RonnyA/nd-120/Logisim/readme.md

# Logisim files #

There are 4 sets of Logisim schematic files

* [DELILAH CPU](DELILAH-CPU/readme.md)
* [Decoder Gate Array](DECODE-GateArray/readme.md)
* [3202D CPU Board](CPU-BOARD-3202/readme.md)
* [SMD controller card 3044 - memory address and word count](ND-BUS-DEVICES/SMD-3044/readme.md)

## Screenshot of Logisim schematich - part of DELILAH

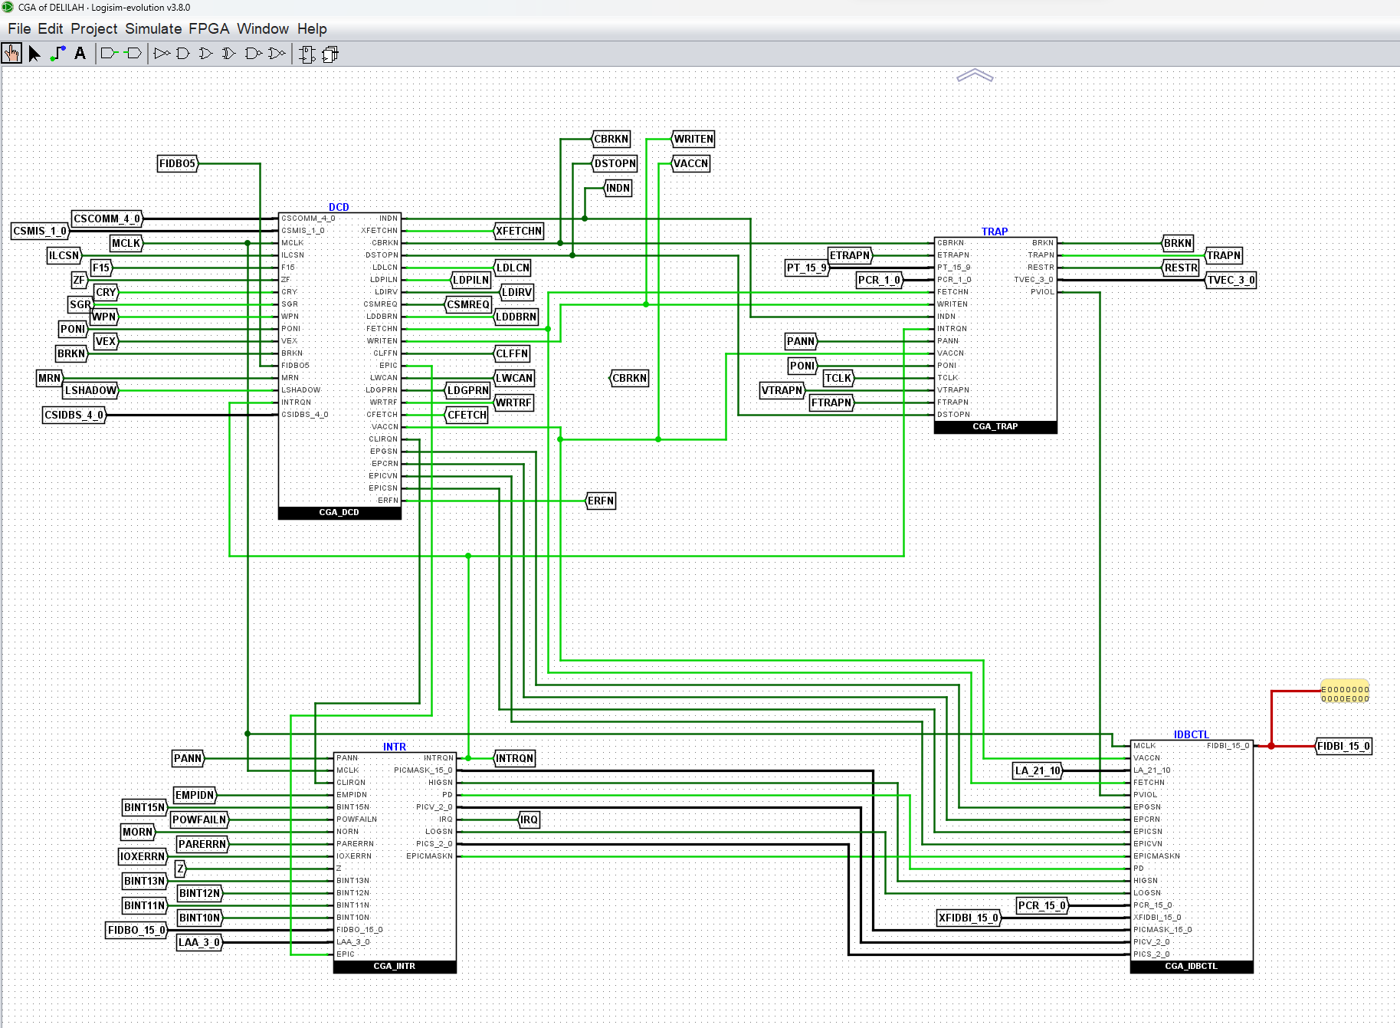
[picture p1: Logisim/Logisim-DELILAH.png]
Logsim schematic - part of DELILAH
