RonnyA/nd-120/DesignDocuments/DELILAH-CPU/readme.md

# DELILAH CPU

 This folder contains the 106 page design document for the CPU.
* [DELILAH Schematic Design ](DELILAH.pdf)
