RonnyA/nd-120/DesignDocuments/Other/Readme.md

# Other design documents

This folder contains low DPI (200 DPI) scan of two complete binders with design documents for the ND-120.
They contain multiple versions of the 3202 CPU board, and if you want the high-res scan (600 DPI) its in another folder.

* [Binder 1](Binder-1.pdf)
* [Binder 2](Binder-2.pdf)
