RonnyA/nd-120/Code/68705/readme.md

# PROM Dumps

* ND-120 PANEL - ONBOARD PANEL CONTROLLER - MC68705U3
* ND-5000C Panel

## ND-120 CPU BOARD - ONBOARD PANEL CONTROLLER - MC68705-U3

The panel controller controls the LCD display in the panel, and handles button presses and sends that to the CPU board.

### Schematic

Sheet 40 of the CPU Board has the MC68705 connectins

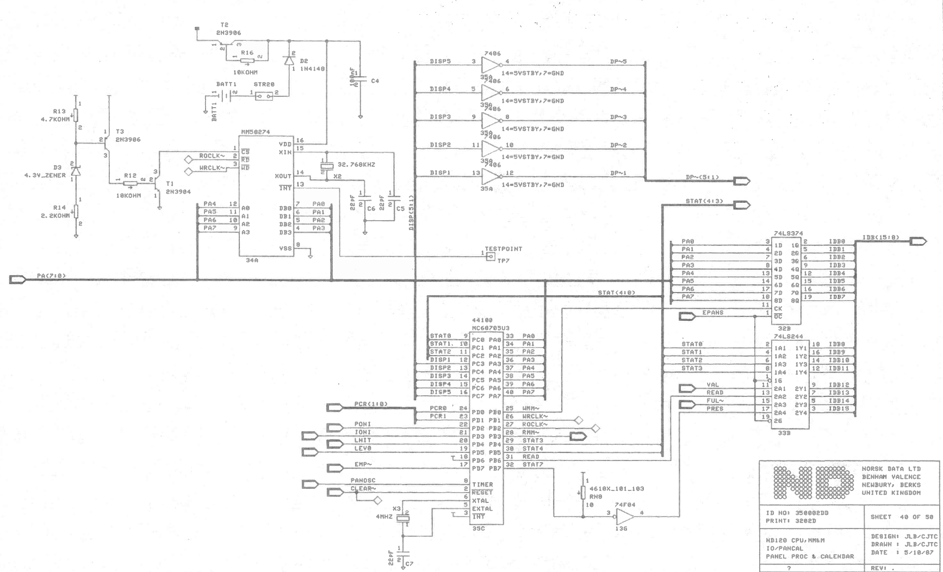
[picture p3: Code/68705/3202D_PANCAL_SHEET40.png]
Schematich for 68705


### U3 Block Diaggram

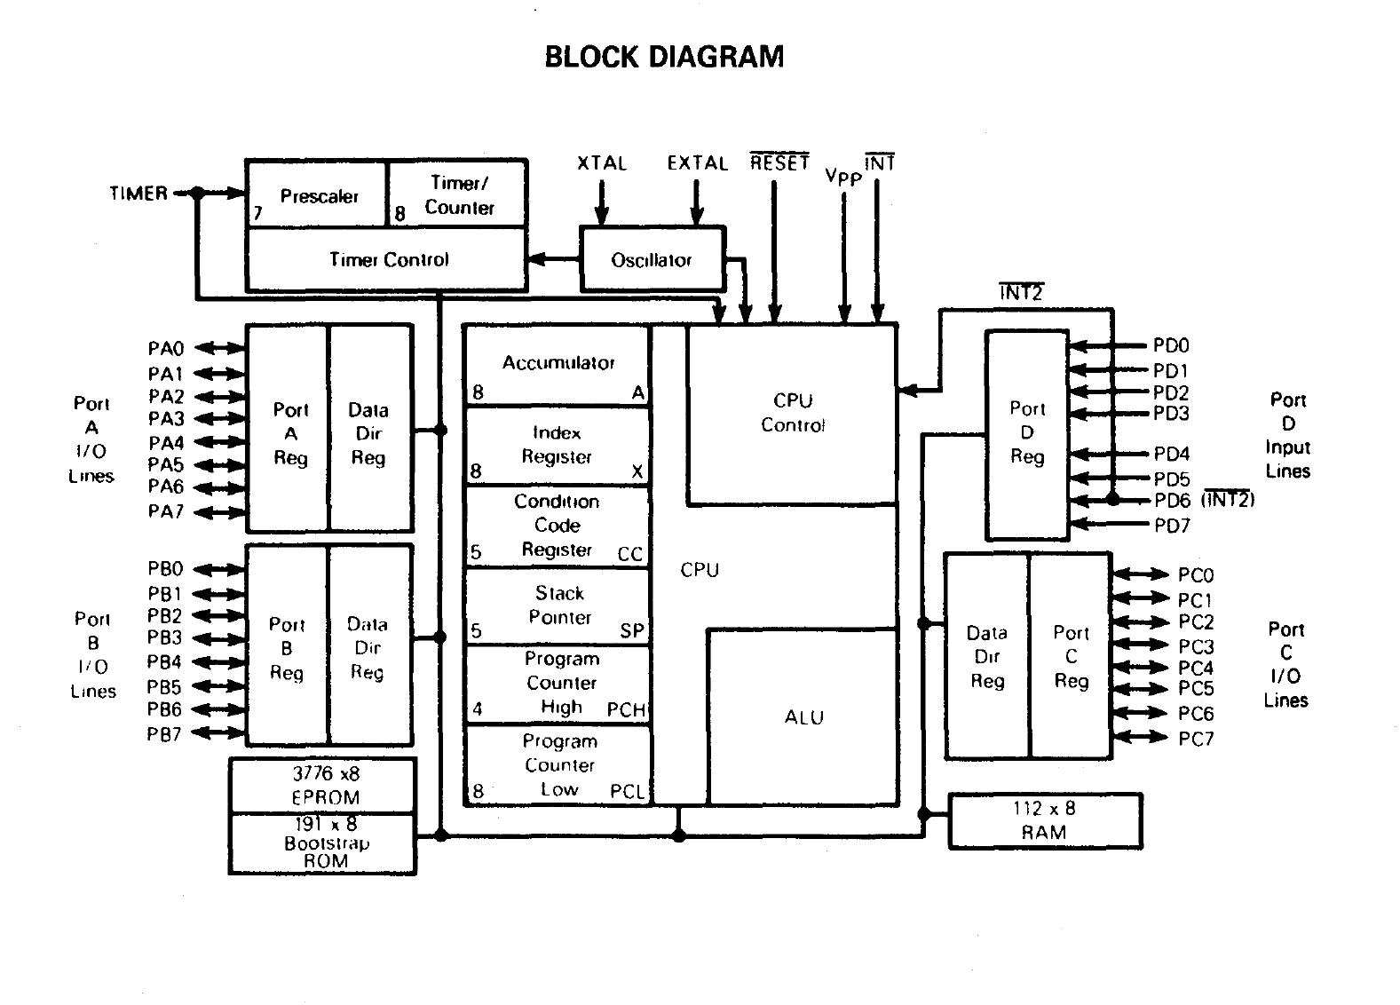
[picture p4: Code/68705/68705U3_Block_Diagram.png]
68705 U3 Block Diaggram


### U3 PROM

[Binary PROM dump from MC68705-U3 on ND-120 CPU Board](MC68705U3_35C.BIN)

### U3 Analysis of functionality

[Analysis of the code in the PROM](U3/Analysis-U3.md)

### U3 Analysis of commands

[Analysis of commands and responses](U3/Commands-U3.md)

### U3 Dissasembly

PROM dump reverse engineered with Ghidra

[68705-U3 Dissassembly PDF](U3/U3-Dissassembly.pdf)

### U3 C code

Reverse engineered C code (draft)
[68705-U3 as C code](U3/C-code-u3.md)

-----

## The ND-5000C PANEL - MC68705-P3

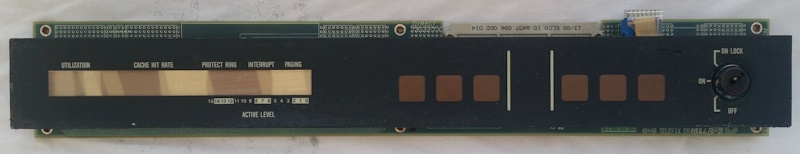
[picture p5: Code/68705/ND-5000C-PANEL.png]
Panel Operator including display


### Panel Controller

The panel uses an MC68705P3 (Which is not the same as the U3 used on the ND-120 CPU board.)
The 68705P3 is 28 pins with 3 ports (PORT A,B and C)

Reference NORSK-DATA.COM:

* [323165 - PCB 1844 - Panel Operator including display, ND-5000C](http://www.norsk-data.com/hardware/nd-other/nd-323165.html)
* [324494 - PCB 1834 - Panel Control](http://www.norsk-data.com/hardware/nd-other/nd-324494.html)
* [xxxxxx - PCB xxxx - LCDs](http://www.norsk-data.com/hardware/nd-other/nd-LCD.html)
* [324147 - PCB 1844 - Telefix/Driver Comson](http://www.norsk-data.com/hardware/nd-other/nd-324147.html)
* [CY7C401 - FIFO](http://www.norsk-data.com/library/libother/extern/CY7C401.pdf)

### P3 PROM

[Binary PROM dump from MC68705-R3](P3/ND-5000C-MC68705P3.BIN)

### P3 Analysis

[Analysis of the code in the R3 PROM](P3/P3-COMPLETE.MD)

### R3 Dissasembly

PROM dump reverse engineered with Ghidra

[68705-P3 Dissassembly PDF](P3/P3-Dissassembly.pdf)

### R3 C code

Reverse engineered C code (draft)
[68705-P3 as C code](P3/C-code-p3.md)

-----

# 6805 CPU doc

* MC68705P3, 18 page PDF - [MC68705PR 8-BIT EPROM Microcomputer Unit](6805/MC68705P3.PDF)
* 6805P_Oct84, 15 page PDF - [MC68(7)05P SERIES 8-BIT MICROCOMPUTERS](6805/6805P_Oct84.pdf)
* 6805_Users_Manual_2ed_1983, 263 page PDF - [M6805 HMOS/M146805 CMOS FAMILY USERS MANUAL](6805/6805_Users_Manual_2ed_1983.pdf)
* Motorola DL139, 995 page PDF (U3 from Page 3-684) -  [Microprocessor, Microcontroller and Peripheral - Volume I](6805/1988MicroprocessorMicrocontrollerandPeripheralDataVolume1.410212374.pdf)
