RonnyA/nd-120/Verilog/CPU-BOARD-3202/circuit/BIF_DPATH_PPNLBD_14/readme.md

# BIF / DPATH / PPNLBD

BIF PPN TO LBD

## CPU Board 3202D - Sheet 14

### Test program verification

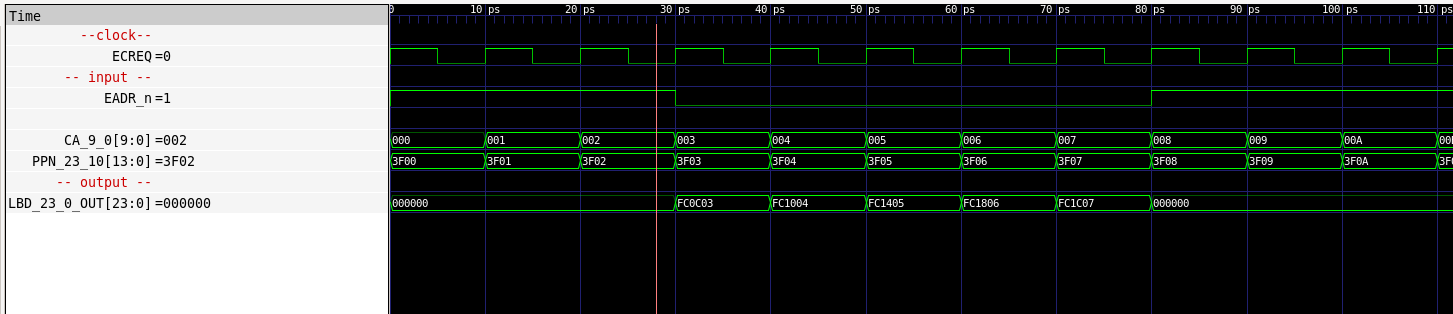
[picture p9: Verilog/CPU-BOARD-3202/circuit/BIF_DPATH_PPNLBD_14/gtkwave.png]
Screenshot from GTKWave
