RonnyA/nd-120/Verilog/Shared/support/SC2661_UART/readme.md

# SC2661 UART

The SC2661 is a UART (Universal Asynchronous Receiver/Transmitter) chip

### Test program verification

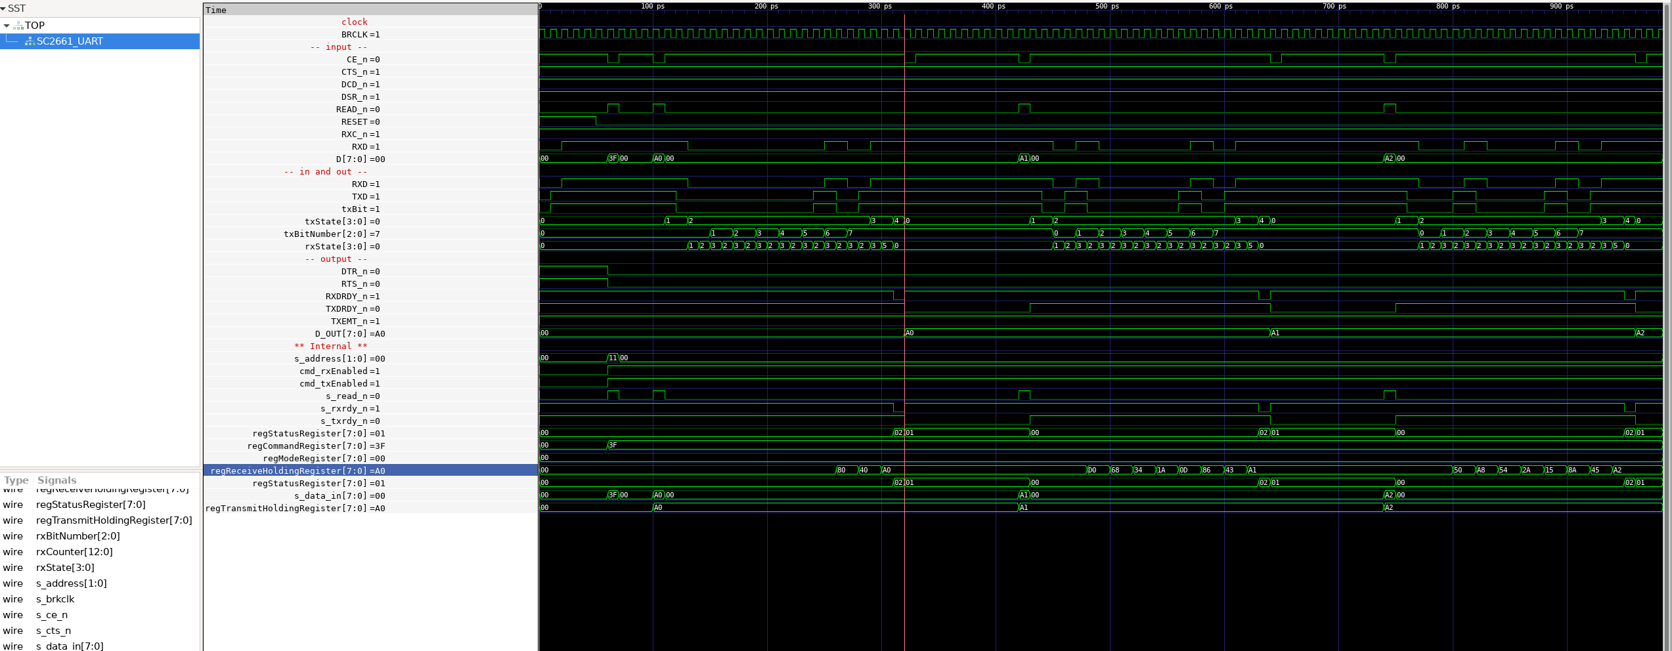
[picture p12: Verilog/Shared/support/SC2661_UART/gtkwave.png]
Screenshot from GTKWave
