RonnyA/nd-120/Verilog/CPU-BOARD-3202/circuit/CPU_MMU_24/readme.md

# CPU/MMU      

MMU TOP LEVEL  

## CPU Board 3202D - Sheet 24

### Test program verification

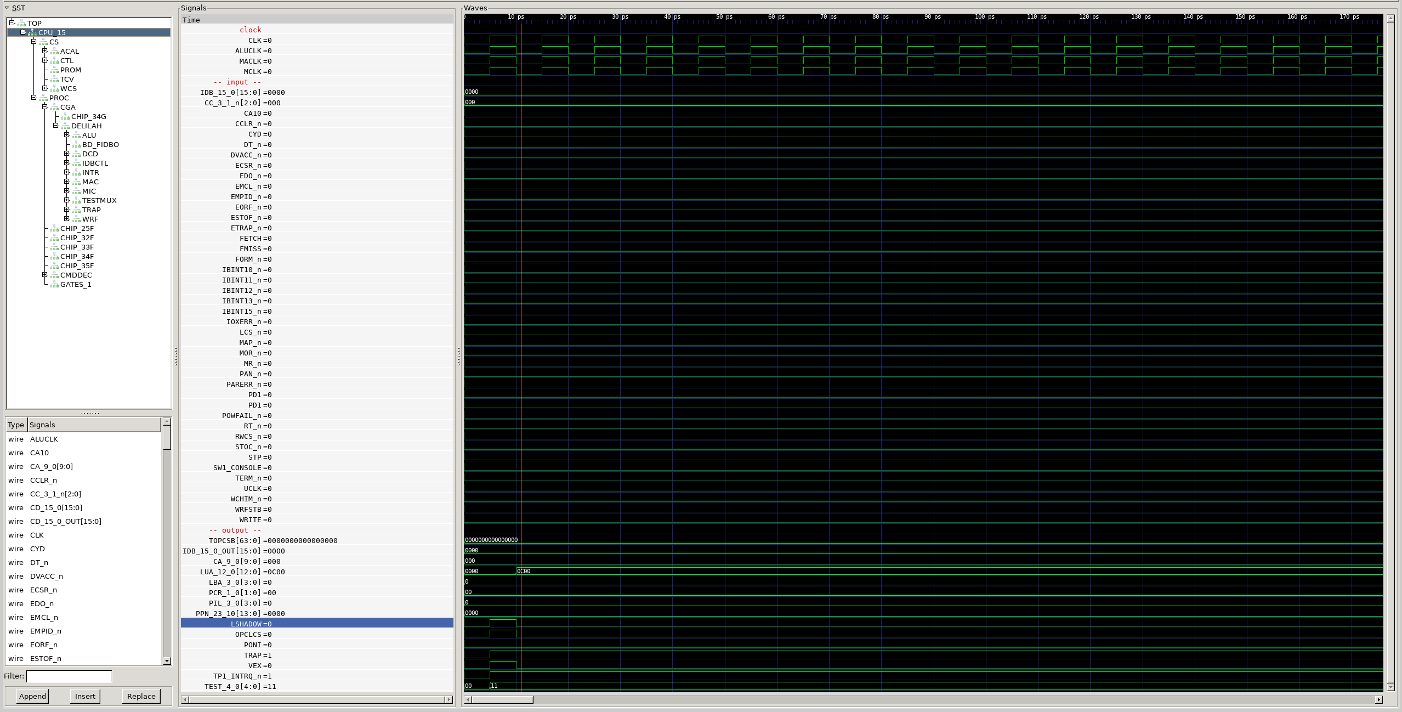
[picture p13: Verilog/CPU-BOARD-3202/circuit/CPU_MMU_24/gtkwave.png]
Screenshot from GTKWave
