RonnyA/nd-120/Verilog/CPU-BOARD-3202/circuit/BIF_BCTL_SYNC_8/readme.md

# BIF/BCTL/SYNC   

IF SYNC     

## CPU Board 3202D - Sheet 6

### Test program verification

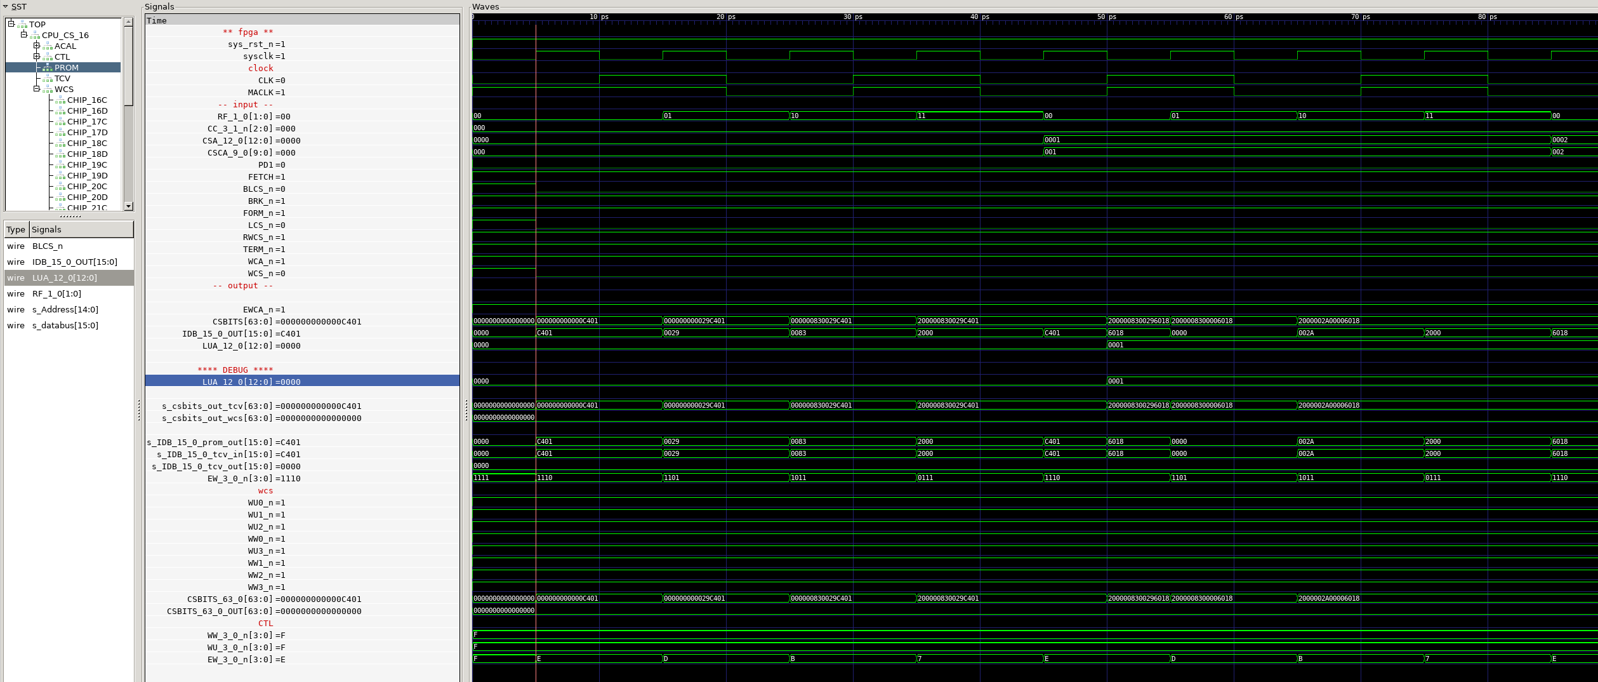
[picture p14: Verilog/CPU-BOARD-3202/circuit/BIF_BCTL_SYNC_8/gtkwave.png]
Screenshot from GTKWave
