RonnyA/nd-120/Verilog/CPU-BOARD-3202/circuit/CYC_36/readme.md

# CYCLE CONTROL (CYC)

## CPU Board 3202D - Sheet 36

# Test program verification

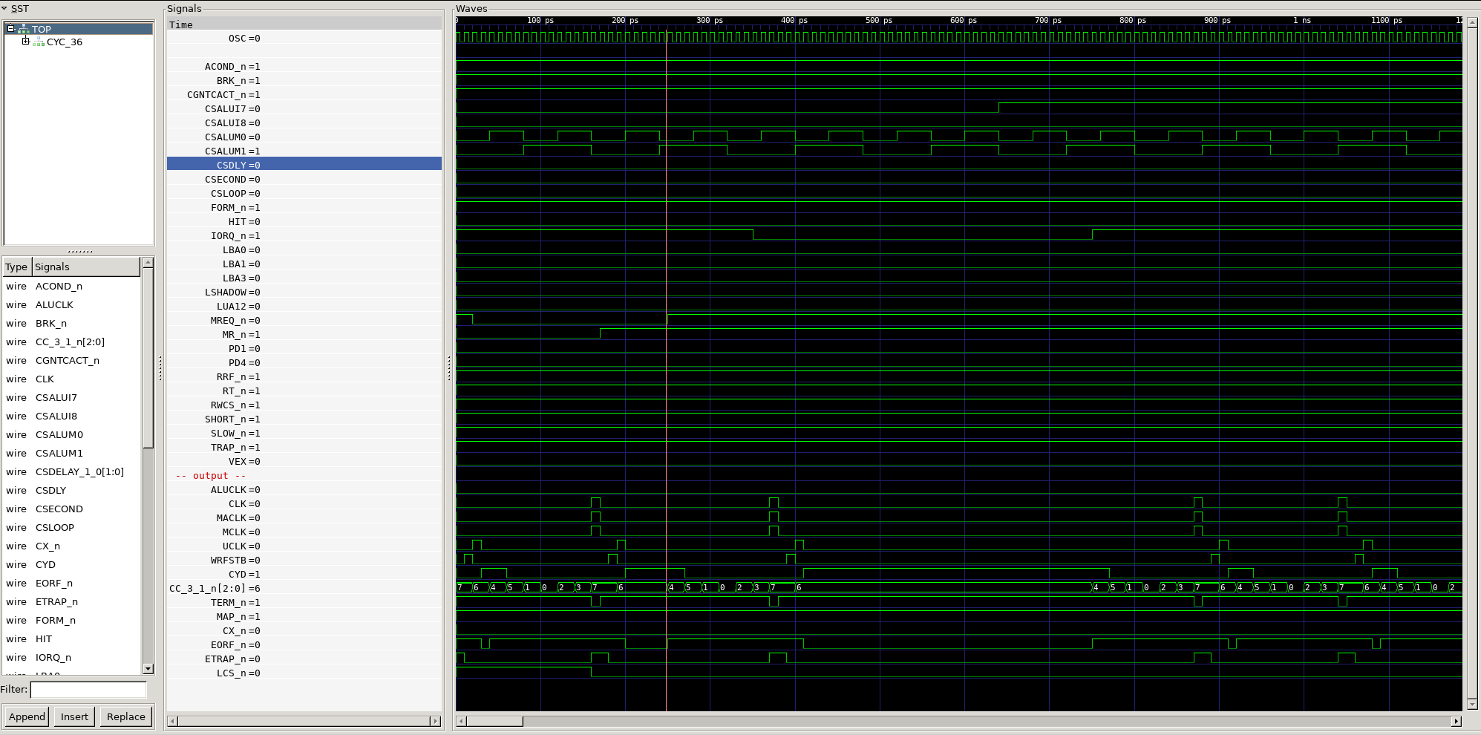
[picture p15: Verilog/CPU-BOARD-3202/circuit/CYC_36/gtkwave.png]
Screenshot from GTKWave
