RonnyA/nd-120/Verilog/CPU-BOARD-3202/circuit/CPU_15/readme.md

# CPU

CPU TOP LEVEL

## CPU Board 3202D - Sheet 15

### Test program verification

Screenshot from GTKWave
