RonnyA/nd-120/Verilog/CPU-BOARD-3202/circuit/ND3202D/readme.md

# CPU

DELILAH TOP LEVEL, CPU BOARD

## CPU Board 3202D - Sheet 1

### Test program verification

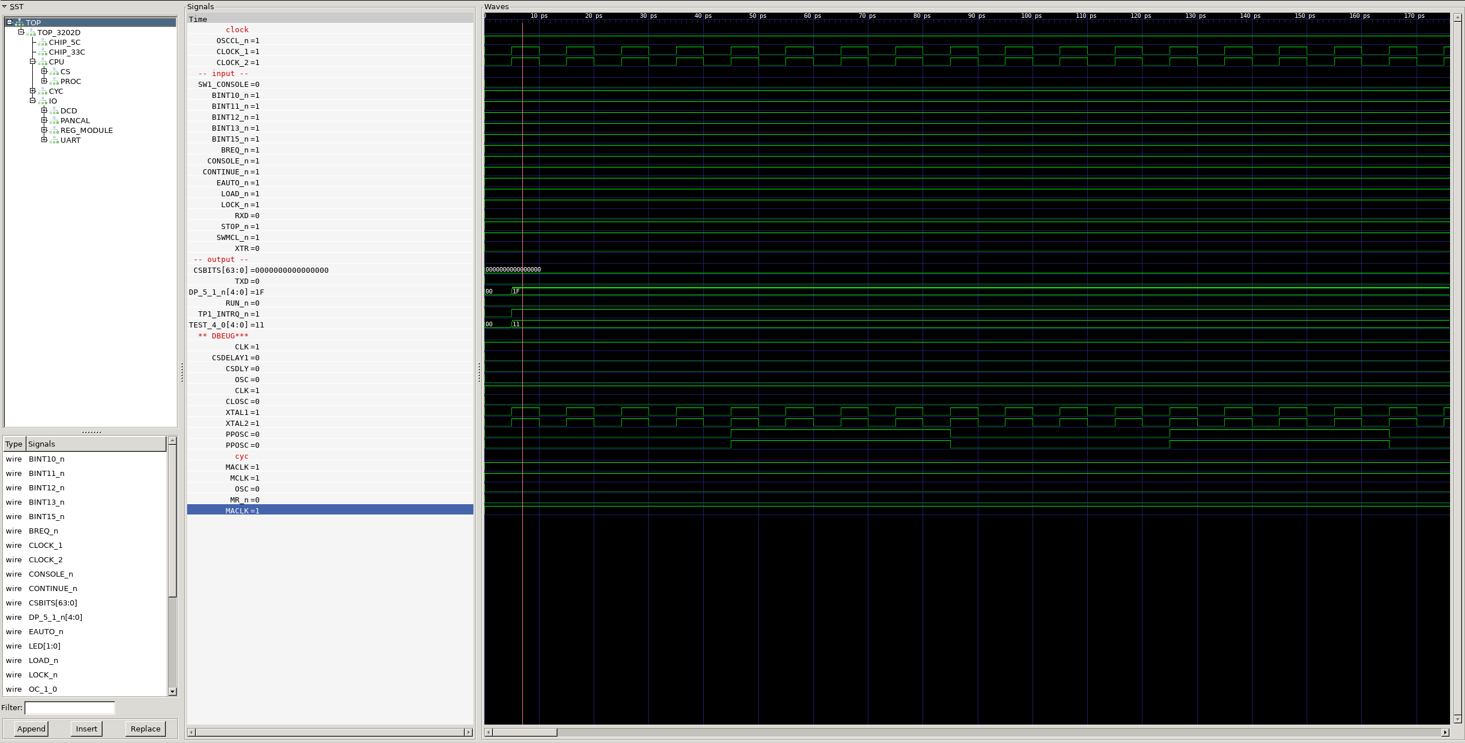
[picture p16: Verilog/CPU-BOARD-3202/circuit/ND3202D/gtkwave.png]
Screenshot from GTKWave
