RonnyA/nd-120/Verilog/CPU-BOARD-3202/circuit/CPU_CS_16/readme.md

# CPU/CS

CONTROL STORE

## CPU Board 3202D - Sheet 16

### Test program verification

Screenshot from GTKWave
