RonnyA/nd-120/Verilog/CPU-BOARD-3202/circuit/CPU_CS_TCV_20/readme.md

# CPU_CS_TCV_20

CONTROL STORE TRANSCEIVERS

## CPU Board 3202D - Sheet 20

### Test program verification

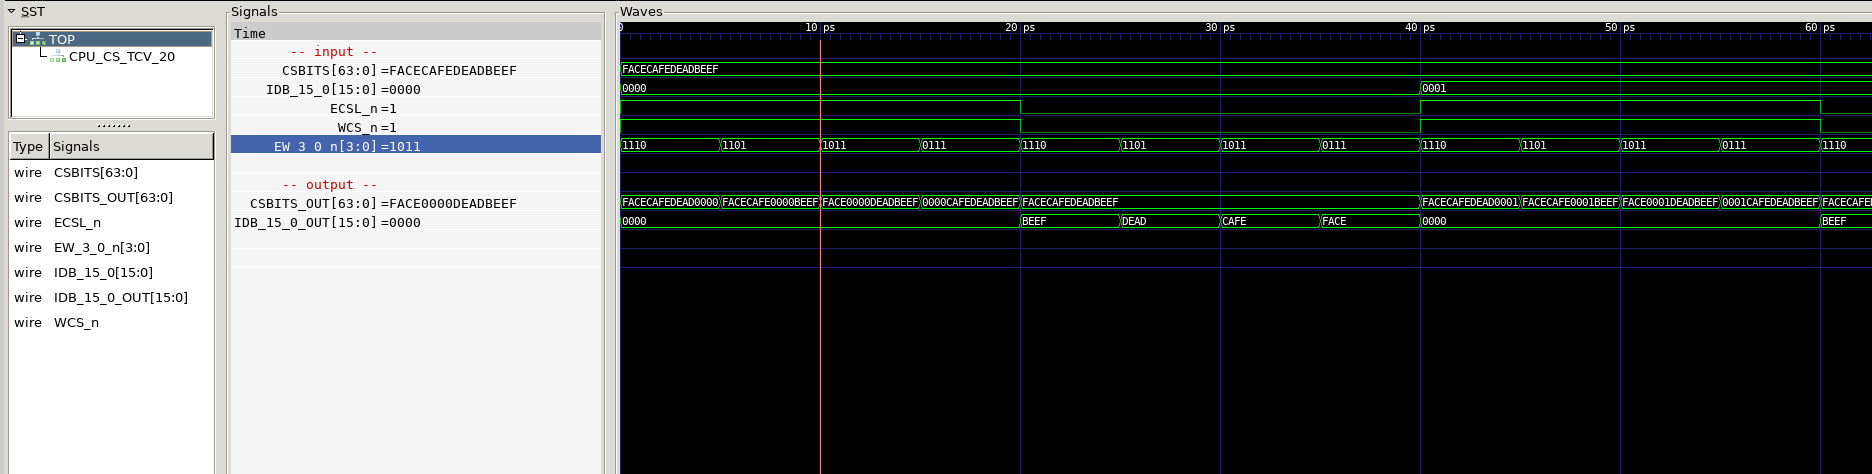
[picture p17: Verilog/CPU-BOARD-3202/circuit/CPU_CS_TCV_20/gtkwave.png]
Screenshot from GTKWave
