RonnyA/nd-120/Verilog/CPU-BOARD-3202/circuit/CPU_CS_WCS_21_22/readme.md

# CPU/CS/WCS

WRITABLE CONTROL STORE

## CPU Board 3202D - Sheet 19

### Test program verification

Test code writes 32 addressed to LUA and UUA. Output values while both are selected will be from LUA

Then reads the contents of UUA, same 32 addresses.

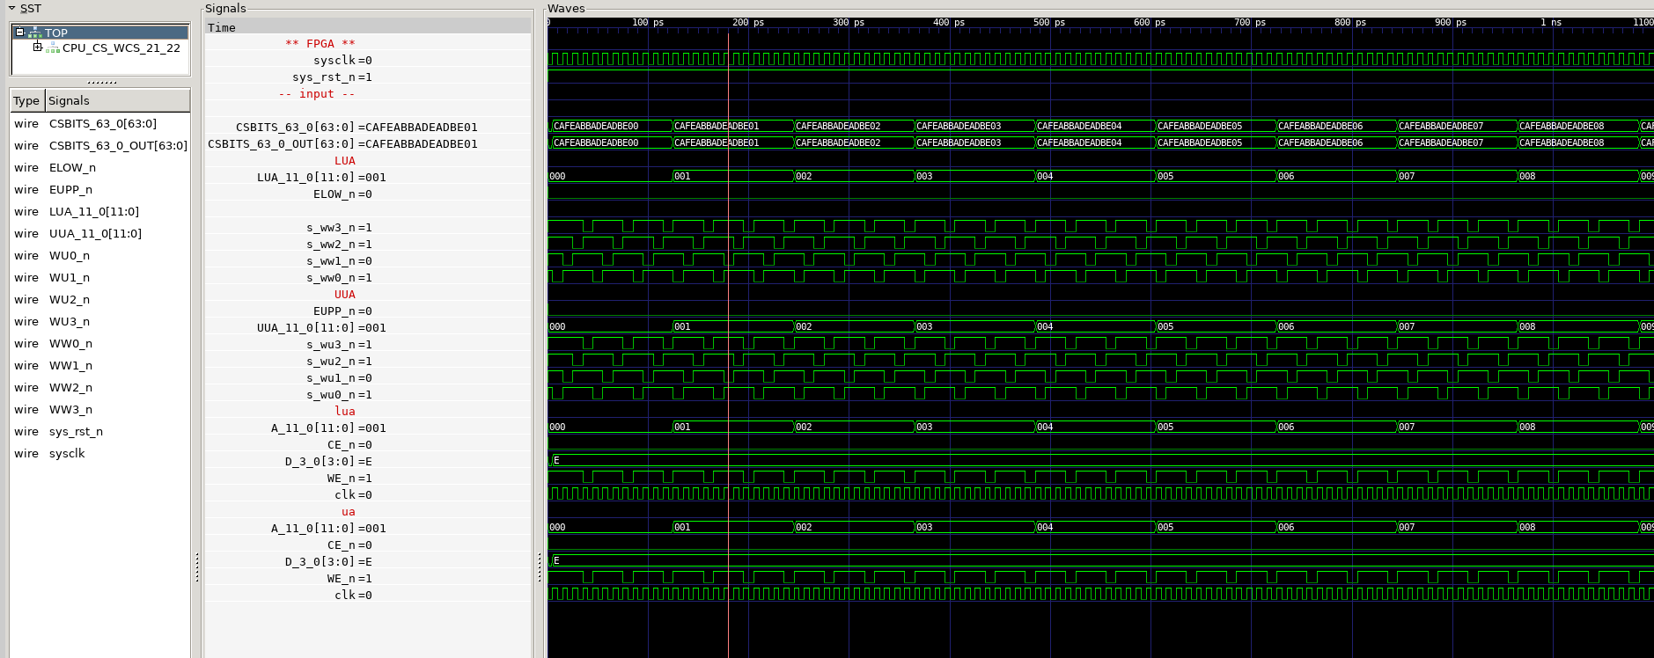
[picture p18: Verilog/CPU-BOARD-3202/circuit/CPU_CS_WCS_21_22/gtkwave.png]
Screenshot from GTKWave
