RonnyA/nd-120/Verilog/CPU-BOARD-3202/circuit/CPU_CS_PROM_19/readme.md

# CPU/CS/PROM

MICROCODE PROM

## CPU Board 3202D - Sheet 19

### Test program verification

The IDB values show the microcode. 16 bits.

RF selects which part of the 64 bit microcode, and LUA is the microcode address.

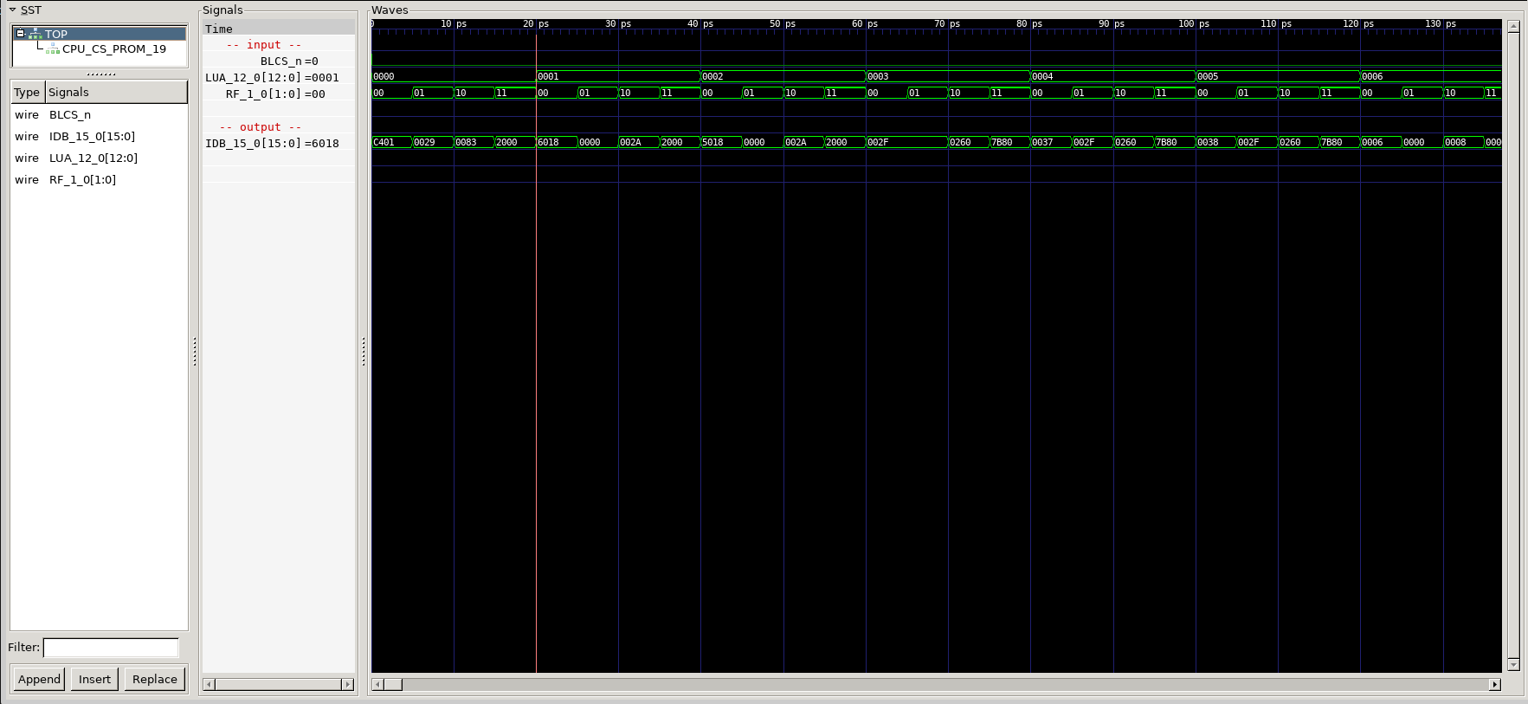
[picture p19: Verilog/CPU-BOARD-3202/circuit/CPU_CS_PROM_19/gtkwave.png]
Screenshot from GTKWave


We can see the microcode at address 0 is

<h1>0x200000830029C401</h1>

MICRO-DELI-INSTR Address 0
