RonnyA/nd-120/Verilog/CPU-BOARD-3202/circuit/CPU_CS_CTL_18/readme.md

# CPU/CS/CTL

CS CONTROL

## CPU Board 3202D - Sheet 18

### Test program verification

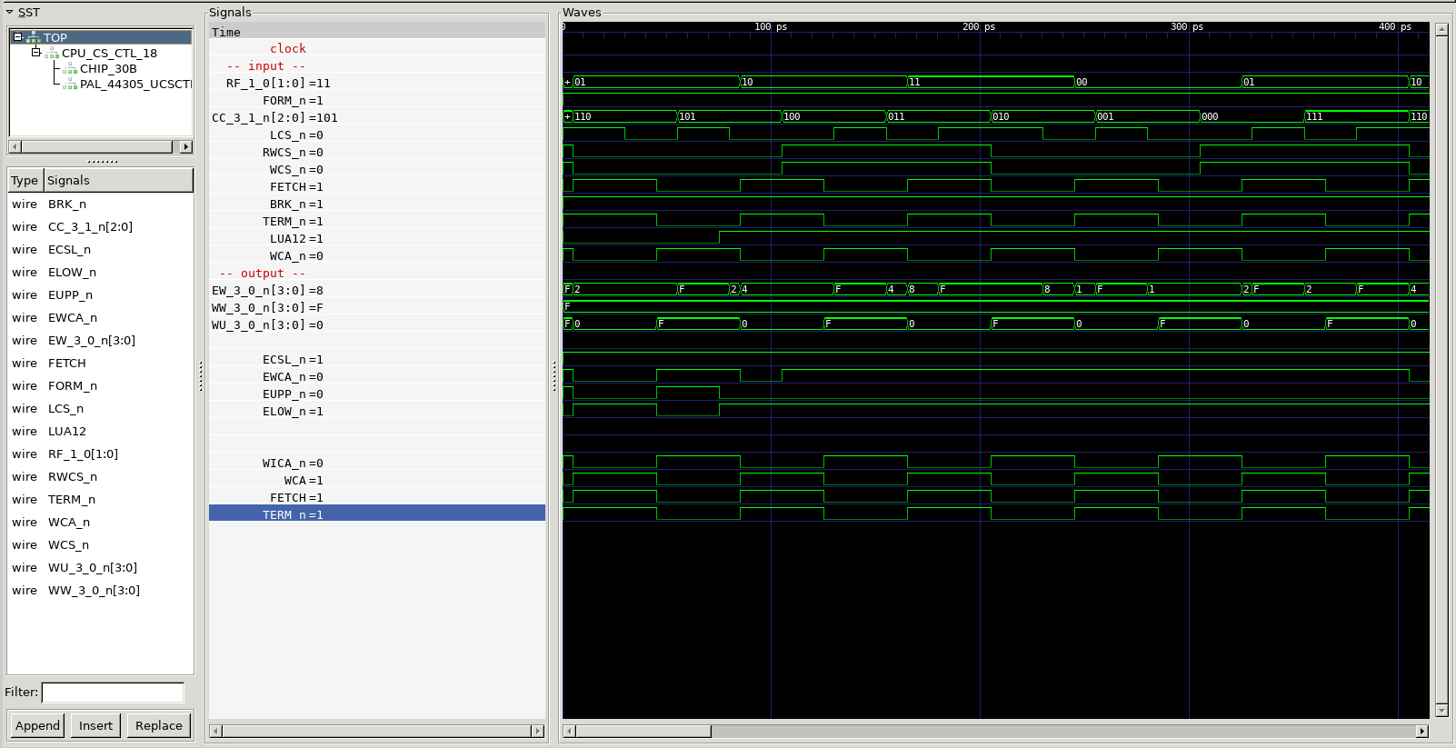
[picture p20: Verilog/CPU-BOARD-3202/circuit/CPU_CS_CTL_18/gtkwave.png]
Screenshot from GTKWave
