RonnyA/nd-120/Verilog/CPU-BOARD-3202/circuit/CPU_CS_ACAL_17/readme.md

# CPU/CS/ACAL

MICRO ADDR CALC

## CPU Board 3202D - Sheet 17

### Test program verification

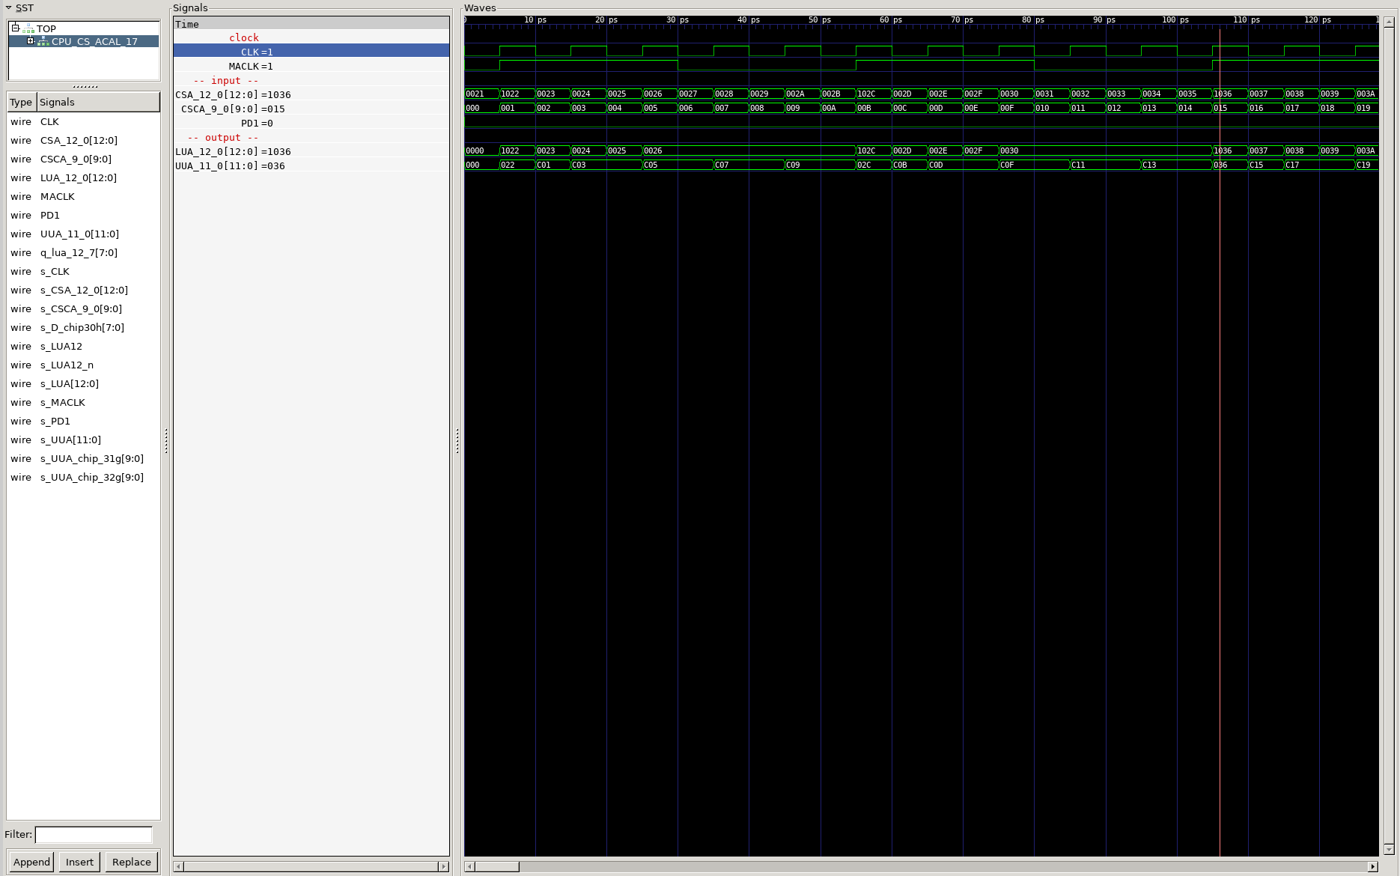
[picture p21: Verilog/CPU-BOARD-3202/circuit/CPU_CS_ACAL_17/gtkwave.png]
Screenshot from GTKWave
