RonnyA/nd-120/Verilog/CPU-BOARD-3202/circuit/CPU_PROC_32/readme.md

# CPU GATE ARRAY (CPU/PROC)
Processor Top Level

## CPU Board 3202D - Sheet 32

# (empty) Test program verification

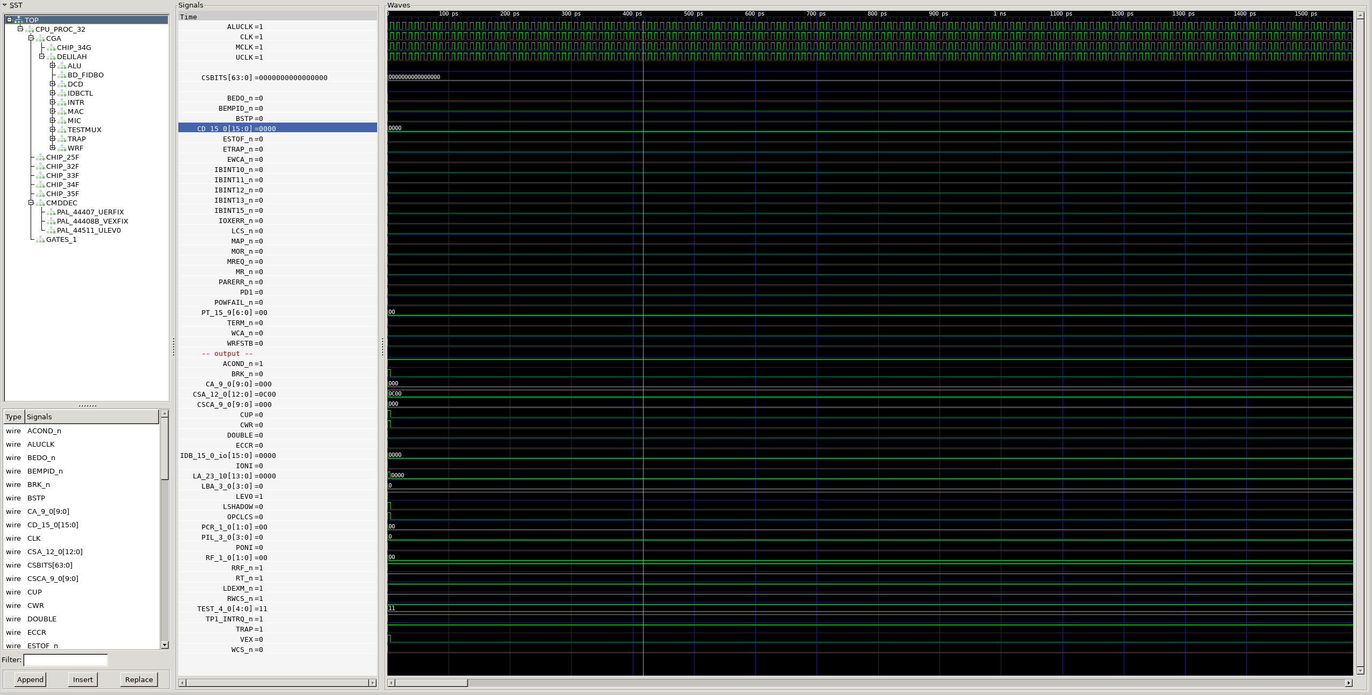
[picture p22: Verilog/CPU-BOARD-3202/circuit/CPU_PROC_32/gtkwave.png]
Screenshot from GTKWave


# Microcode CPU boot
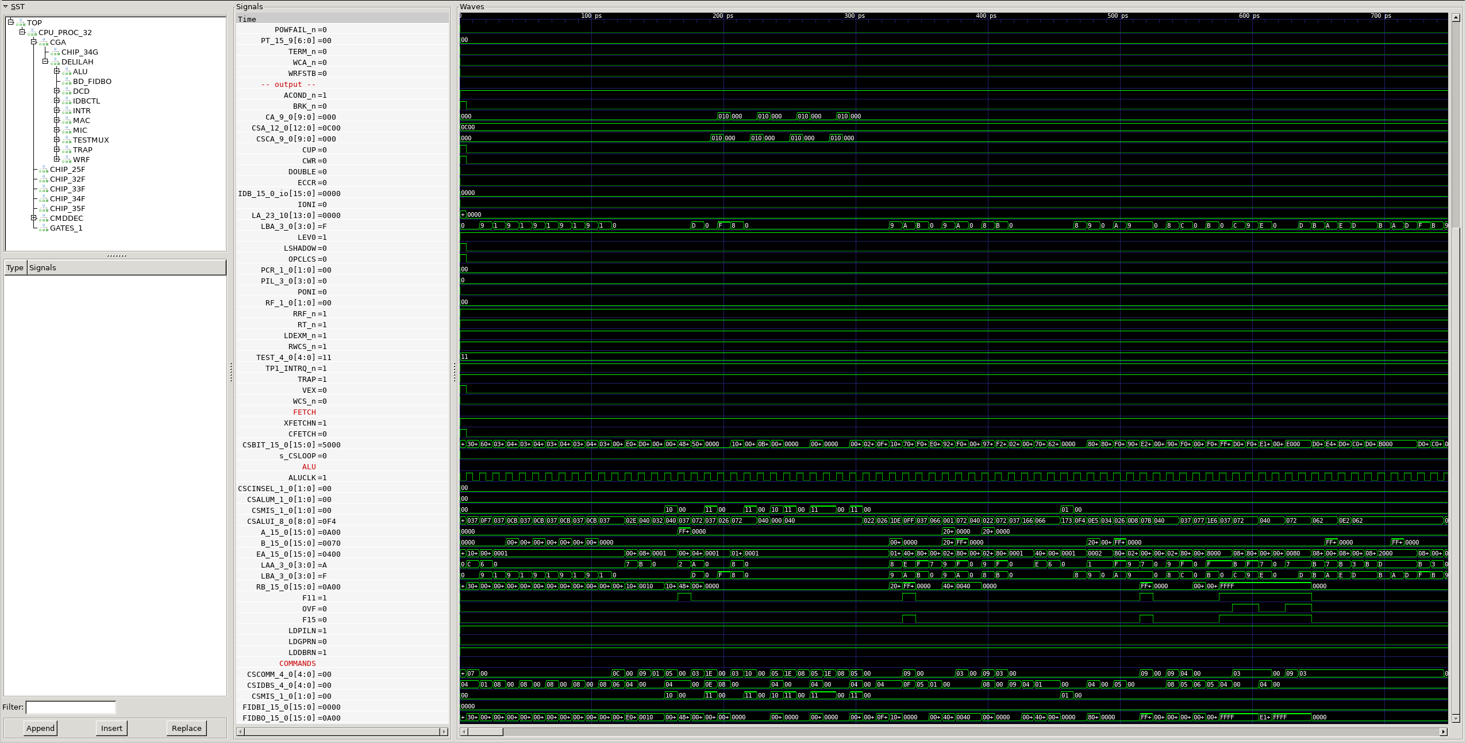
[picture p23: Verilog/CPU-BOARD-3202/circuit/CPU_PROC_32/gtkwave-microcode.png]
Screenshot from GTKWave


# CPU starting program (opcodes)
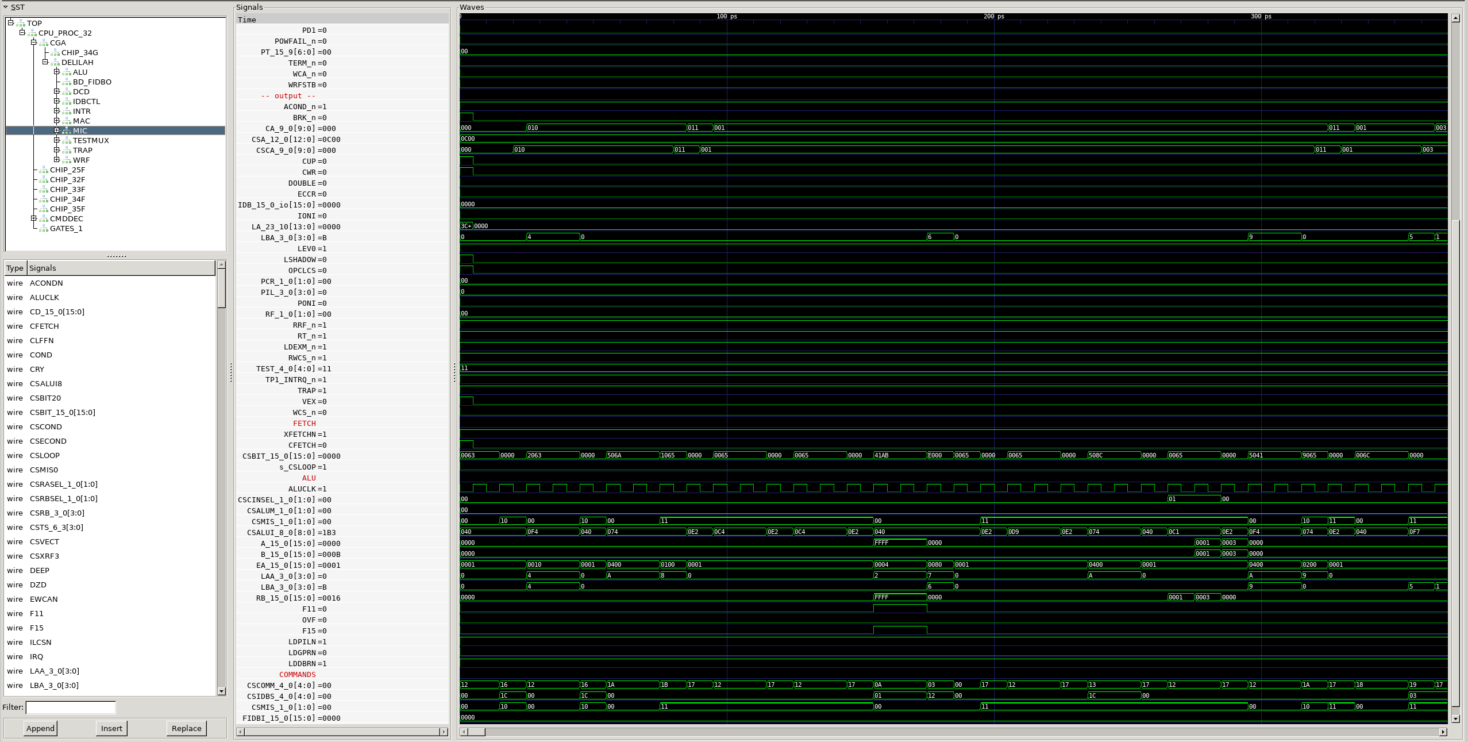
[picture p24: Verilog/CPU-BOARD-3202/circuit/CPU_PROC_32/gtkwave-opcodes.png]
Screenshot from GTKWave
