RonnyA/nd-120/Verilog/CPU-BOARD-3202/circuit/CPU_MMU_CSR_26/readme.md

# CPU/MMU/CSR

CACHE STATUS REG

## CPU Board 3202D - Sheet 26

### Test program verification

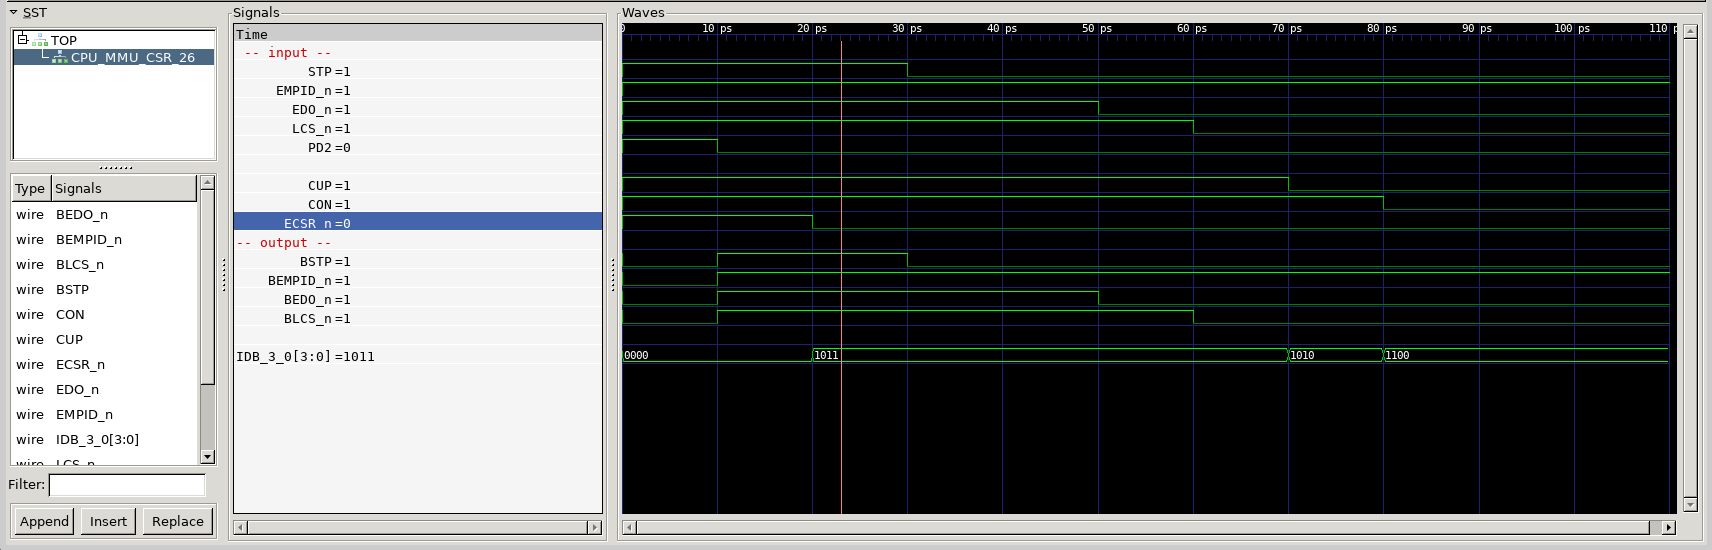
[picture p25: Verilog/CPU-BOARD-3202/circuit/CPU_MMU_CSR_26/gtkwave.png]
Screenshot from GTKWave
