RonnyA/nd-120/Verilog/CPU-BOARD-3202/circuit/CPU_MMU_PPNX_28/readme.md

# CPU/MMU/CSR

PPN to IDB

## CPU Board 3202D - Sheet 28

### Test program verification

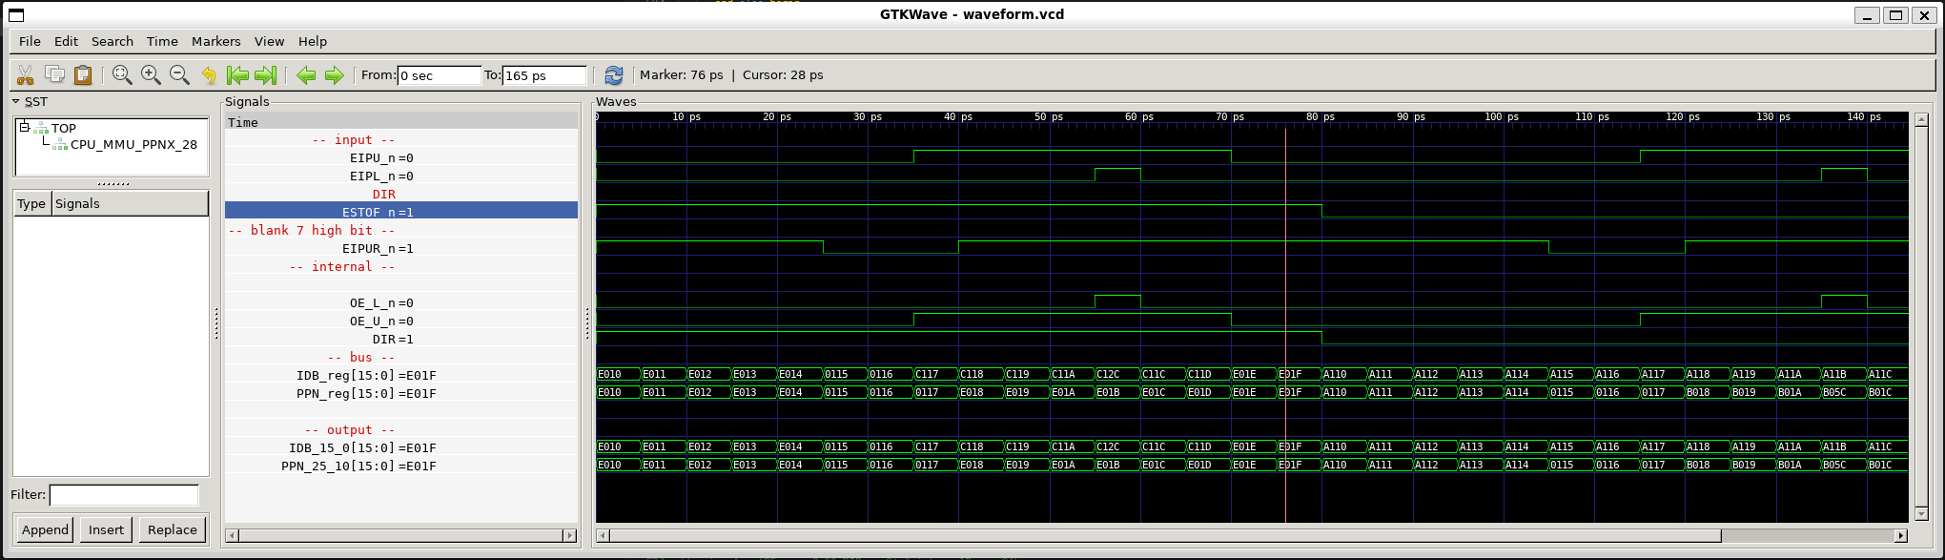
[picture p26: Verilog/CPU-BOARD-3202/circuit/CPU_MMU_PPNX_28/gtkwave.png]
Screenshot from GTKWave
