RonnyA/nd-120/Verilog/CPU-BOARD-3202/circuit/CPU_MMU_PT_29/readme.md

# CPU/MMU/PT

CACHE

## CPU Board 3202D - Sheet 29

### Test program verification

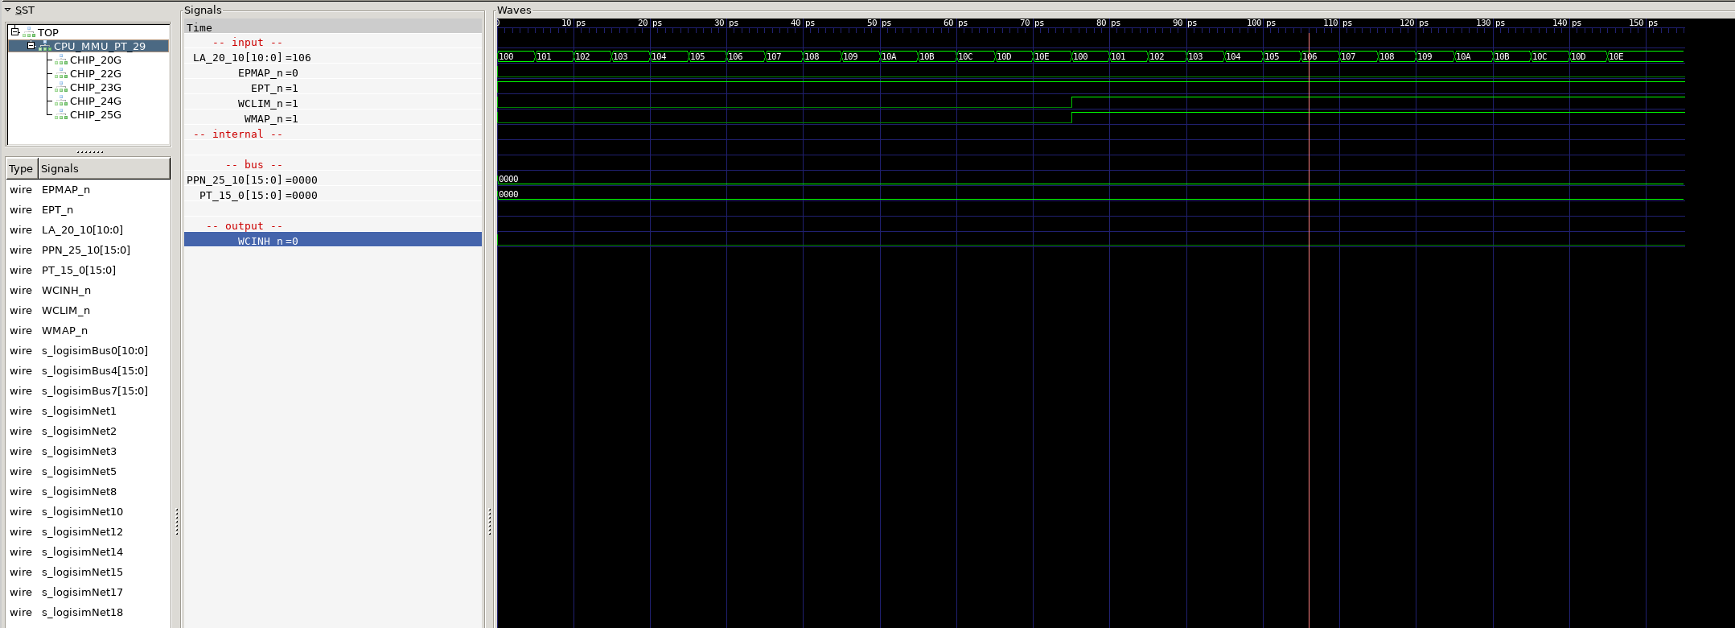
[picture p27: Verilog/CPU-BOARD-3202/circuit/CPU_MMU_PT_29/gtkwave.png]
Screenshot from GTKWave
