RonnyA/nd-120/Verilog/CPU-BOARD-3202/circuit/CPU_MMU_WCA_31/readme.md

# CPU/MMU/WCA

PPN TO CPN

## CPU Board 3202D - Sheet 38

### Test program verification

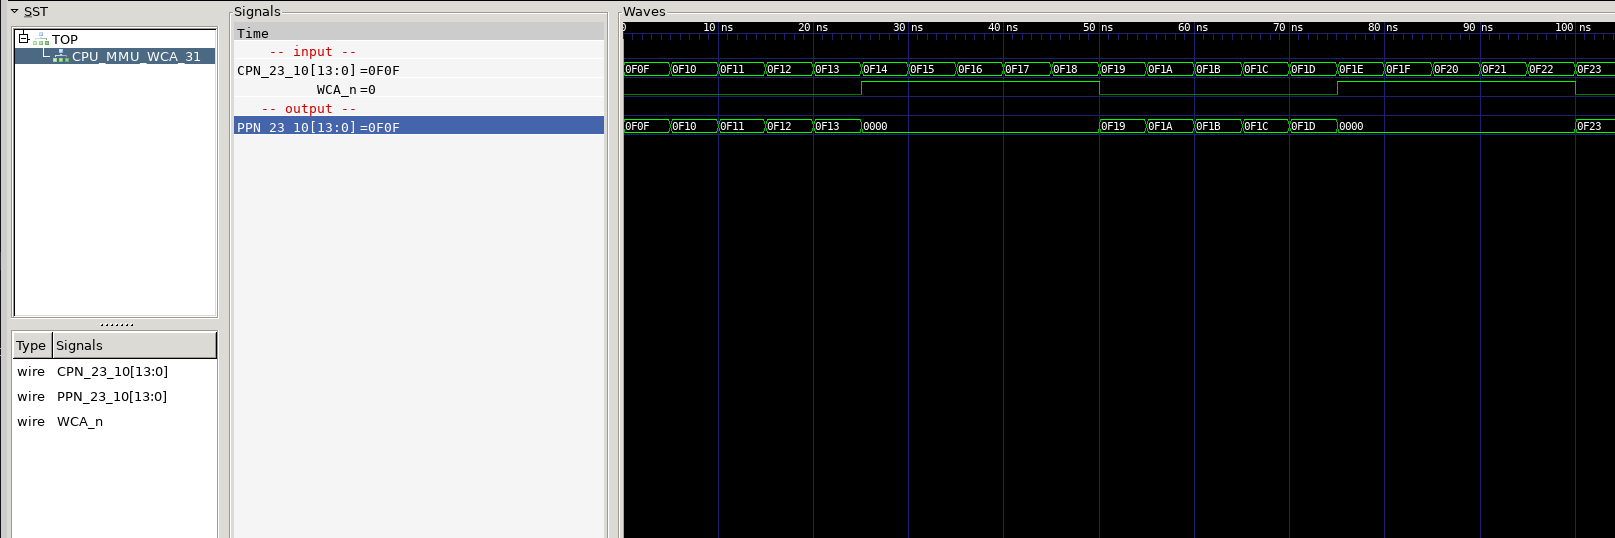
[picture p28: Verilog/CPU-BOARD-3202/circuit/CPU_MMU_WCA_31/gtkwave.png]
Screenshot from GTKWave
