RonnyA/nd-120/Verilog/CPU-BOARD-3202/circuit/CPU_MMU_HIT_27/readme.md

# CPU/MMU/HIT

HIT DETECT

## CPU Board 3202D - Sheet 27

### Test program verification

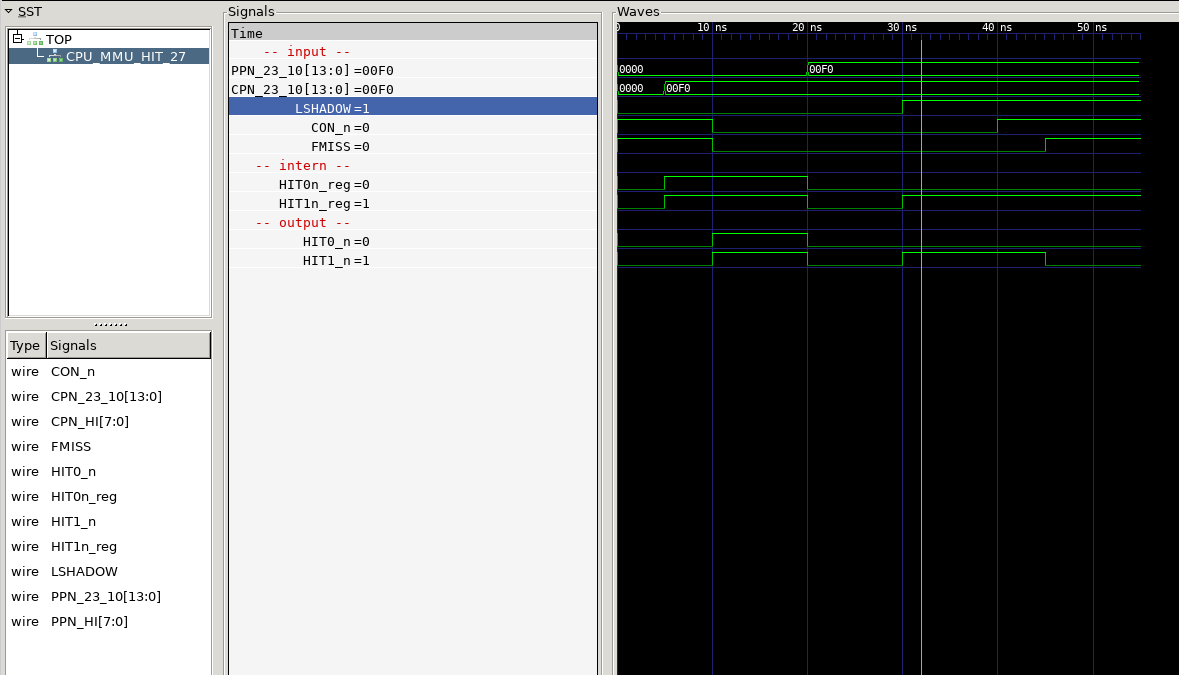
[picture p29: Verilog/CPU-BOARD-3202/circuit/CPU_MMU_HIT_27/gtkwave.png]
Screenshot from GTKWave
