RonnyA/nd-120/Verilog/CPU-BOARD-3202/circuit/IO_37/readme.md

# IO

## CPU Board 3202D - Sheet 37

### Test program verification

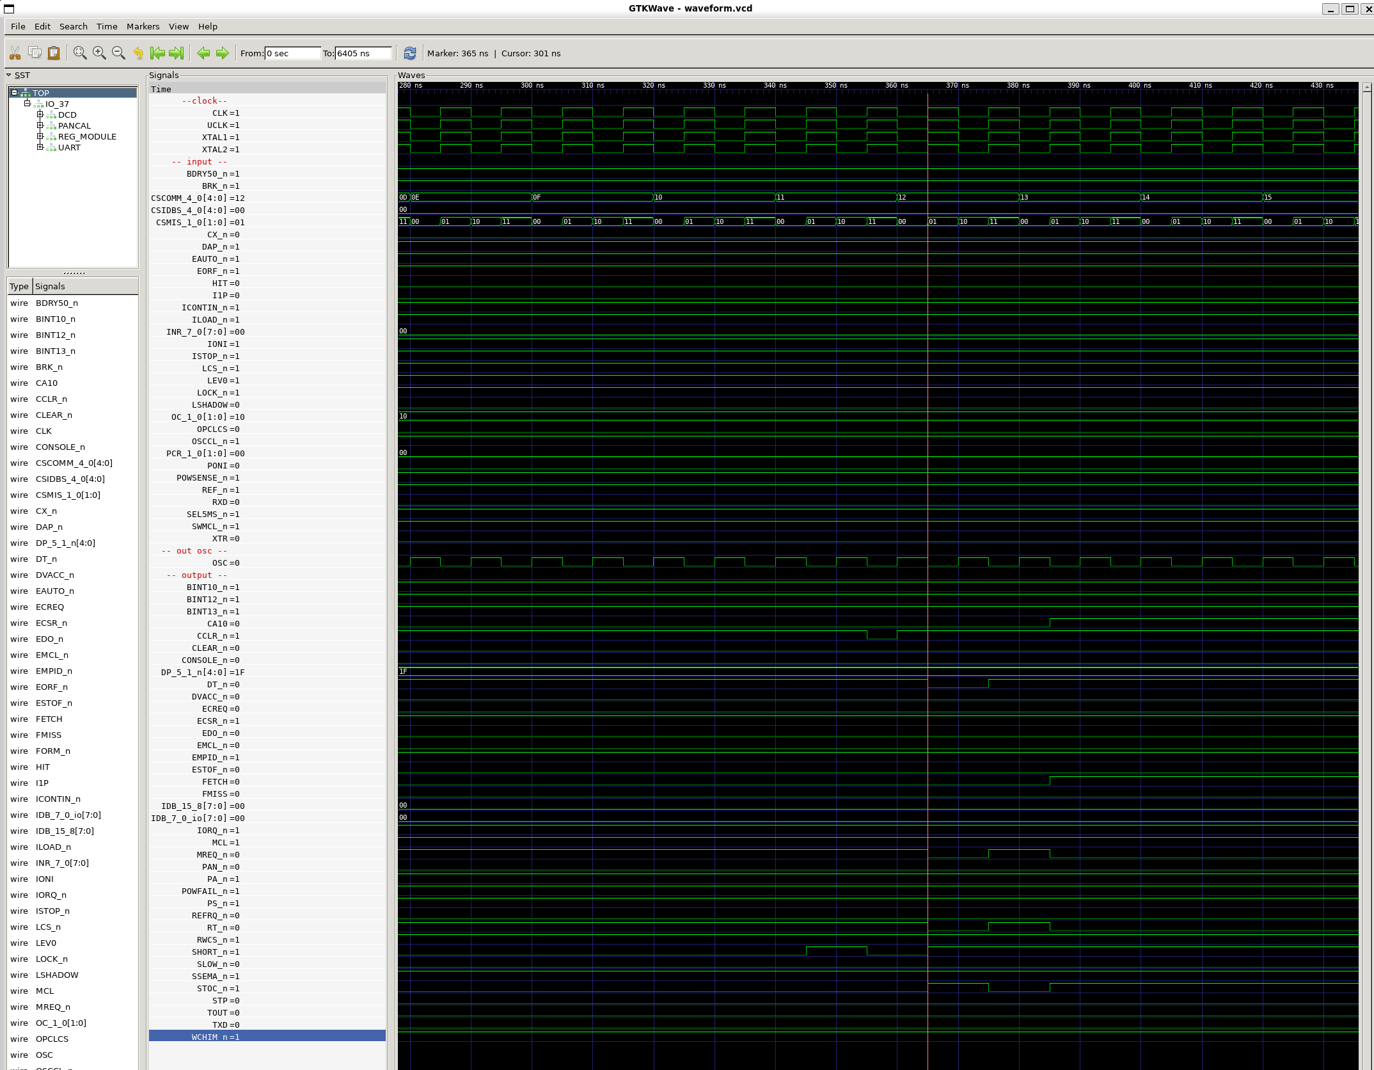
[picture p30: Verilog/CPU-BOARD-3202/circuit/IO_37/gtkwave.png]
Screenshot from GTKWave
