RonnyA/nd-120/Verilog/CPU-BOARD-3202/circuit/IO_DCD_38/readme.md

# IO DECODING  (IO/DCD)

Connecting to DGA (DECODE GATE ARRAY)

## CPU Board 3202D - Sheet 38

### Test program verification

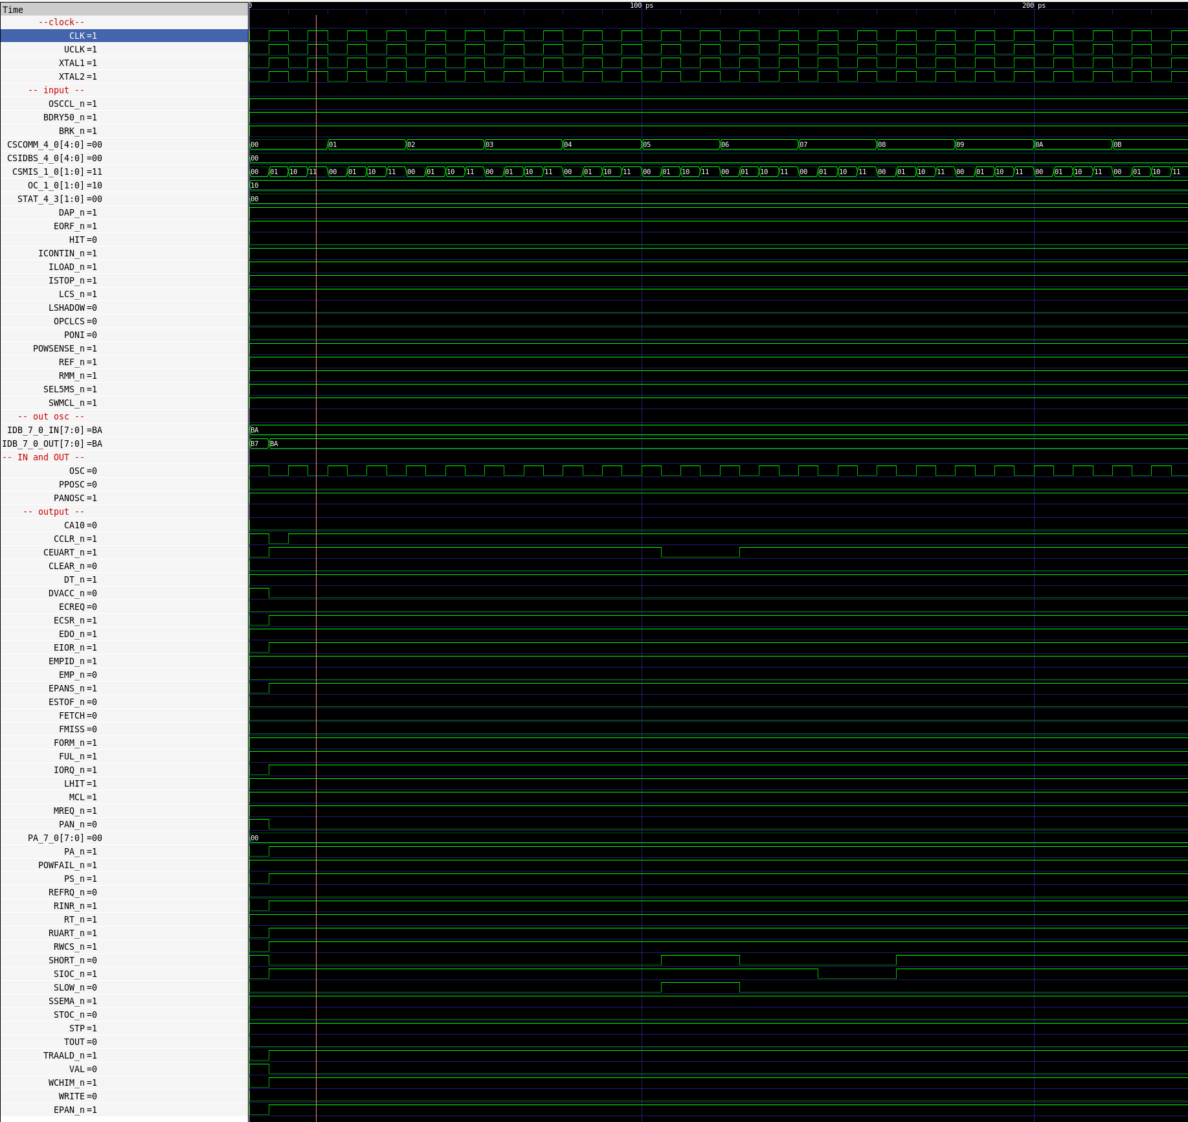
[picture p31: Verilog/CPU-BOARD-3202/circuit/IO_DCD_38/gtkwave.png]
Screenshot from GTKWave
