RonnyA/nd-120/Verilog/CPU-BOARD-3202/circuit/CPU_PROC_CGA_33/readme.md

# CPU GATE ARRAY (CPU/PROC/CGA)

## CPU Board 3202D - Sheet 33

# Test program verification

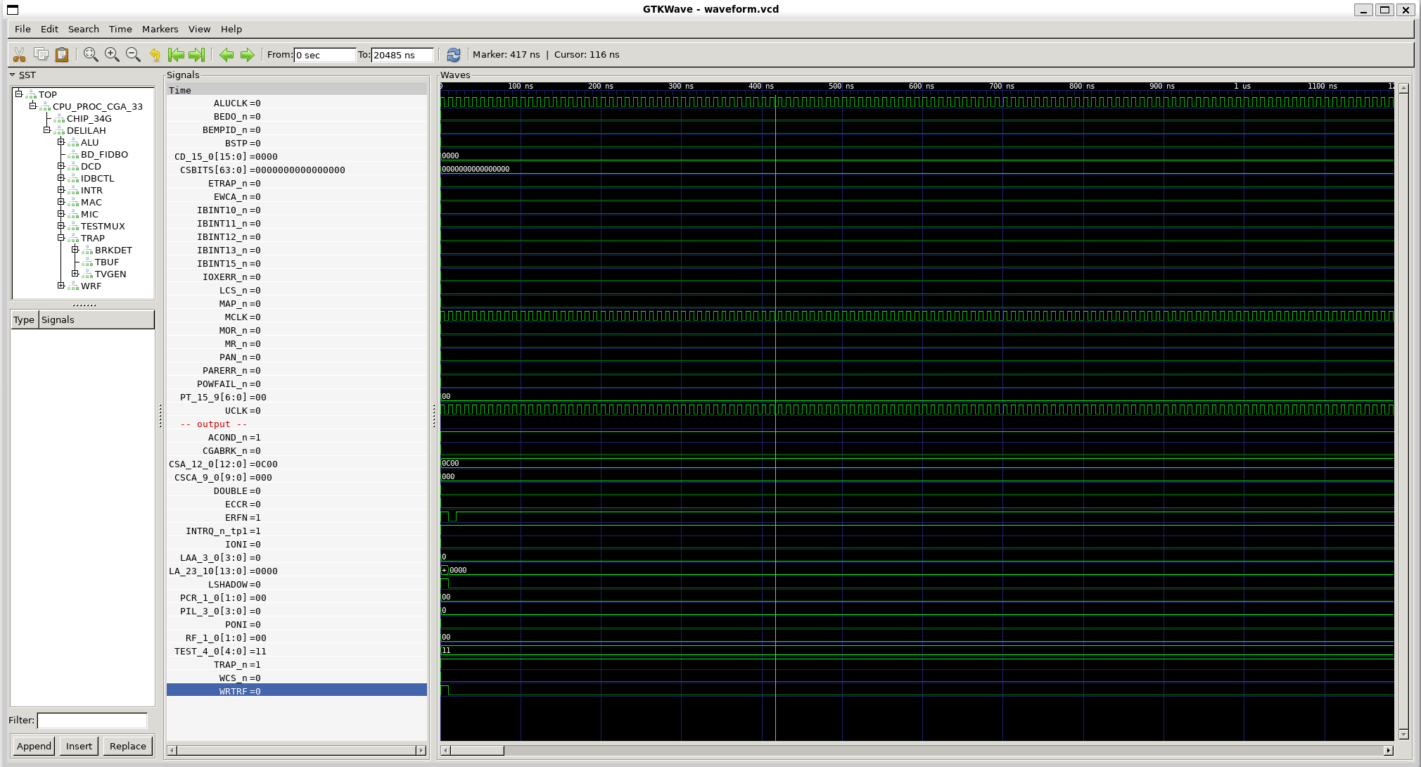
[picture p32: Verilog/CPU-BOARD-3202/circuit/CPU_PROC_CGA_33/gtkwave.png]
Screenshot from GTKWave
