RonnyA/nd-120/Verilog/CPU-BOARD-3202/circuit/CPU_PROC_CMDDEC_34/readme.md

# COMMAND & IDB DECODE (CMDDEC)

## CPU Board 3202D - Sheet 34

# Test program verification

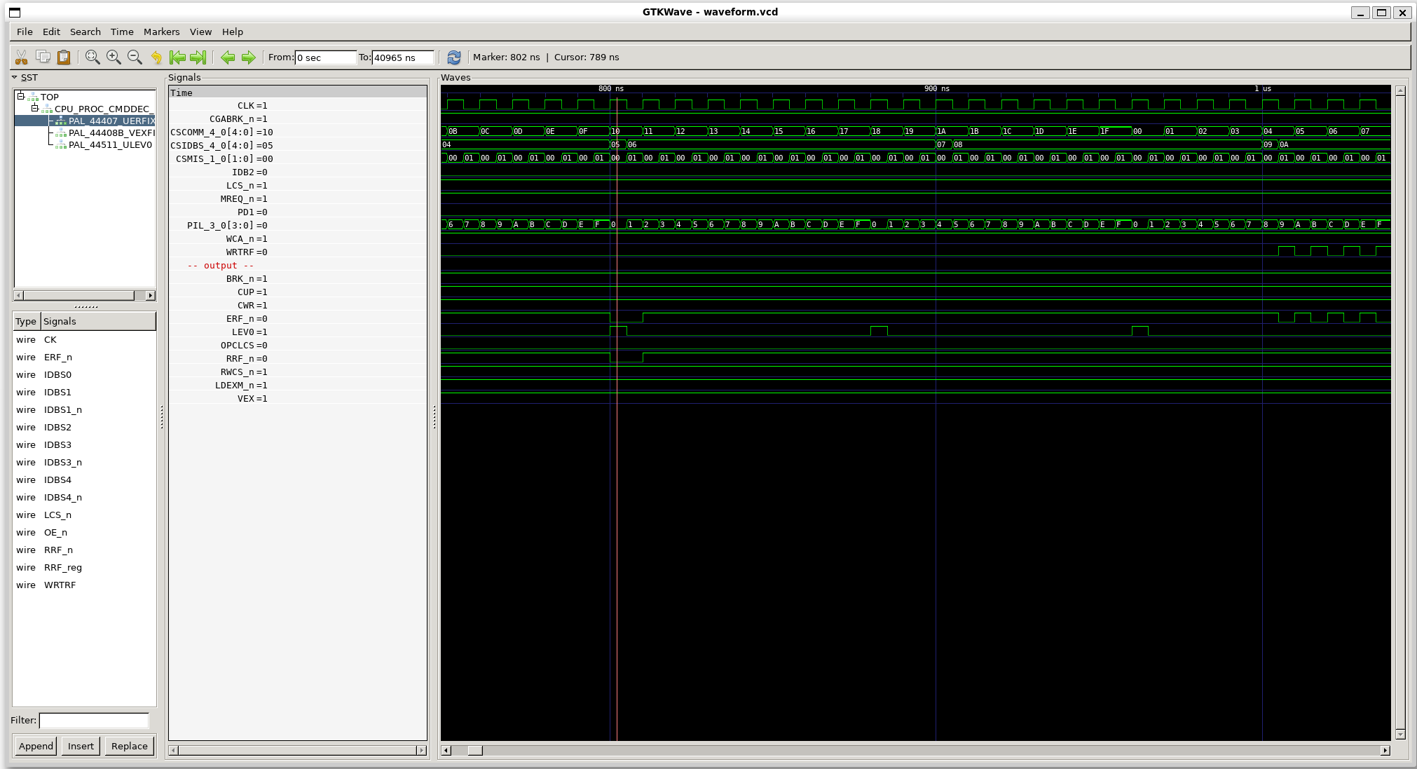
[picture p33: Verilog/CPU-BOARD-3202/circuit/CPU_PROC_CMDDEC_34/gtkwave.png]
Screenshot from GTKWave
