RonnyA/nd-120/Code/Microcode/images/3202_microcode_EPROMS.png

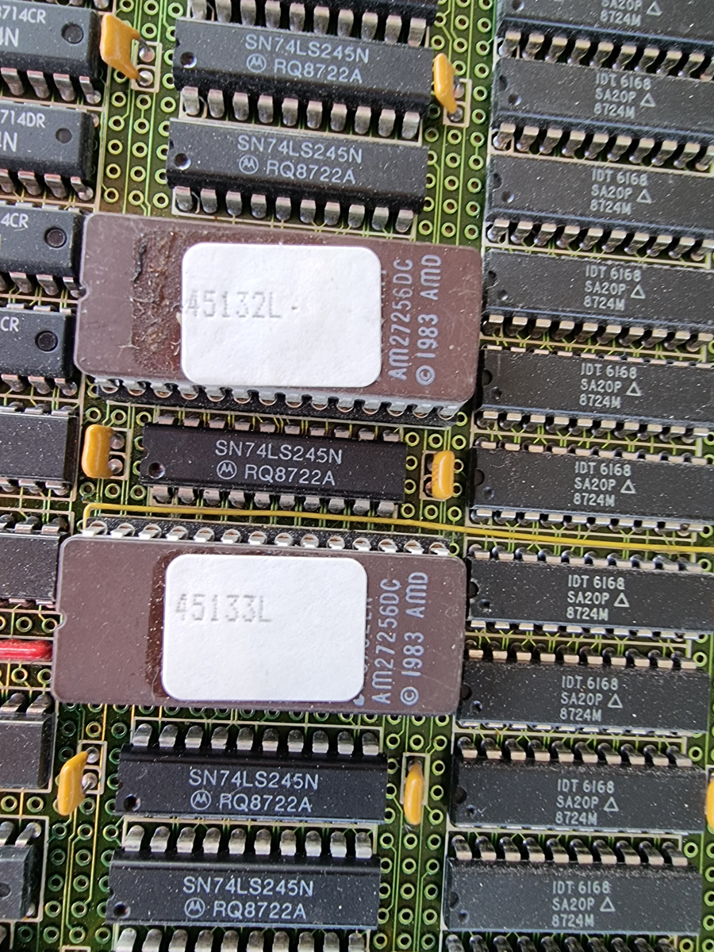
Code/Microcode/images/3202_microcode_EPROMS.png
