RonnyA/nd-120/DesignDocuments/DECODE-GateArray/F091.png

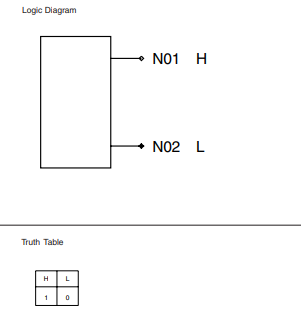
DesignDocuments/DECODE-GateArray/F091.png
