RonnyA/nd-120/DesignDocuments/DECODE-GateArray/F571.png

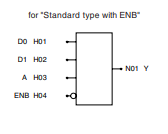
DesignDocuments/DECODE-GateArray/F571.png
