RonnyA/nd-120/DesignDocuments/DECODE-GateArray/F595.png

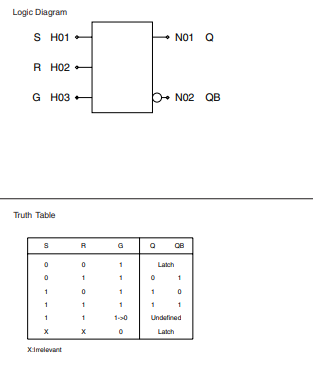
DesignDocuments/DECODE-GateArray/F595.png
