RonnyA/nd-120/DesignDocuments/Other/Timing.png

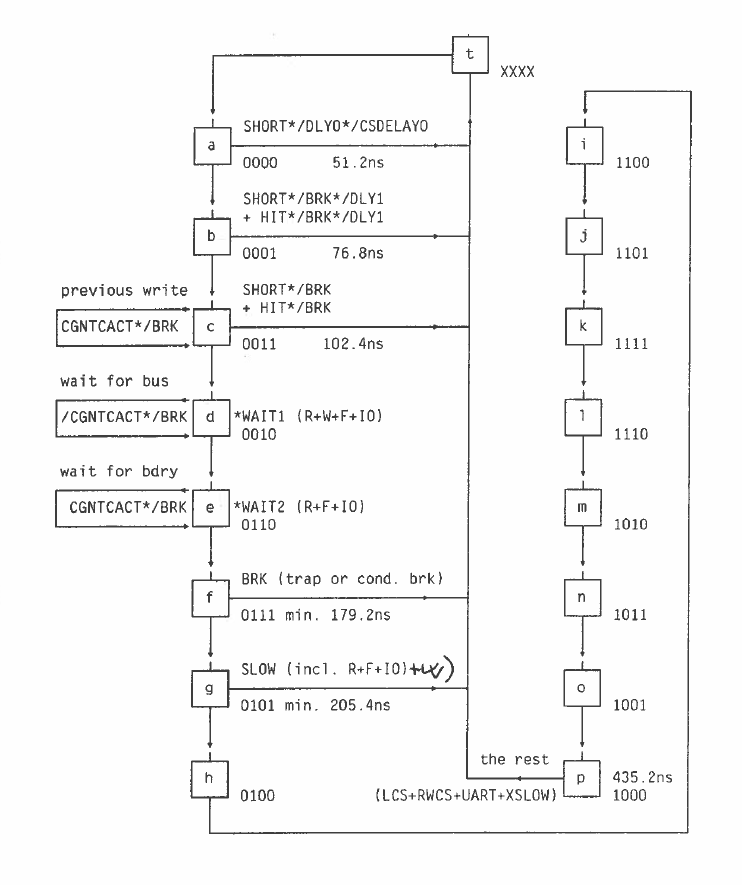
DesignDocuments/Other/Timing.png
