RonnyA/nd-120/DesignDocuments/PAL-Code/IMG/44302B.png

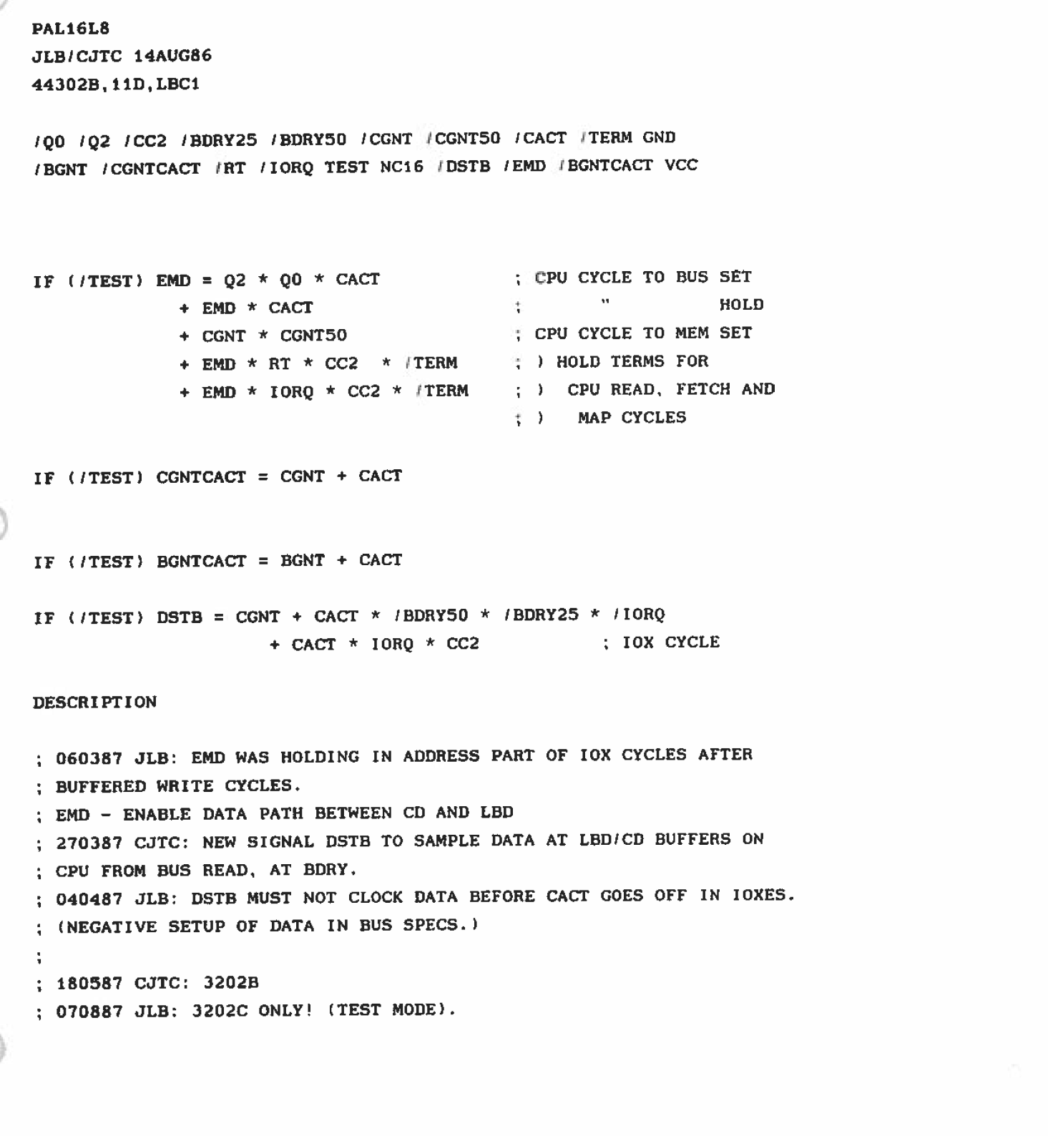
DesignDocuments/PAL-Code/IMG/44302B.png
