RonnyA/nd-120/DesignDocuments/PAL-Code/IMG/44303B.png

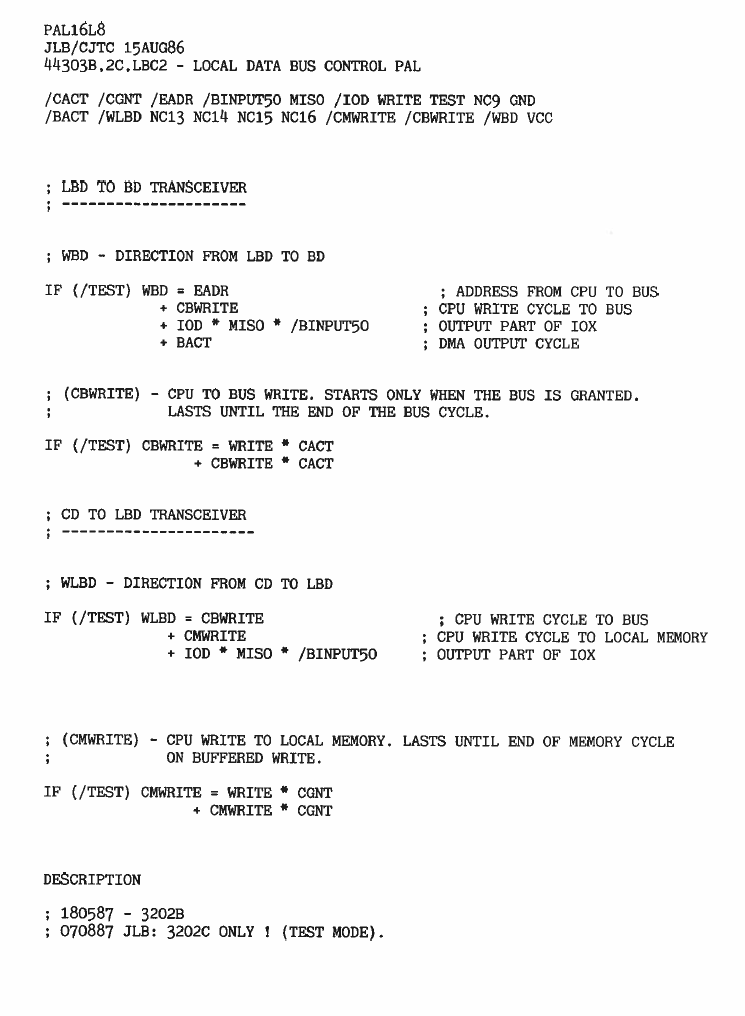
DesignDocuments/PAL-Code/IMG/44303B.png
