RonnyA/nd-120/DesignDocuments/PAL-Code/IMG/44304E.png

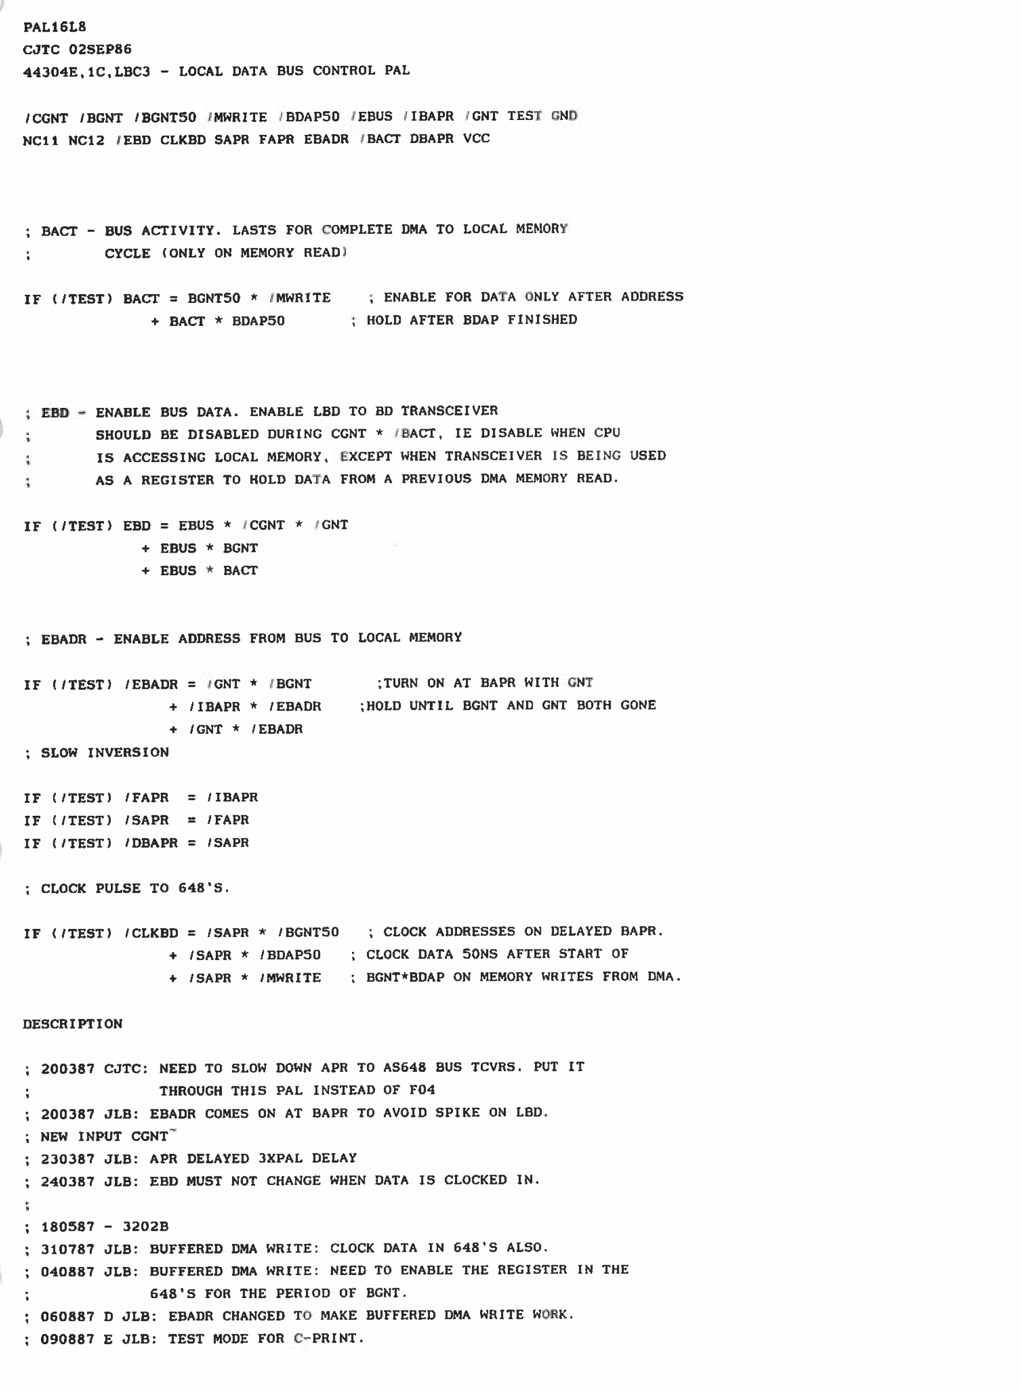
DesignDocuments/PAL-Code/IMG/44304E.png
