RonnyA/nd-120/DesignDocuments/PAL-Code/IMG/44305D.png

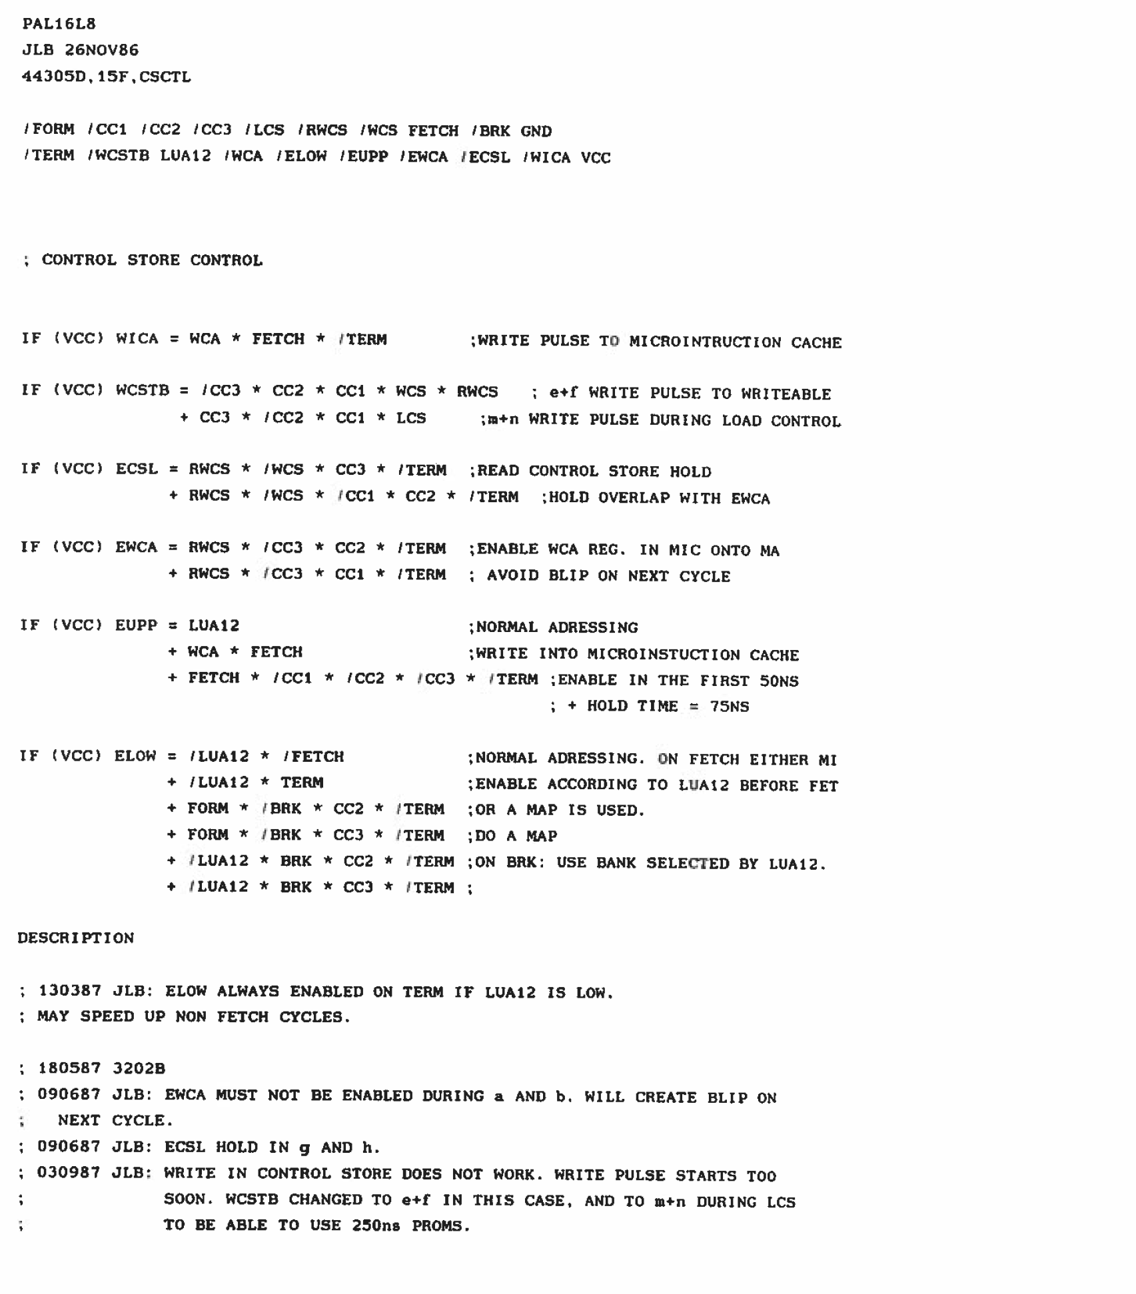
DesignDocuments/PAL-Code/IMG/44305D.png
