RonnyA/nd-120/DesignDocuments/PAL-Code/IMG/44306A.png

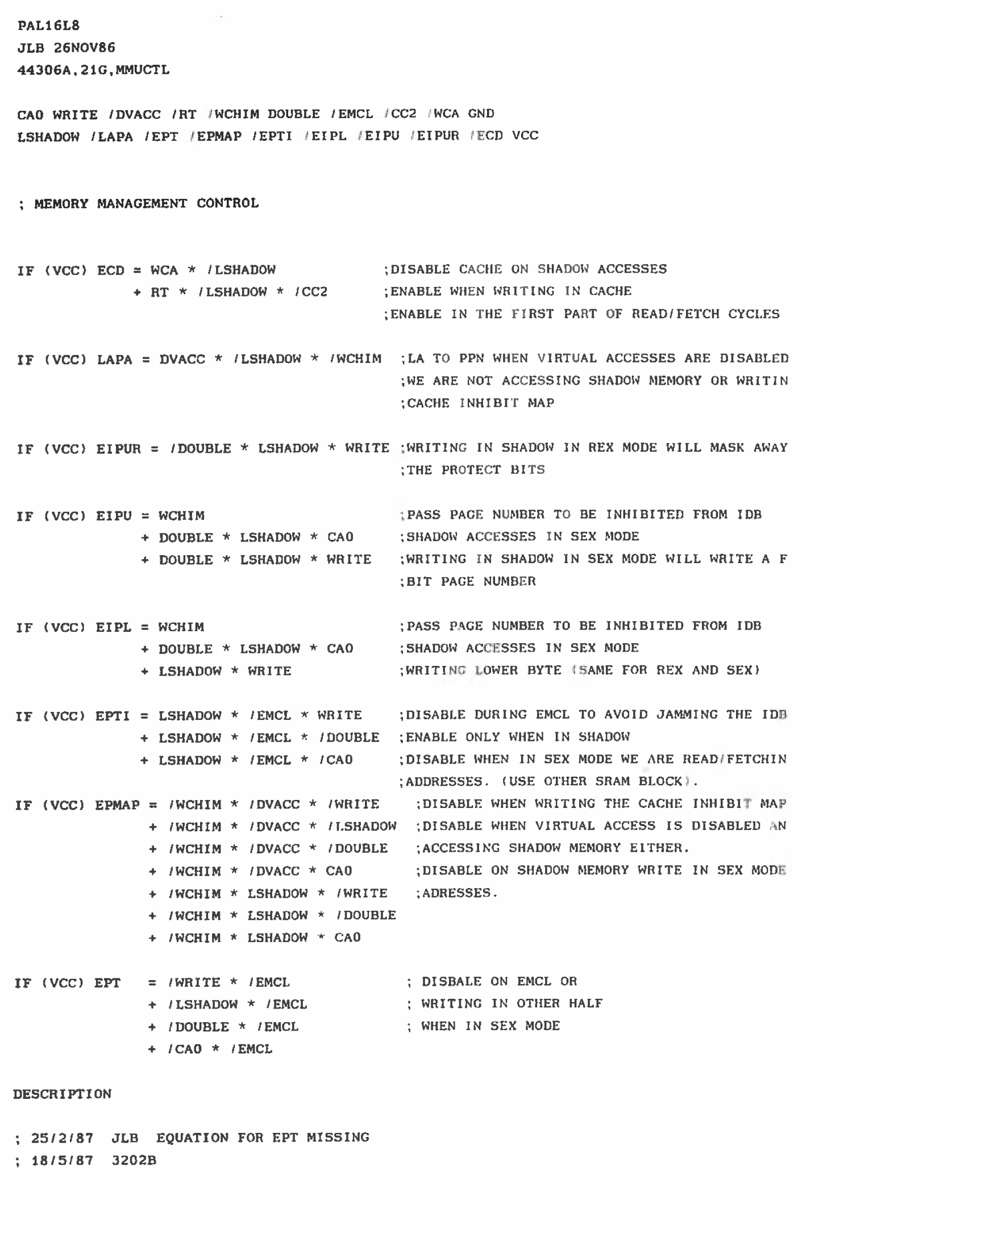
DesignDocuments/PAL-Code/IMG/44306A.png
