RonnyA/nd-120/DesignDocuments/PAL-Code/IMG/44307C.png

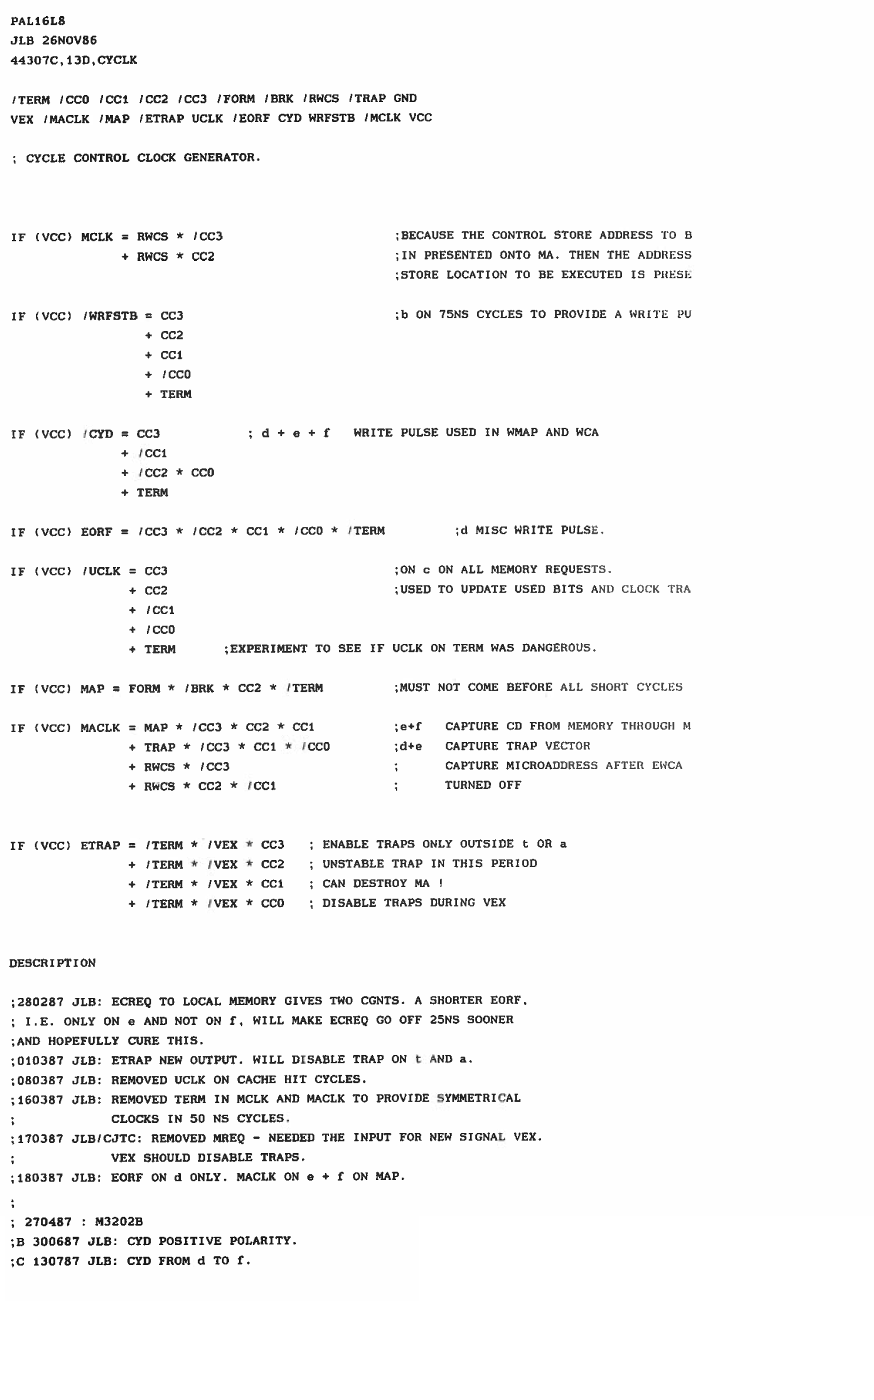
DesignDocuments/PAL-Code/IMG/44307C.png
