RonnyA/nd-120/DesignDocuments/PAL-Code/IMG/44310D.png

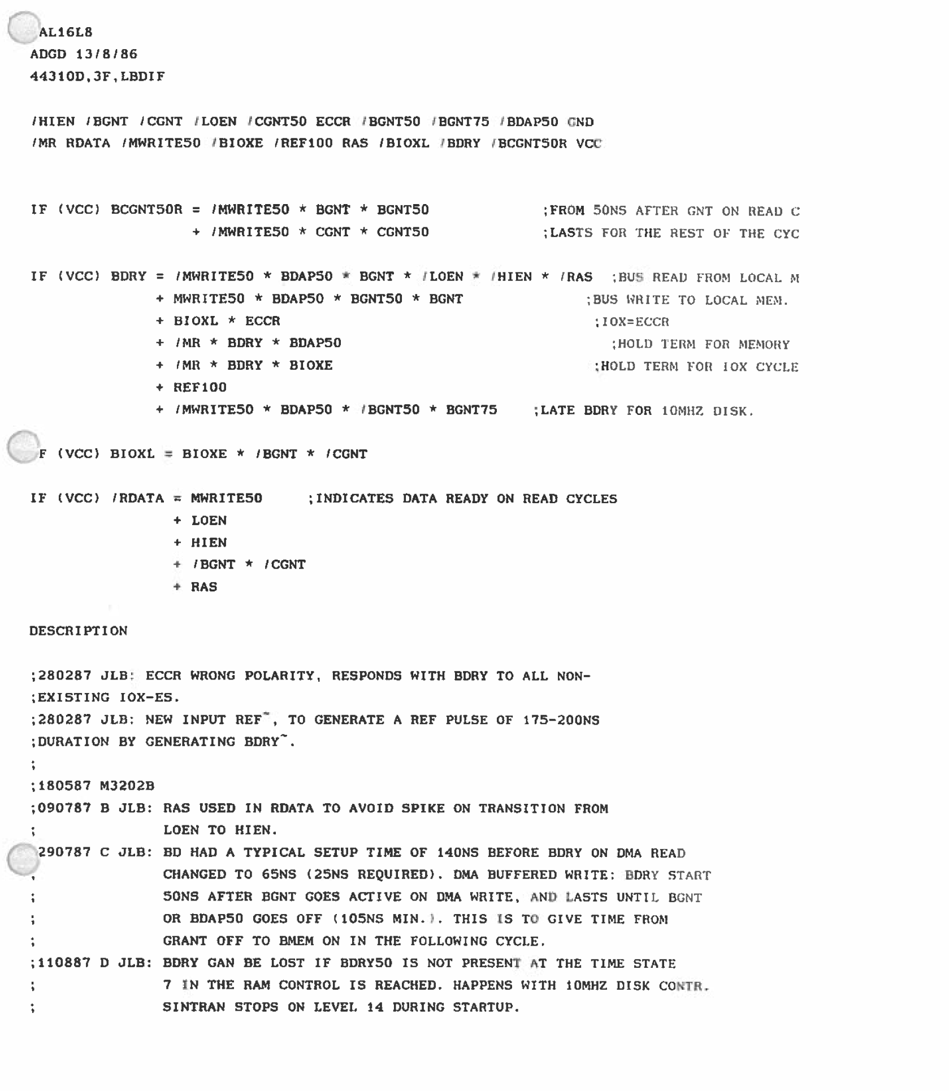
DesignDocuments/PAL-Code/IMG/44310D.png
