RonnyA/nd-120/DesignDocuments/PAL-Code/IMG/44401B.png

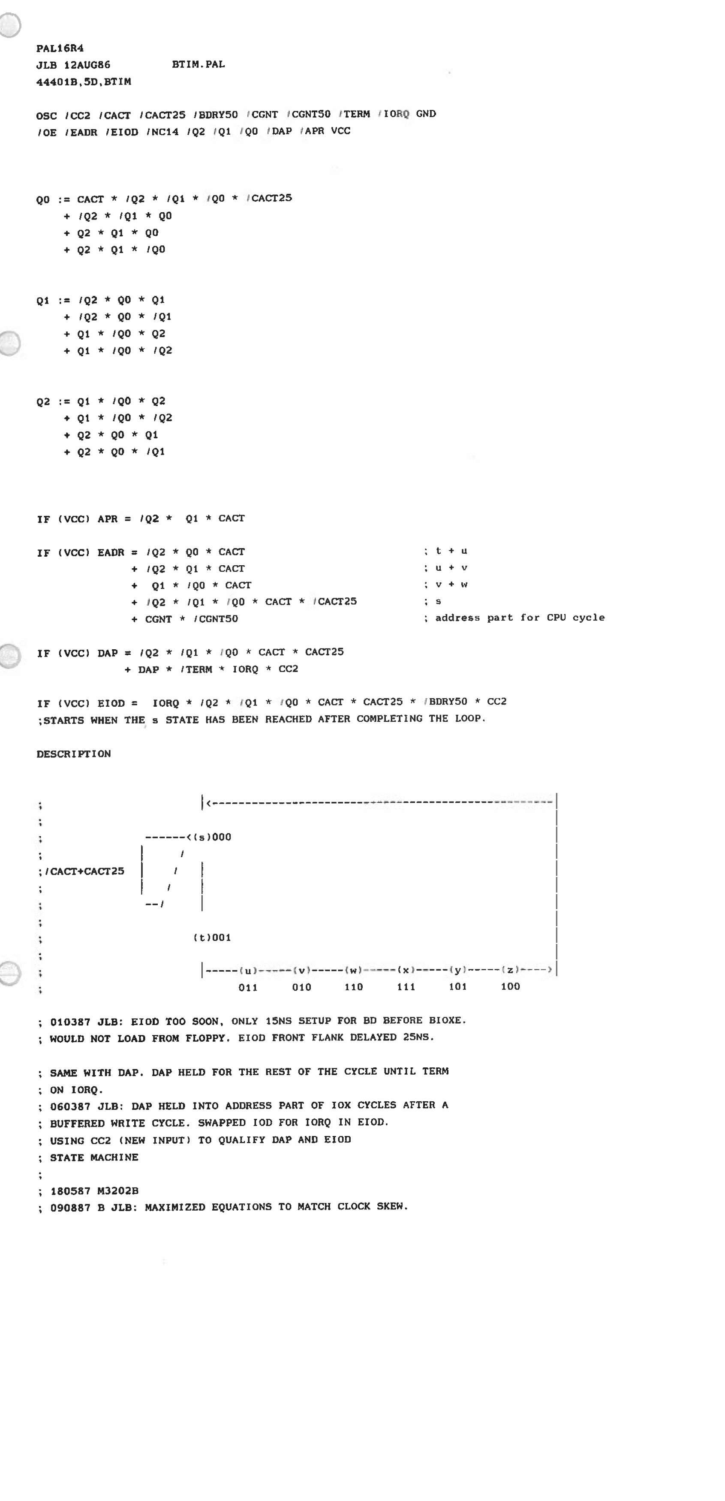
DesignDocuments/PAL-Code/IMG/44401B.png
