RonnyA/nd-120/DesignDocuments/PAL-Code/IMG/44402D.png

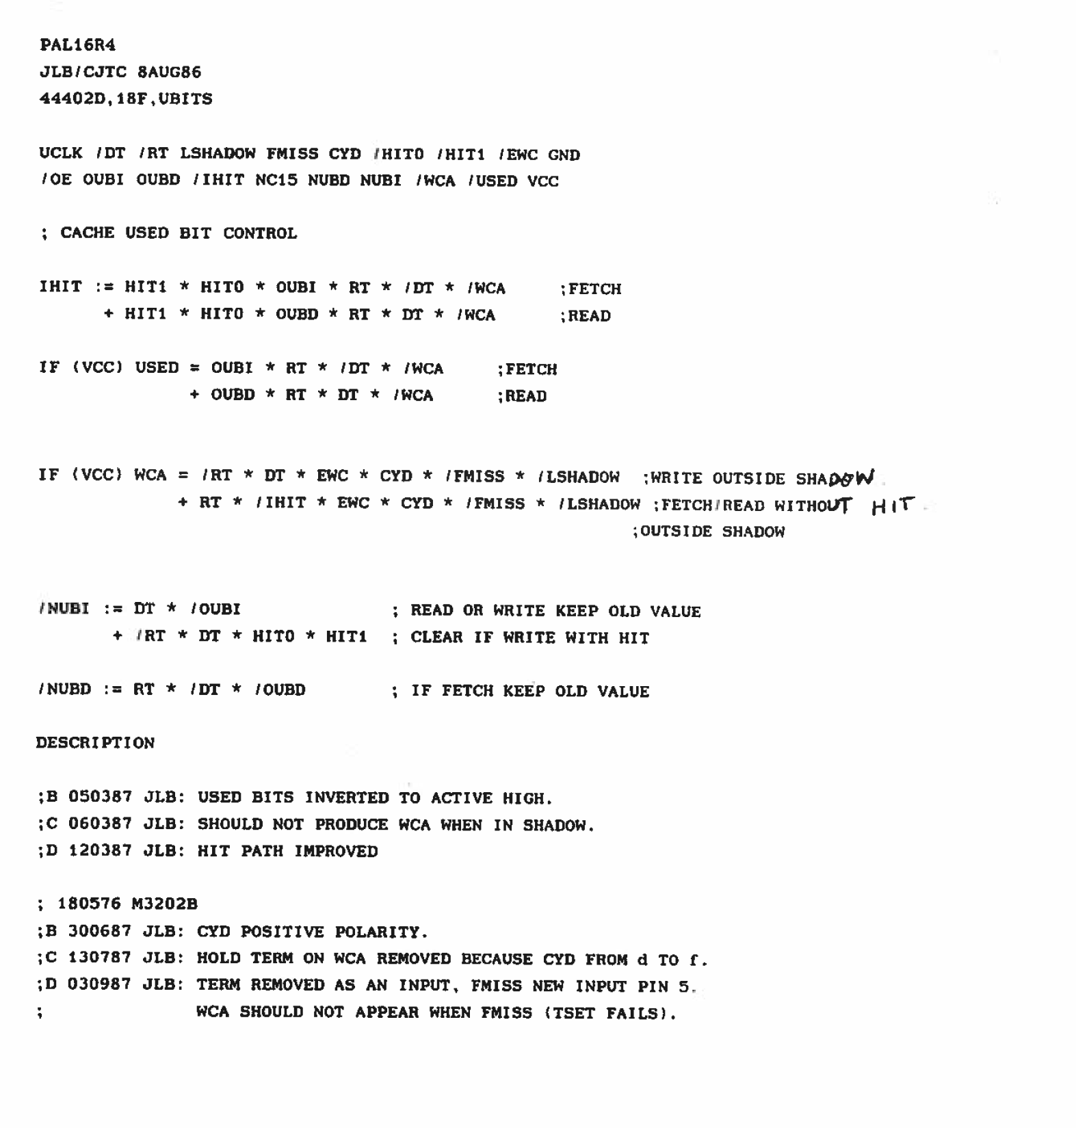
DesignDocuments/PAL-Code/IMG/44402D.png
