RonnyA/nd-120/DesignDocuments/PAL-Code/IMG/44403C.png

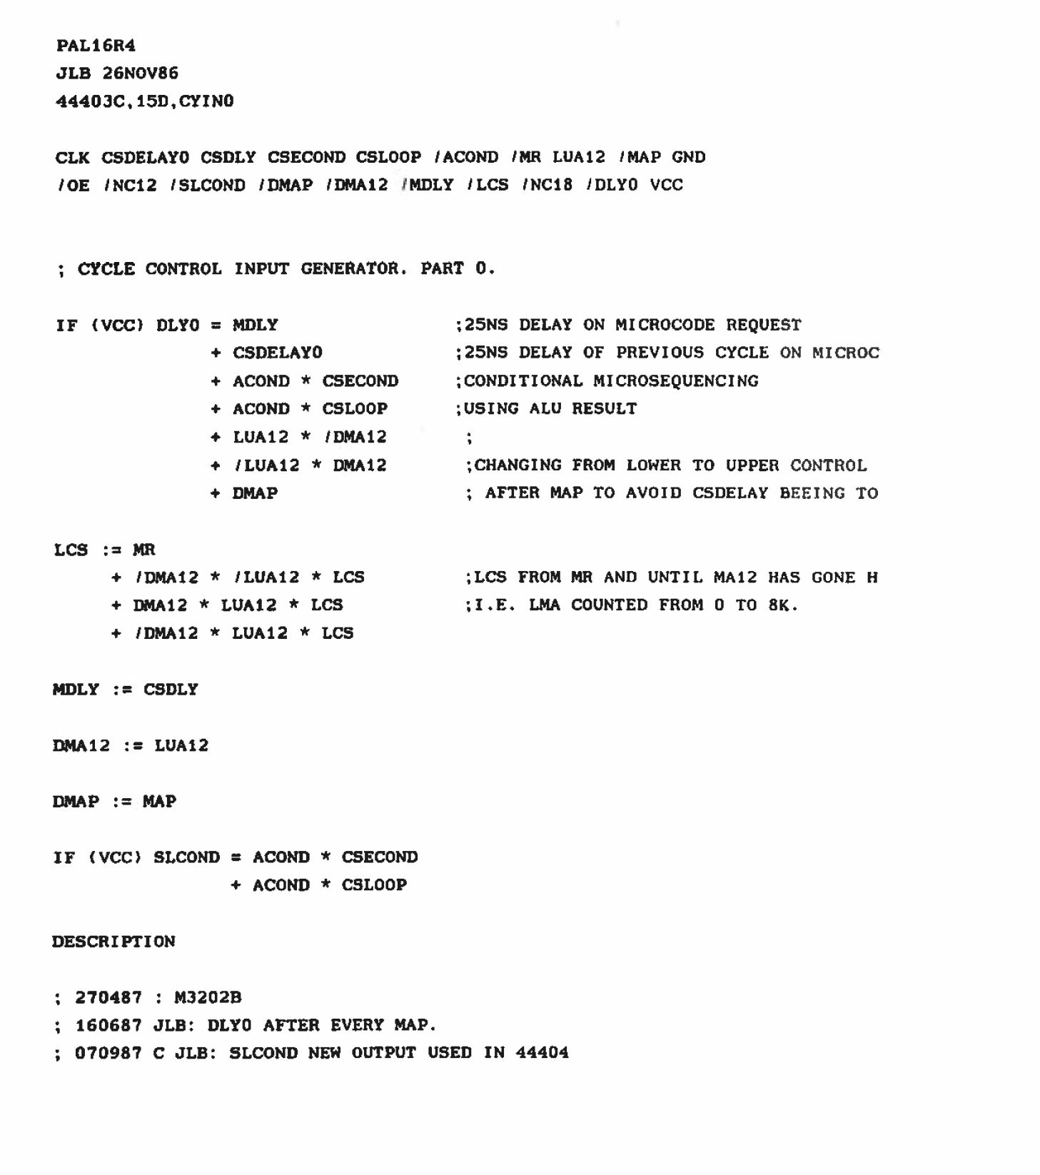
DesignDocuments/PAL-Code/IMG/44403C.png
