RonnyA/nd-120/DesignDocuments/PAL-Code/IMG/44403D.png

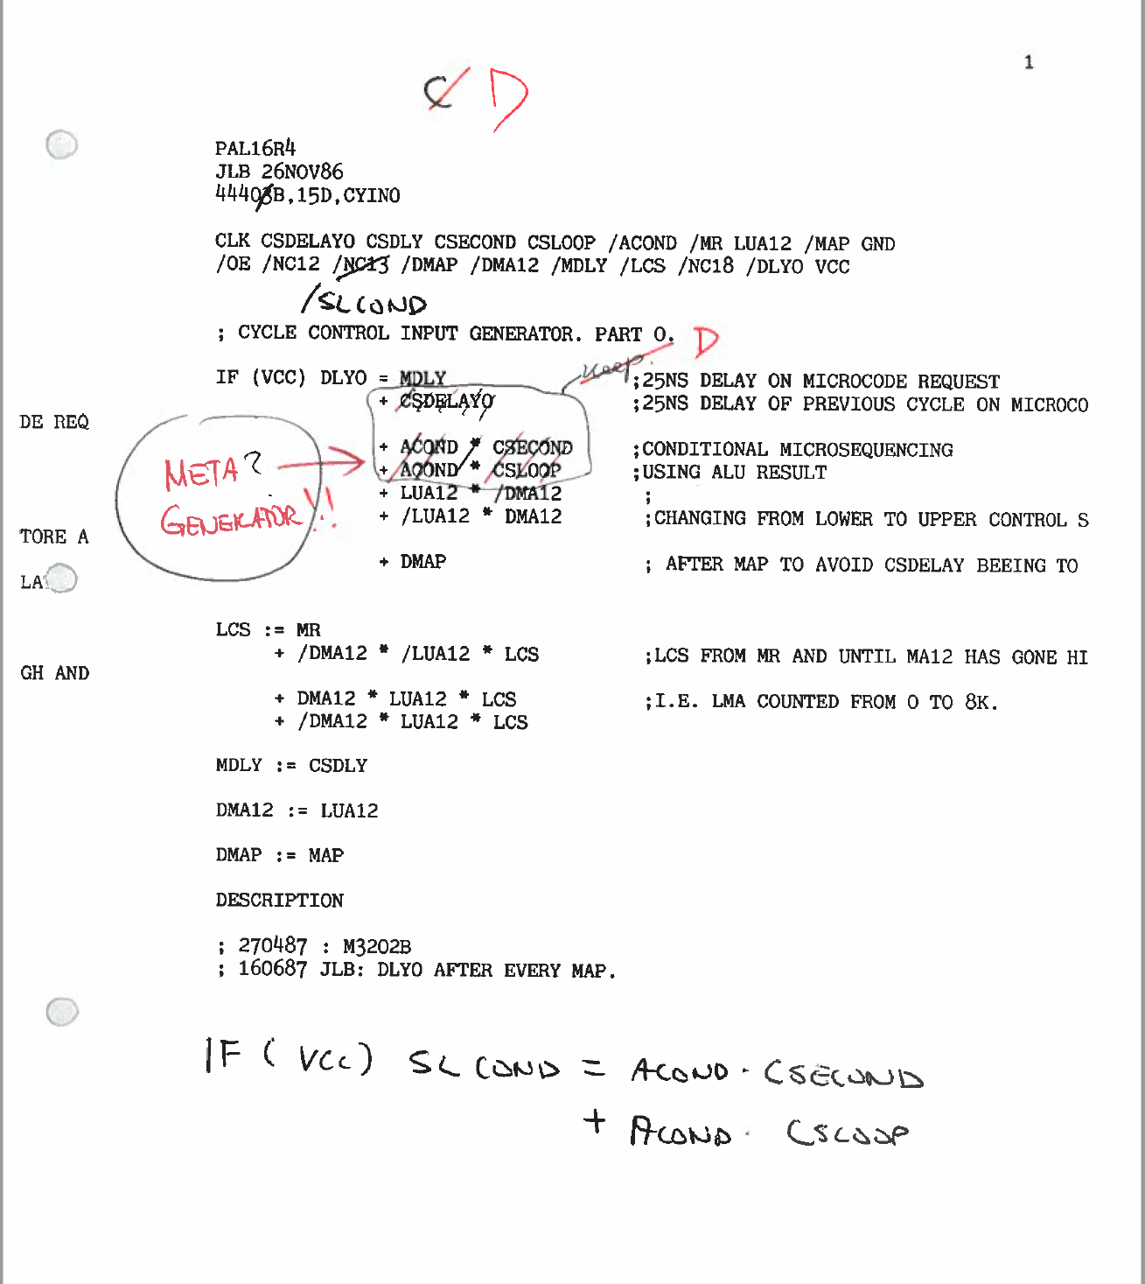
DesignDocuments/PAL-Code/IMG/44403D.png
