RonnyA/nd-120/DesignDocuments/PAL-Code/IMG/44404C.png

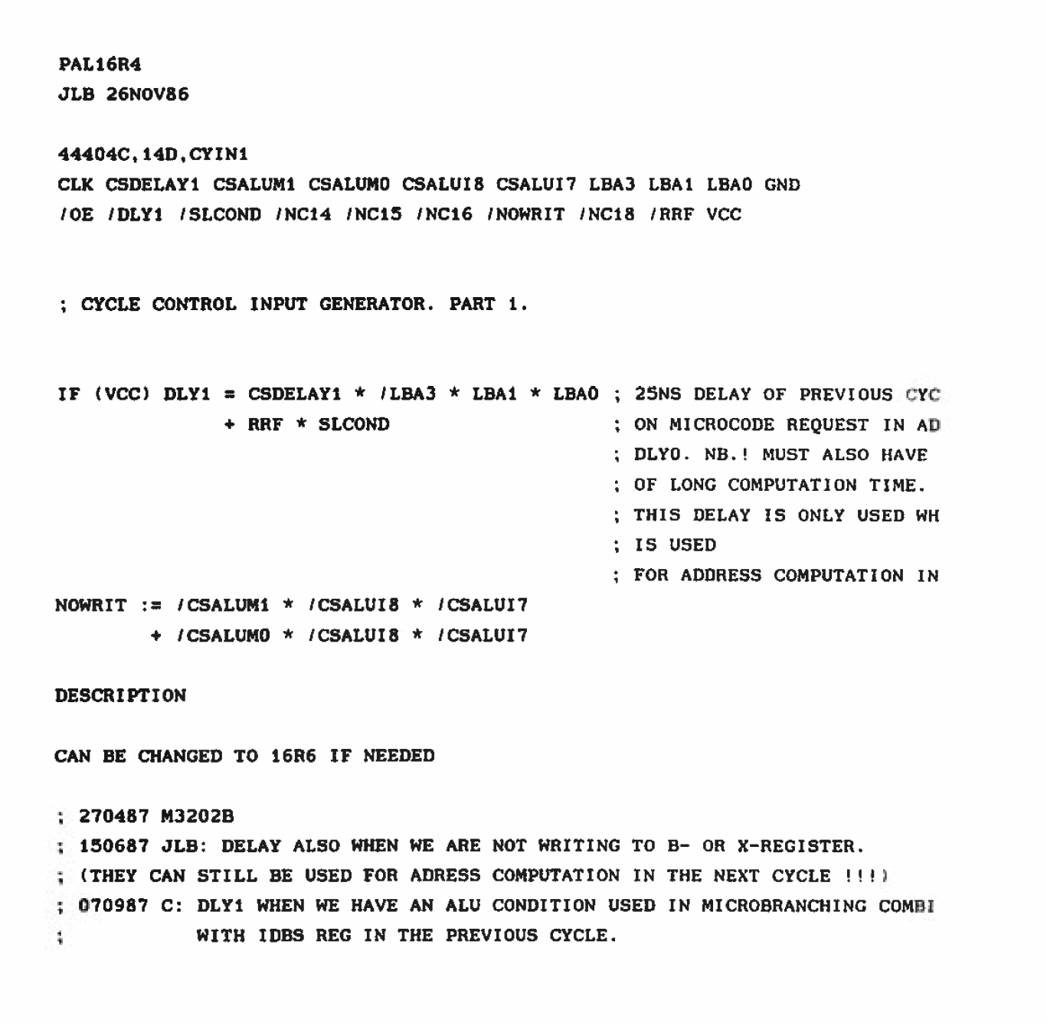
DesignDocuments/PAL-Code/IMG/44404C.png
