RonnyA/nd-120/DesignDocuments/PAL-Code/IMG/44407A.png

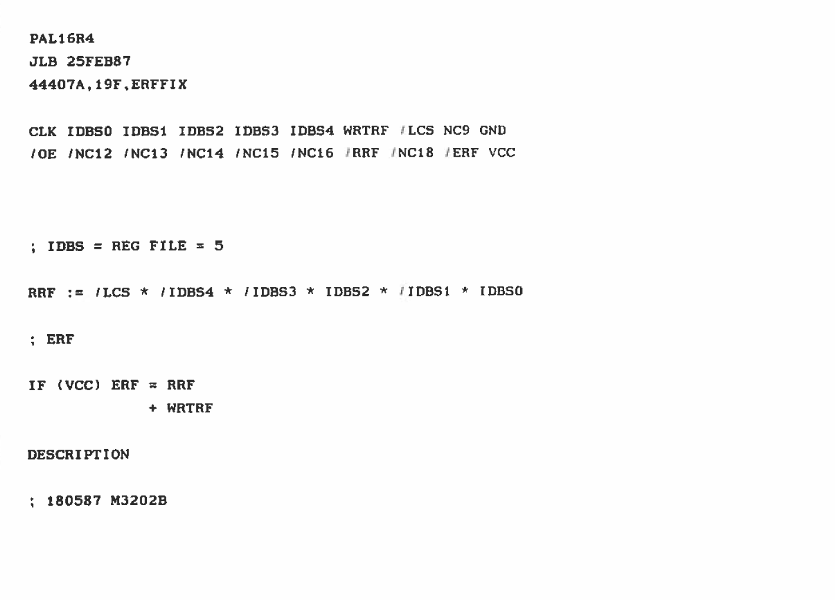
DesignDocuments/PAL-Code/IMG/44407A.png
