RonnyA/nd-120/DesignDocuments/PAL-Code/IMG/44408B.png

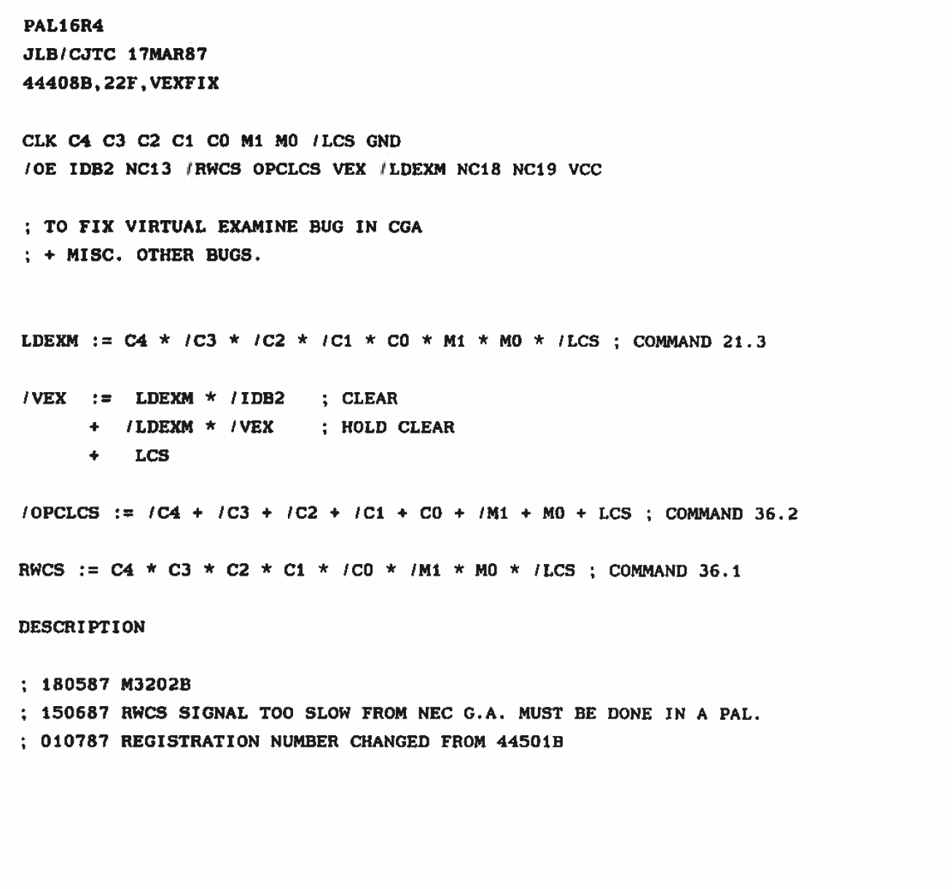
DesignDocuments/PAL-Code/IMG/44408B.png
