RonnyA/nd-120/DesignDocuments/PAL-Code/IMG/44445B.png

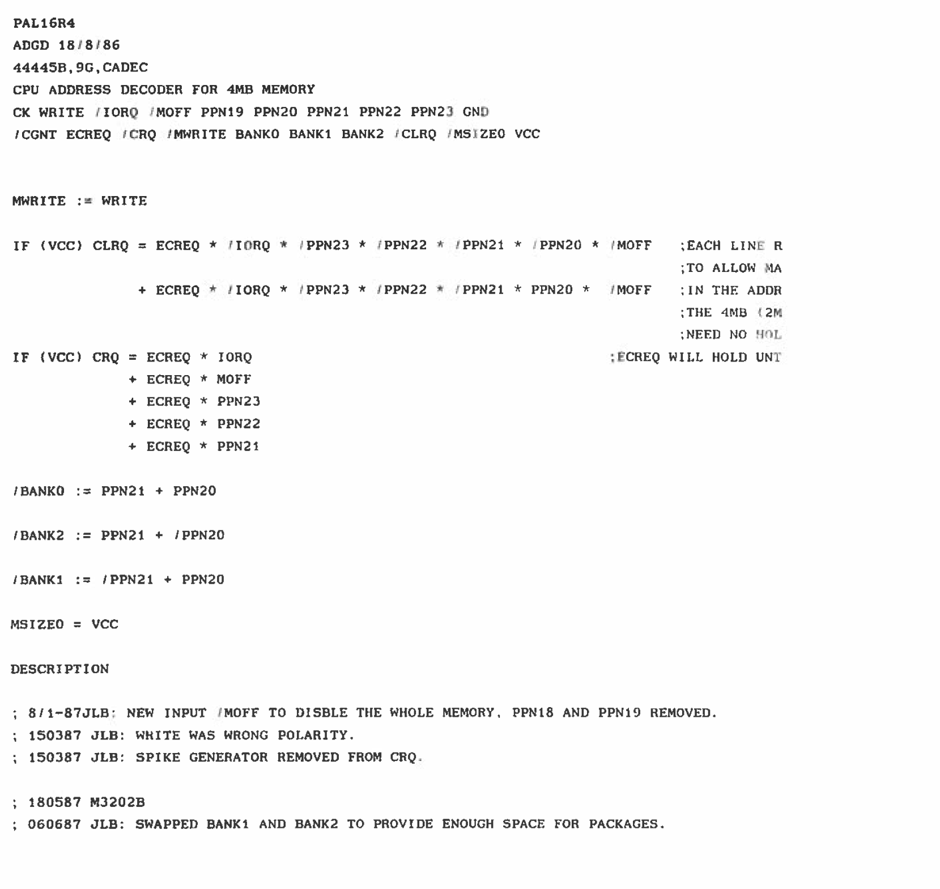
DesignDocuments/PAL-Code/IMG/44445B.png
