RonnyA/nd-120/DesignDocuments/PAL-Code/IMG/44446B.png

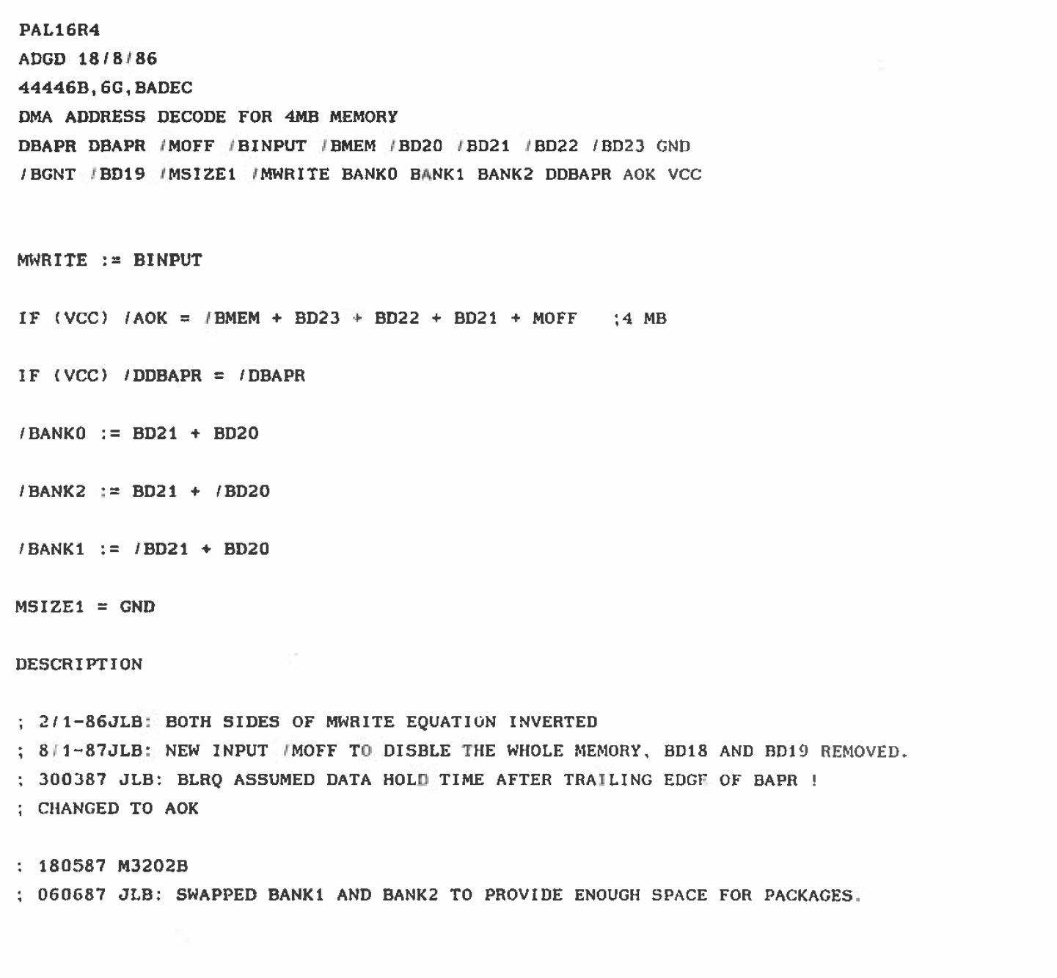
DesignDocuments/PAL-Code/IMG/44446B.png
