RonnyA/nd-120/DesignDocuments/PAL-Code/IMG/44465B.png

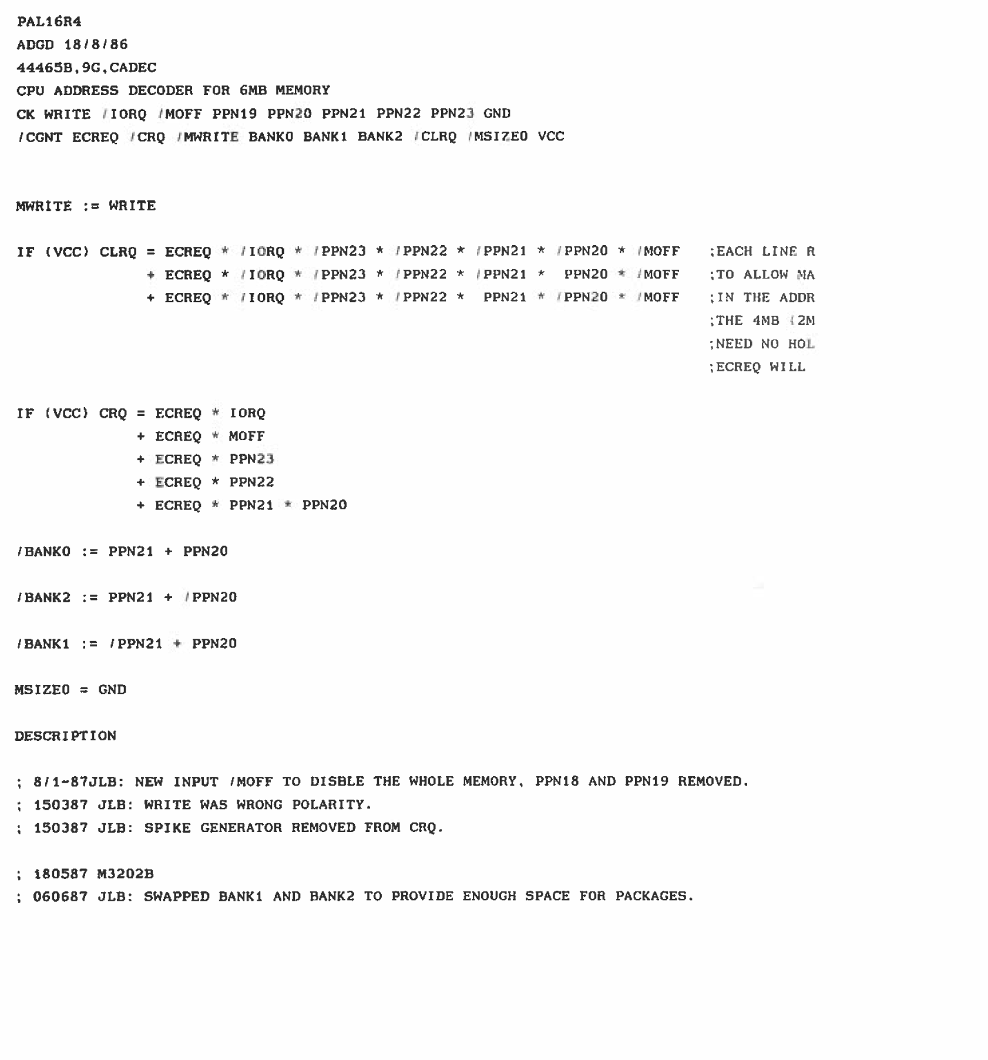
DesignDocuments/PAL-Code/IMG/44465B.png
