RonnyA/nd-120/DesignDocuments/PAL-Code/IMG/44466B.png

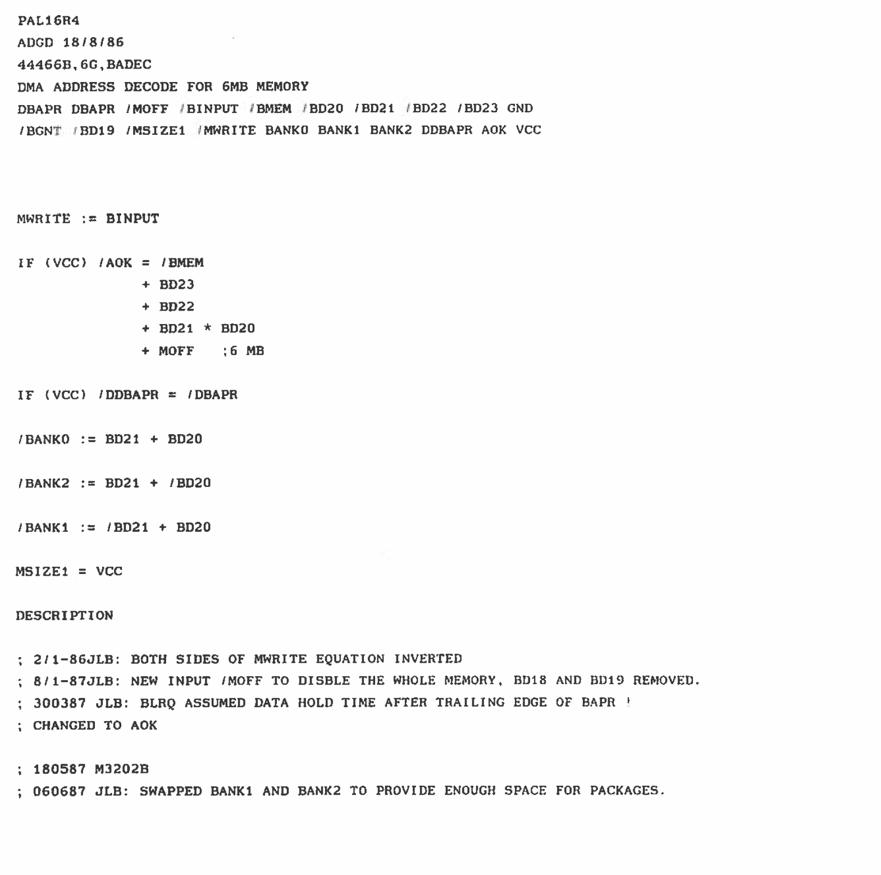
DesignDocuments/PAL-Code/IMG/44466B.png
