RonnyA/nd-120/DesignDocuments/PAL-Code/IMG/44511A.png

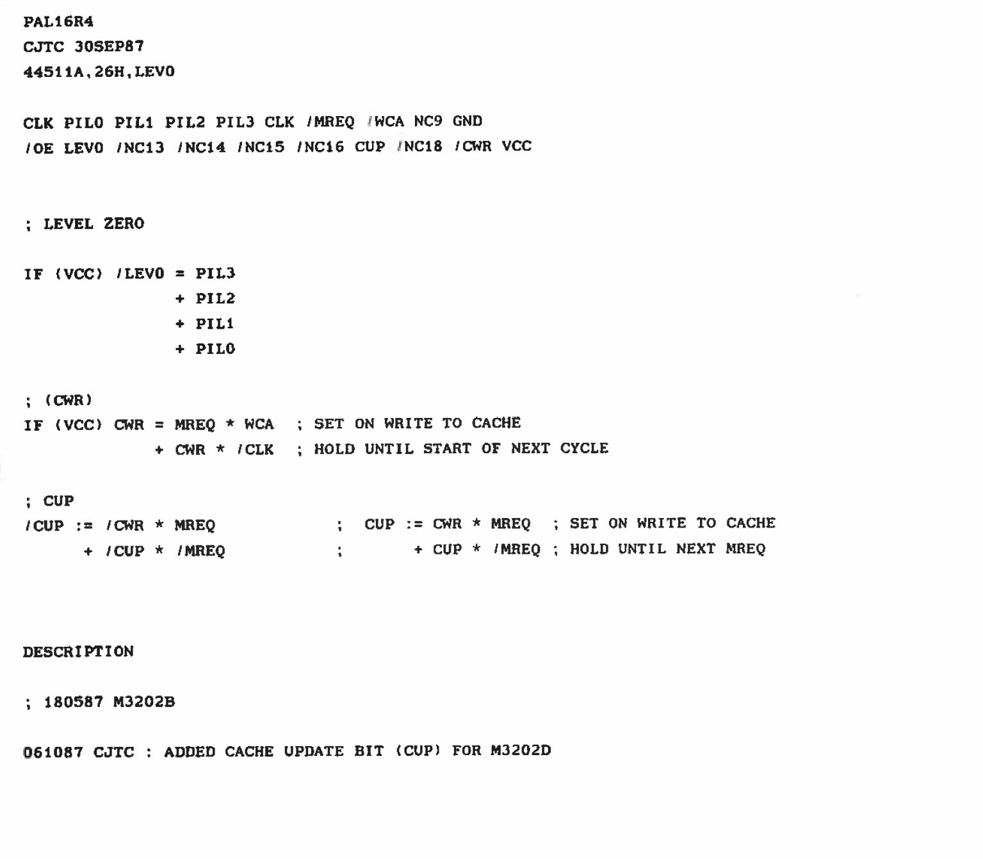
DesignDocuments/PAL-Code/IMG/44511A.png
