RonnyA/nd-120/DesignDocuments/PAL-Code/IMG/44601B.png

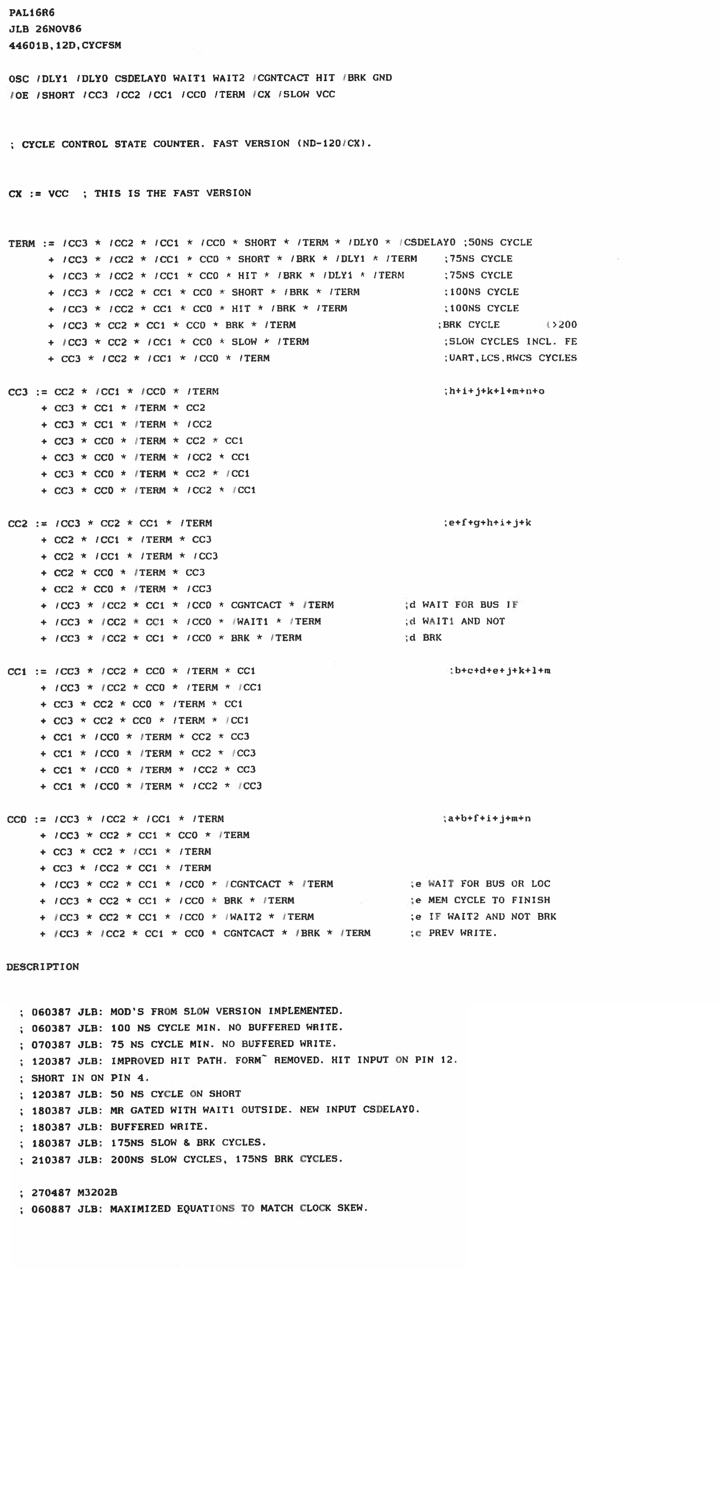
DesignDocuments/PAL-Code/IMG/44601B.png
