RonnyA/nd-120/DesignDocuments/PAL-Code/IMG/44801A.png

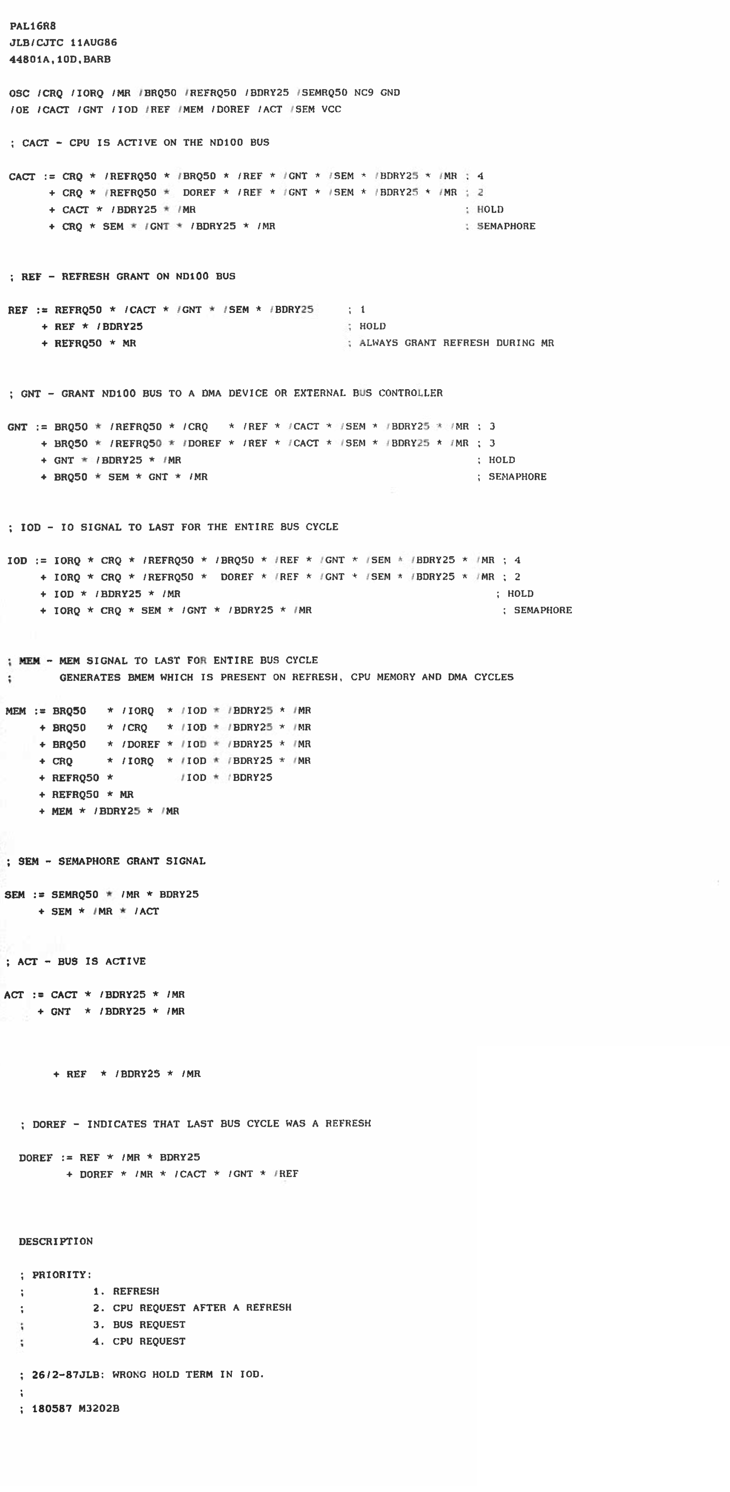
DesignDocuments/PAL-Code/IMG/44801A.png
