RonnyA/nd-120/DesignDocuments/PAL-Code/IMG/44803A.png

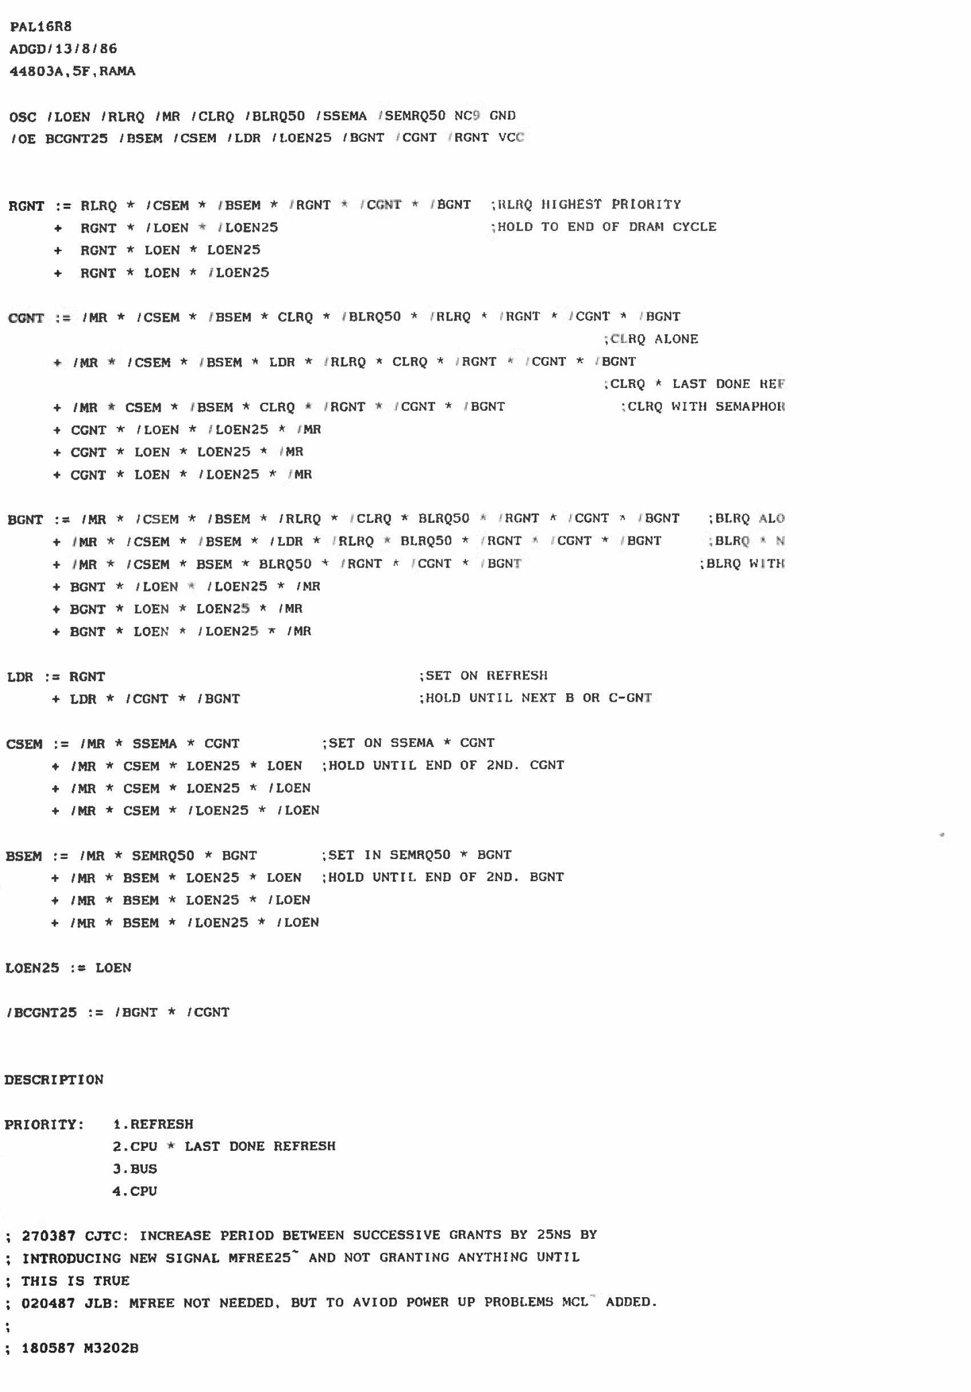
DesignDocuments/PAL-Code/IMG/44803A.png
