RonnyA/nd-120/DesignDocuments/PAL-Code/IMG/44902A.png

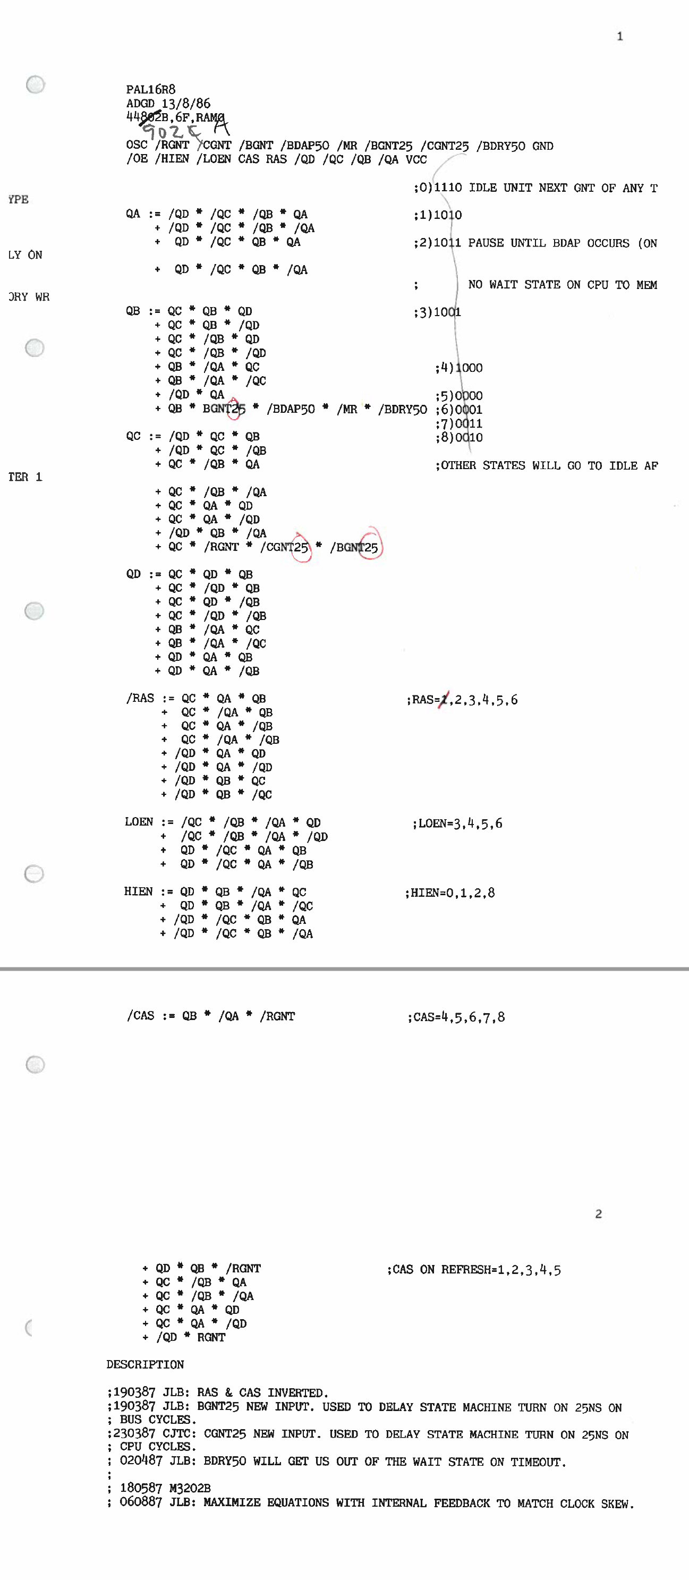
DesignDocuments/PAL-Code/IMG/44902A.png
