RonnyA/nd-120/DesignDocuments/PAL-Code/IMG/44904B.png

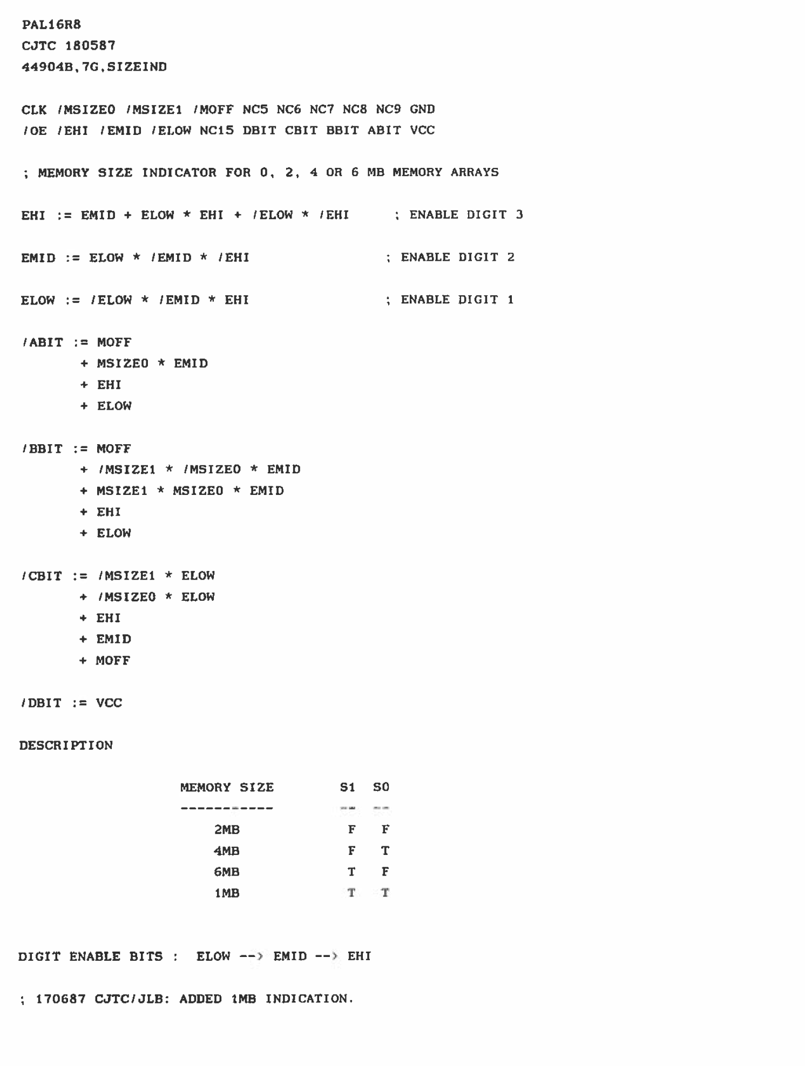
DesignDocuments/PAL-Code/IMG/44904B.png
