RonnyA/nd-120/DesignDocuments/PAL-Code/IMG/45001B.png

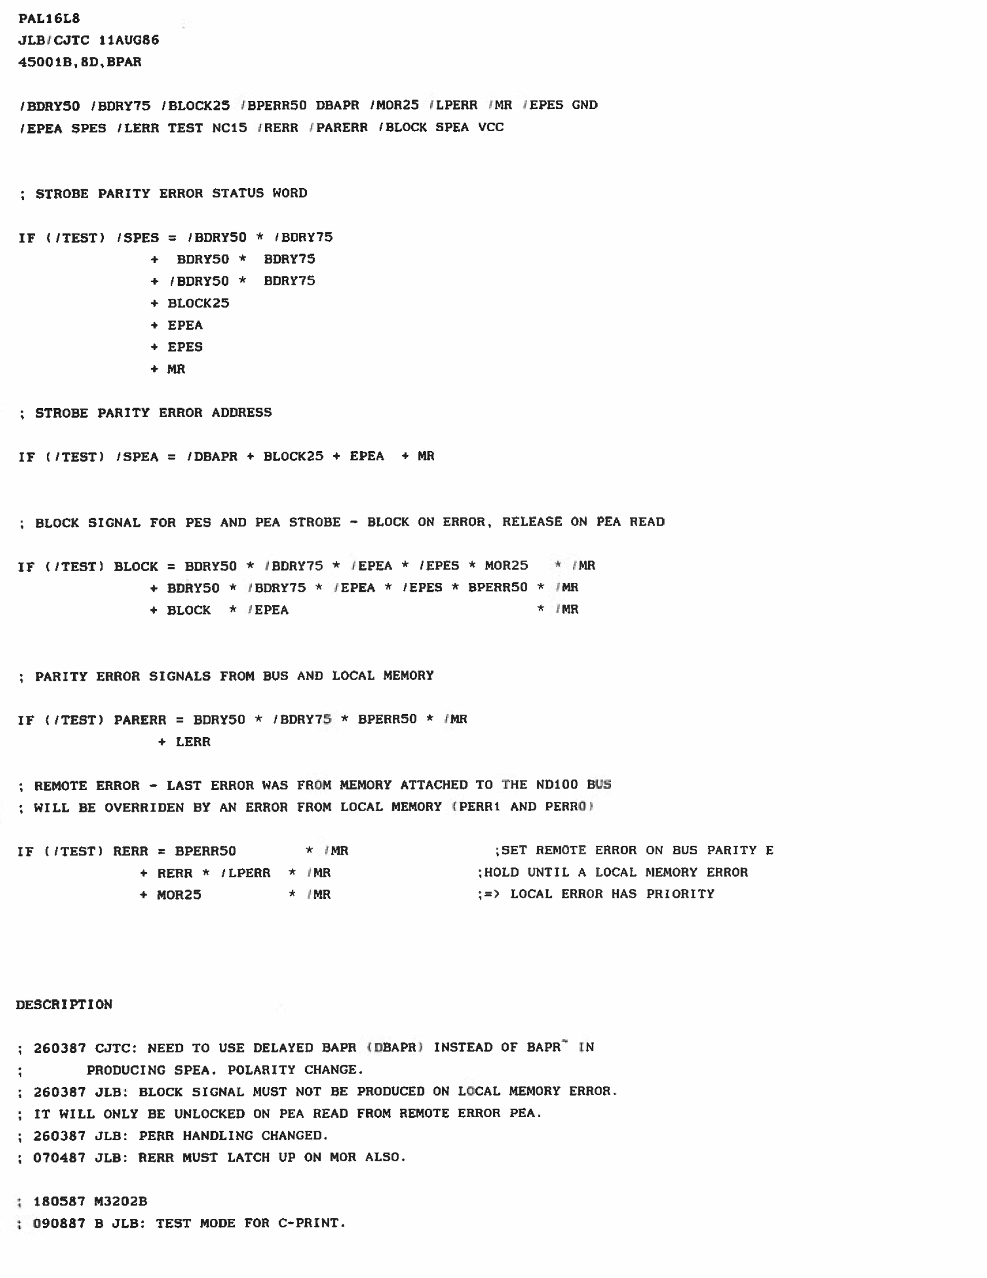
DesignDocuments/PAL-Code/IMG/45001B.png
