RonnyA/nd-120/DesignDocuments/PAL-Code/IMG/45008B.png

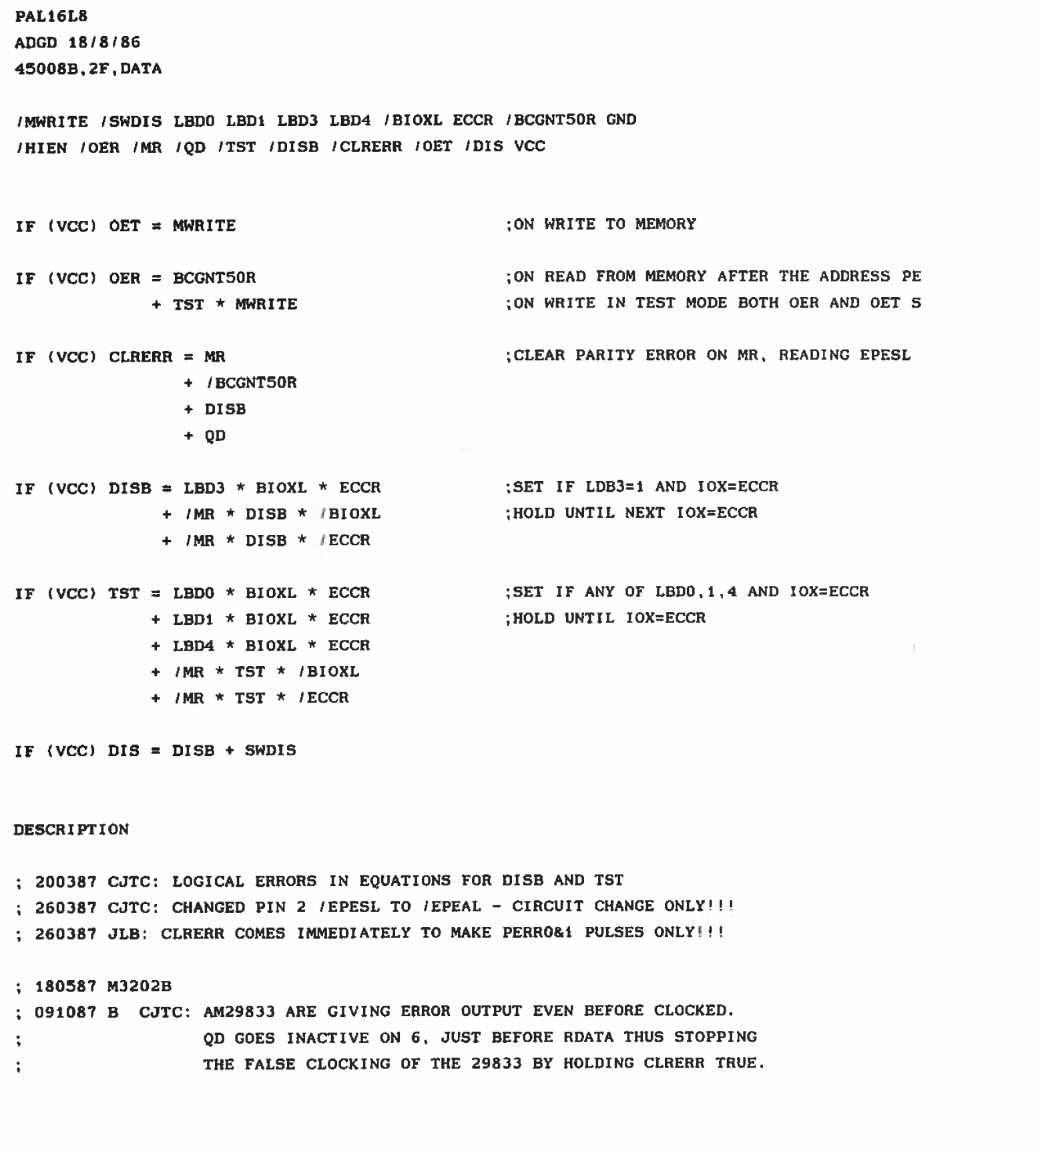
DesignDocuments/PAL-Code/IMG/45008B.png
