RonnyA/nd-120/DesignDocuments/PAL-Code/IMG/45009B.png

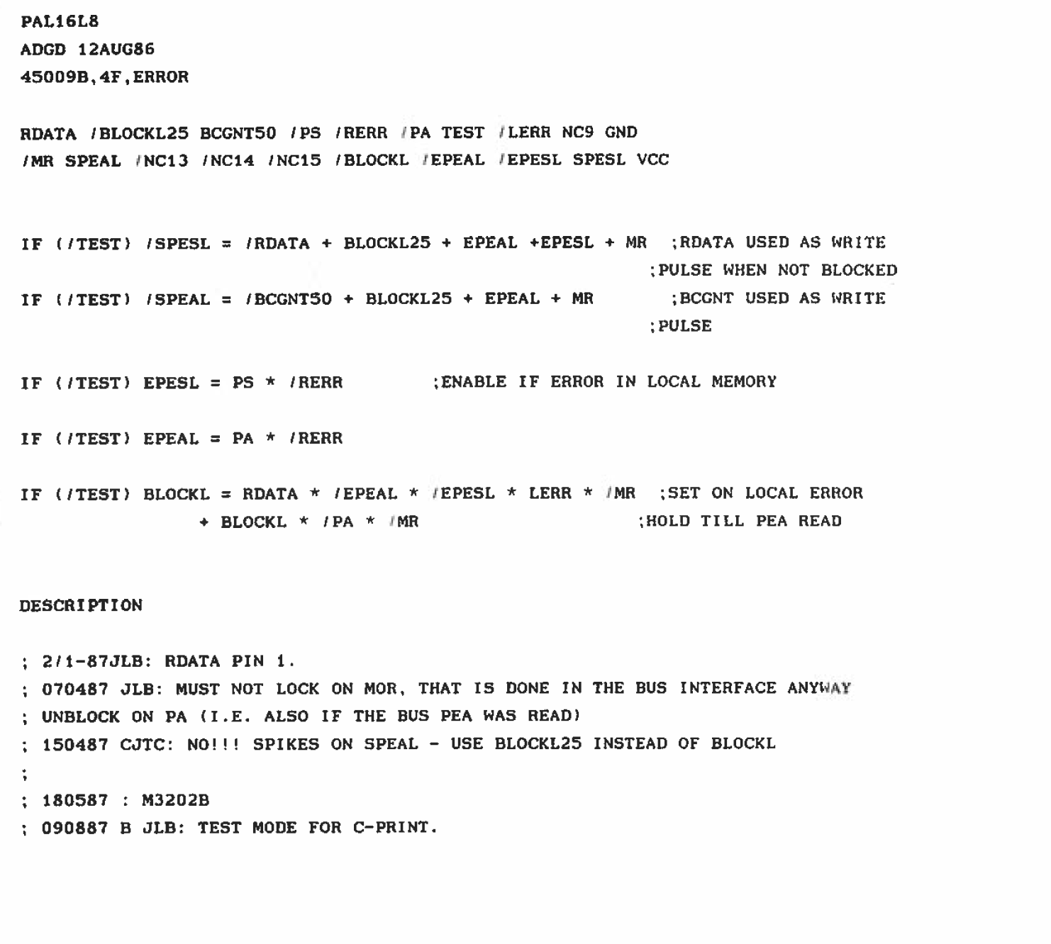
DesignDocuments/PAL-Code/IMG/45009B.png
