RonnyA/nd-120/Verilog/CPU-BOARD-3202/circuit/doc/BIF_5.png

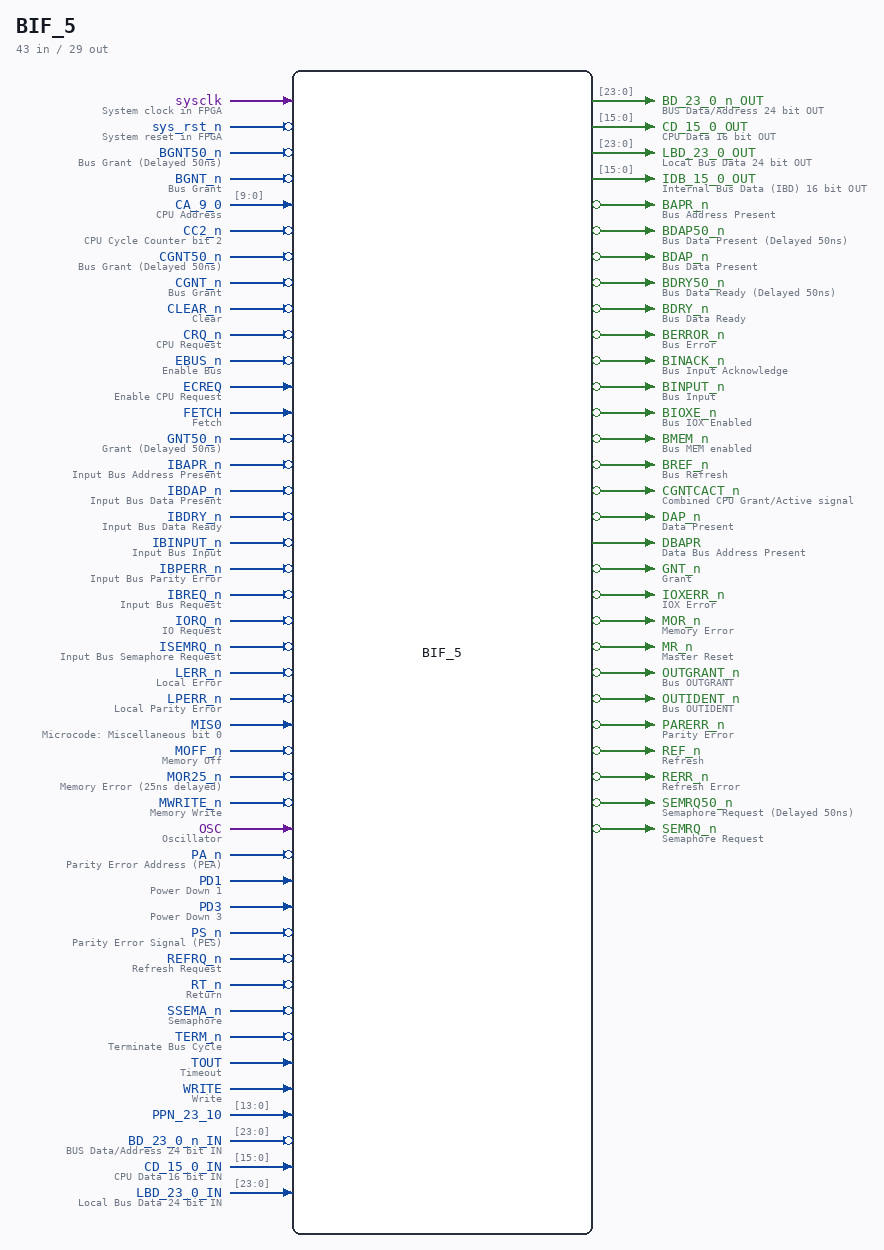
Verilog/CPU-BOARD-3202/circuit/doc/BIF_5.png
