RonnyA/nd-120/Verilog/CPU-BOARD-3202/circuit/doc/BIF_BCTL_BDRV_7.png

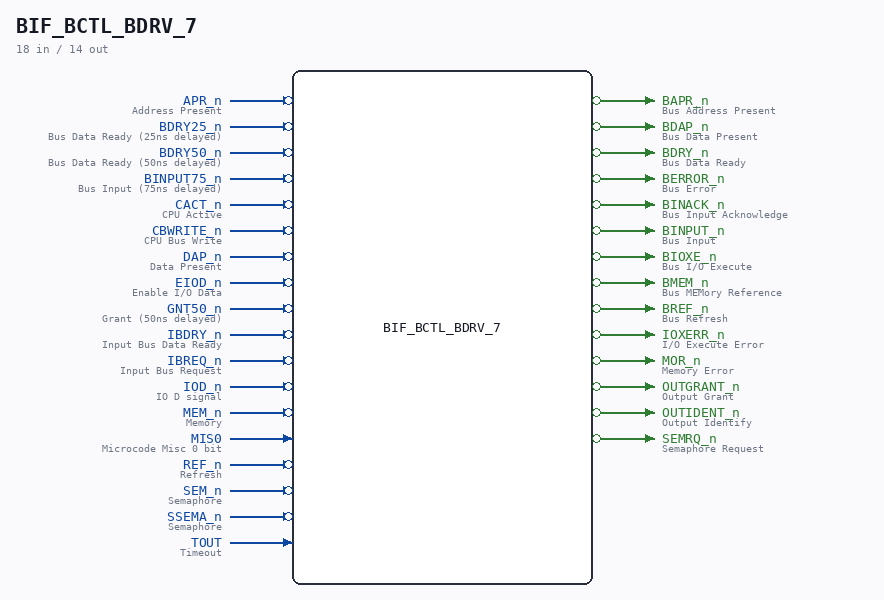
Verilog/CPU-BOARD-3202/circuit/doc/BIF_BCTL_BDRV_7.png
