RonnyA/nd-120/Verilog/CPU-BOARD-3202/circuit/doc/BIF_DPATH_CDLBD_11.png

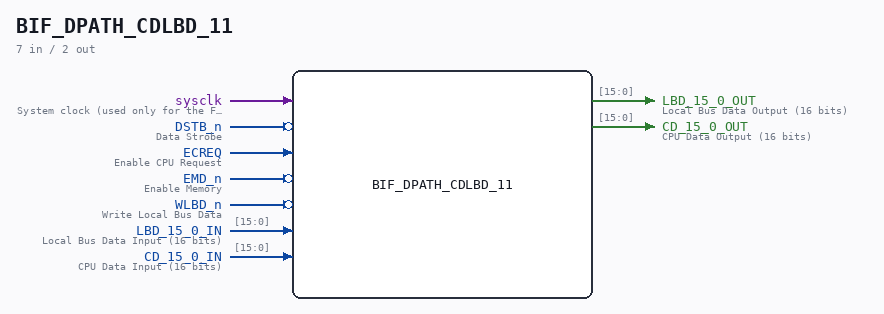
Verilog/CPU-BOARD-3202/circuit/doc/BIF_DPATH_CDLBD_11.png
