RonnyA/nd-120/Verilog/CPU-BOARD-3202/circuit/doc/CPU_CS_CTL_18.png

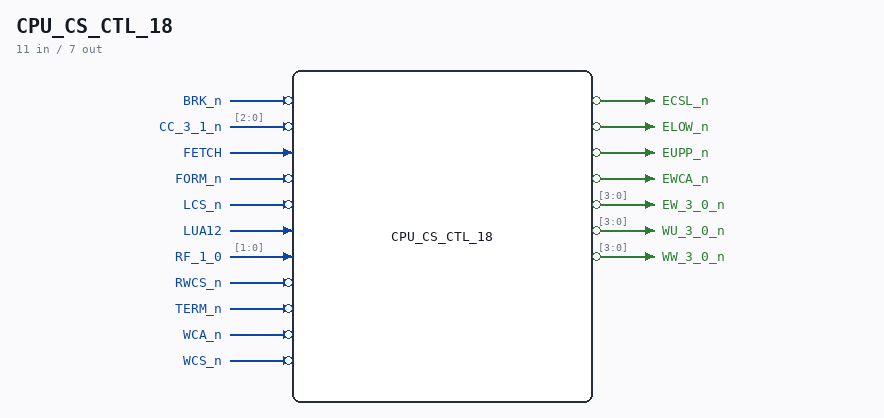
Verilog/CPU-BOARD-3202/circuit/doc/CPU_CS_CTL_18.png
