RonnyA/nd-120/Verilog/CPU-BOARD-3202/circuit/doc/CPU_MMU_PTIDB_30.png

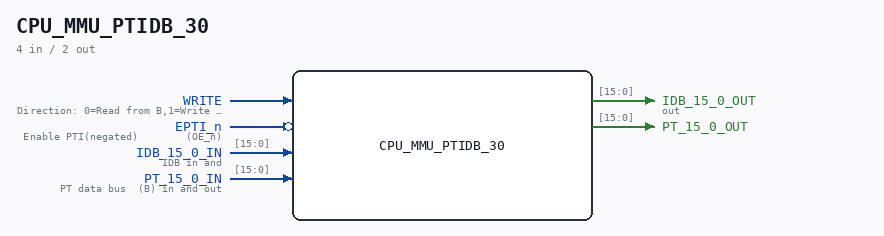
Verilog/CPU-BOARD-3202/circuit/doc/CPU_MMU_PTIDB_30.png
