RonnyA/nd-120/Verilog/CPU-BOARD-3202/circuit/doc/IO_REG_41.png

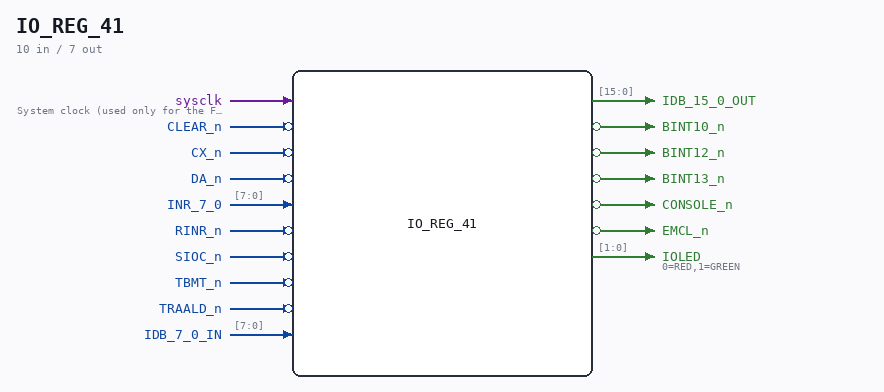
Verilog/CPU-BOARD-3202/circuit/doc/IO_REG_41.png
