RonnyA/nd-120/Verilog/CPU-BOARD-3202/circuit/doc/MEM_RAM_49.png

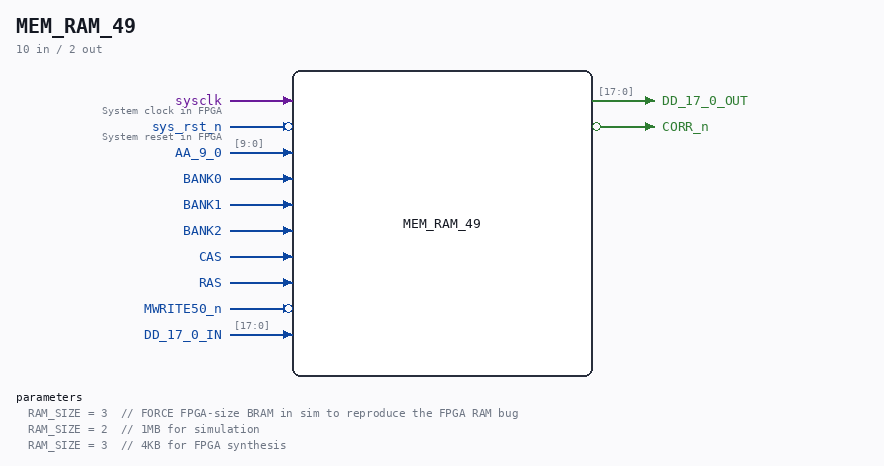
Verilog/CPU-BOARD-3202/circuit/doc/MEM_RAM_49.png
