RonnyA/nd-120/Verilog/DECODE-GateArray/DGA/circuit/doc/F595.png

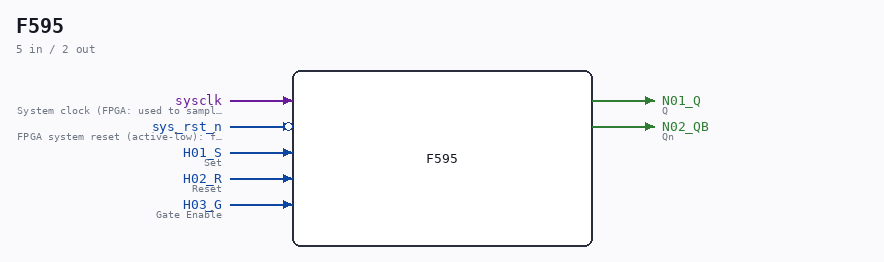
Verilog/DECODE-GateArray/DGA/circuit/doc/F595.png
