RonnyA/nd-120/Verilog/DECODE-GateArray/DGA/circuit/doc/F617.png

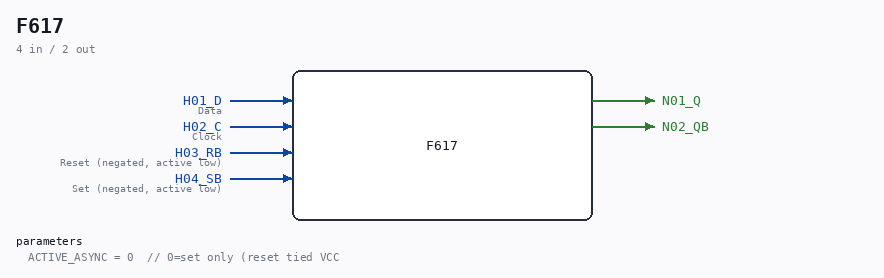
Verilog/DECODE-GateArray/DGA/circuit/doc/F617.png
