RonnyA/nd-120/Verilog/DELILAH-CPU/CGA_ALU/circuit/doc/CGA_ALU.png

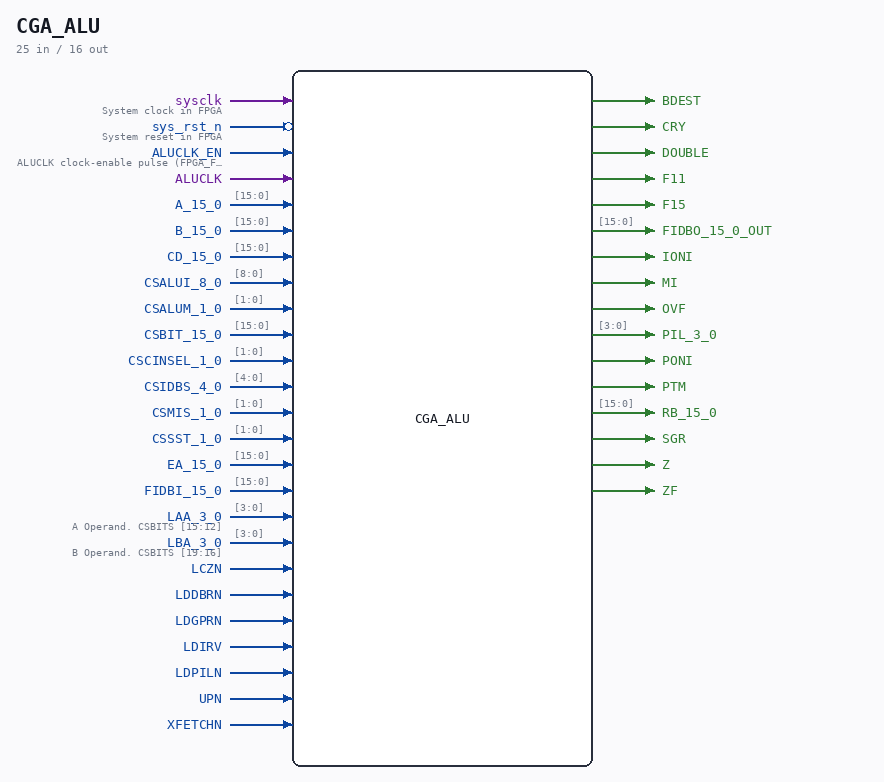
Verilog/DELILAH-CPU/CGA_ALU/circuit/doc/CGA_ALU.png
