RonnyA/nd-120/Verilog/DELILAH-CPU/CGA_IDBCTL/circuit/doc/CGA_IDBCTL_SEL6.png

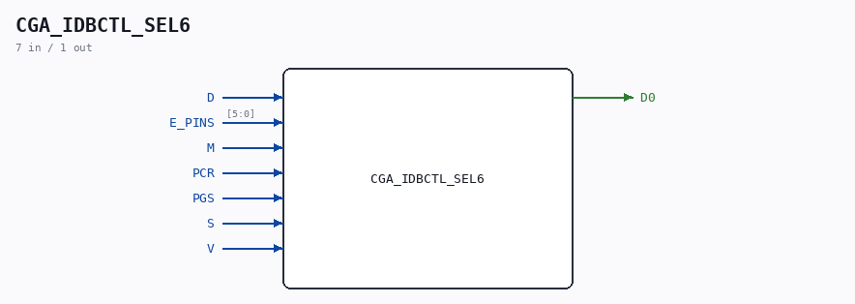
Verilog/DELILAH-CPU/CGA_IDBCTL/circuit/doc/CGA_IDBCTL_SEL6.png
