RonnyA/nd-120/Verilog/DELILAH-CPU/CGA_INTR/circuit/doc/CGA_INTR_CNTLR_IRGEL_HIRL.png

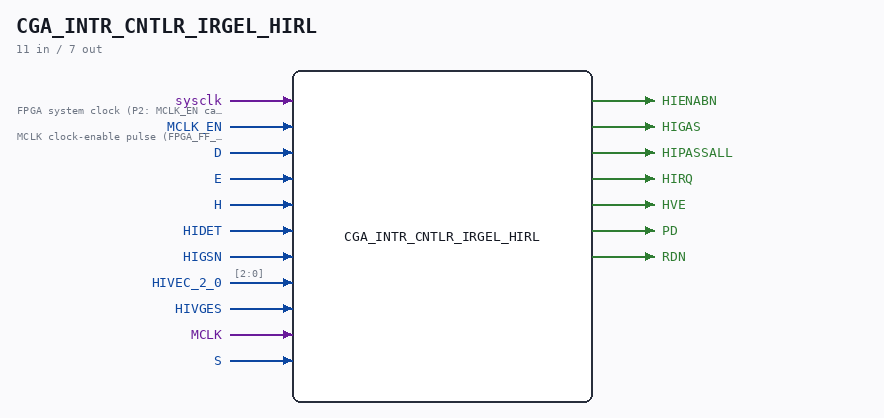
Verilog/DELILAH-CPU/CGA_INTR/circuit/doc/CGA_INTR_CNTLR_IRGEL_HIRL.png
