RonnyA/nd-120/Verilog/DELILAH-CPU/CGA_INTR/circuit/doc/CGA_INTR_CNTLR_VECGEN_VHR.png

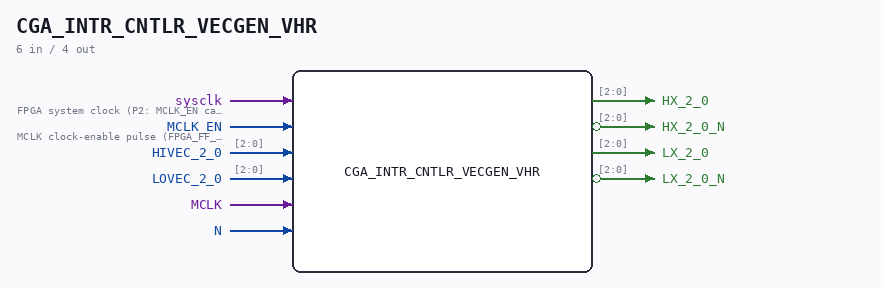
Verilog/DELILAH-CPU/CGA_INTR/circuit/doc/CGA_INTR_CNTLR_VECGEN_VHR.png
