RonnyA/nd-120/Verilog/DELILAH-CPU/CGA_MAC/circuit/doc/CGA_MAC_LASEL.png

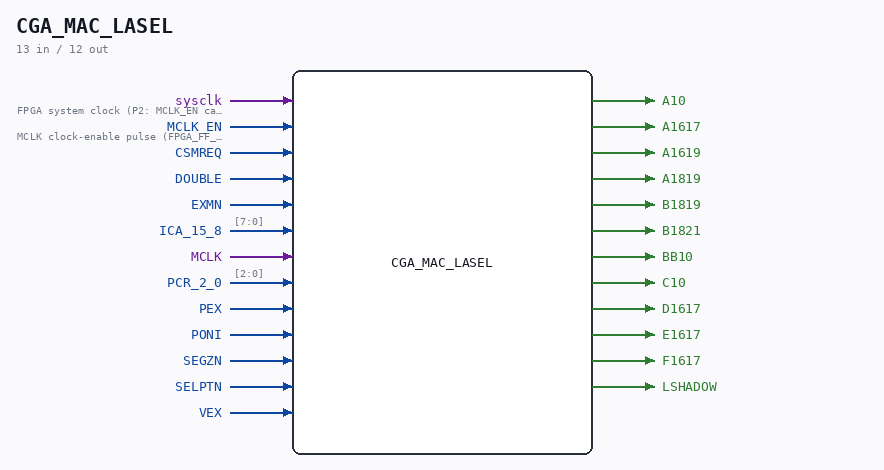
Verilog/DELILAH-CPU/CGA_MAC/circuit/doc/CGA_MAC_LASEL.png
