RonnyA/nd-120/Verilog/DELILAH-CPU/CGA_MIC/circuit/doc/CGA_MIC_STACK.png

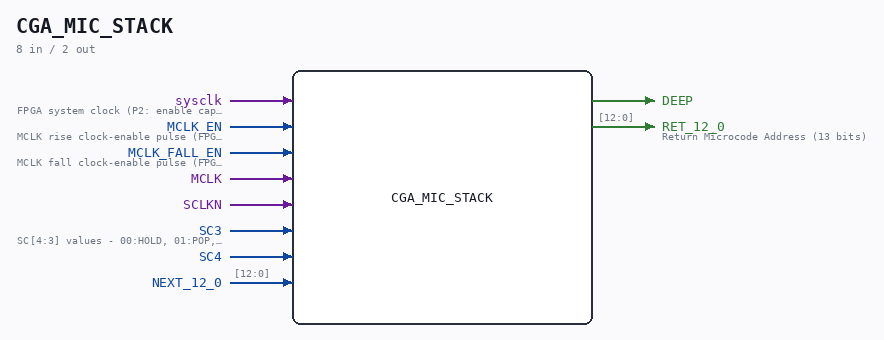
Verilog/DELILAH-CPU/CGA_MIC/circuit/doc/CGA_MIC_STACK.png
