RonnyA/nd-120/Verilog/fpga/cmod-a7-35t/doc/nd120_cmod_top.png

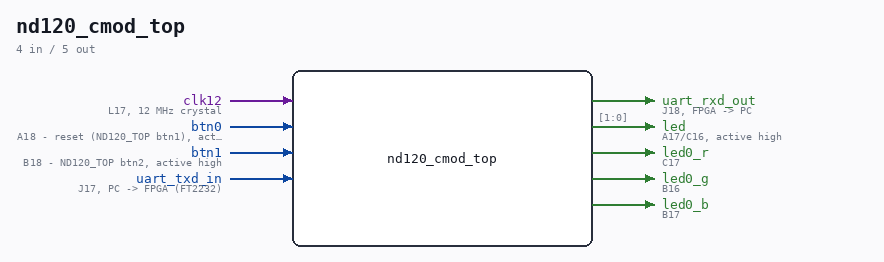
Verilog/fpga/cmod-a7-35t/doc/nd120_cmod_top.png
