RonnyA/nd-120/Verilog/fpga/nexys4ddr/ddr2-test/ip/ddr/ddr/example_design/rtl/doc/example_top.png

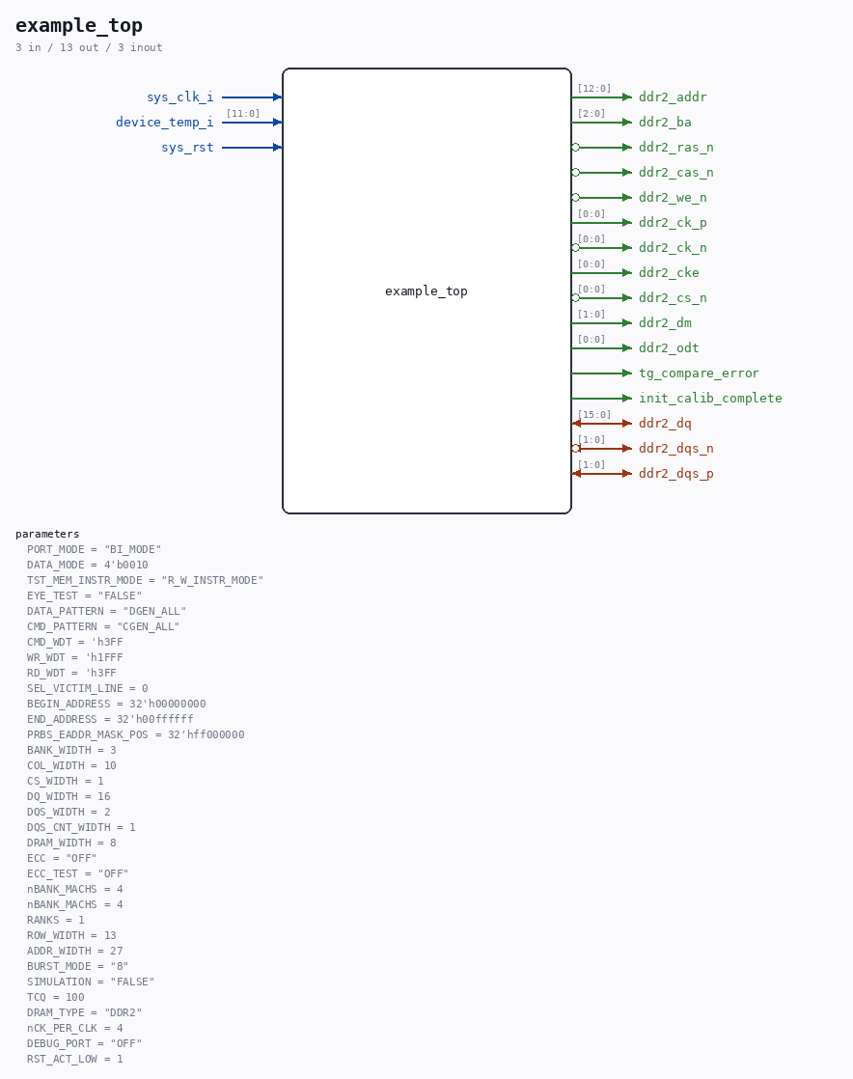
Verilog/fpga/nexys4ddr/ddr2-test/ip/ddr/ddr/example_design/rtl/doc/example_top.png
