RonnyA/nd-120/Verilog/fpga/nexys4ddr/ddr2-test/ip/ddr/ddr/example_design/rtl/traffic_gen/doc/mig_7series_v4_2_data_prbs_gen.png

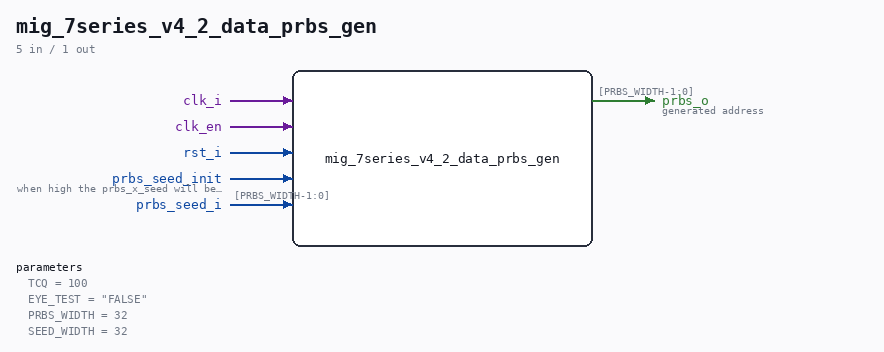
Verilog/fpga/nexys4ddr/ddr2-test/ip/ddr/ddr/example_design/rtl/traffic_gen/doc/mig_7series_v4_2_data_prbs_gen.png
