RonnyA/nd-120/Verilog/fpga/nexys4ddr/ddr2-test/ip/ddr/ddr/user_design/rtl/clocking/doc/mig_7series_v4_2_iodelay_ctrl.png

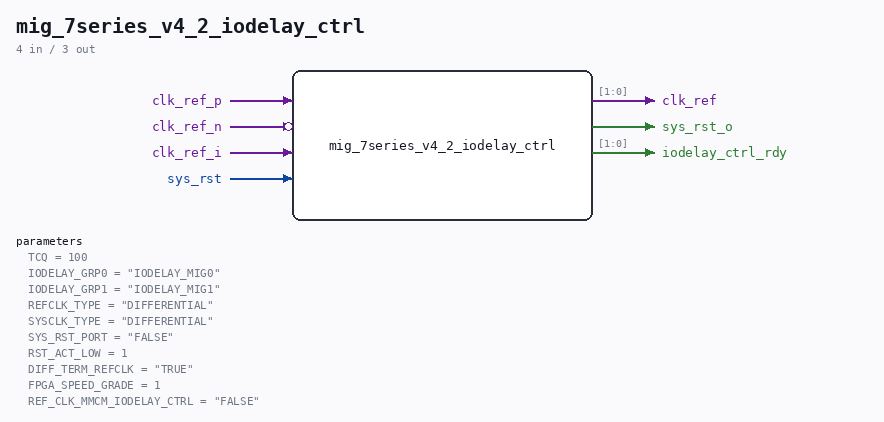
Verilog/fpga/nexys4ddr/ddr2-test/ip/ddr/ddr/user_design/rtl/clocking/doc/mig_7series_v4_2_iodelay_ctrl.png
