RonnyA/nd-120/Verilog/fpga/nexys4ddr/ddr2-test/ip/ddr/ddr/user_design/rtl/doc/ddr_mig.png

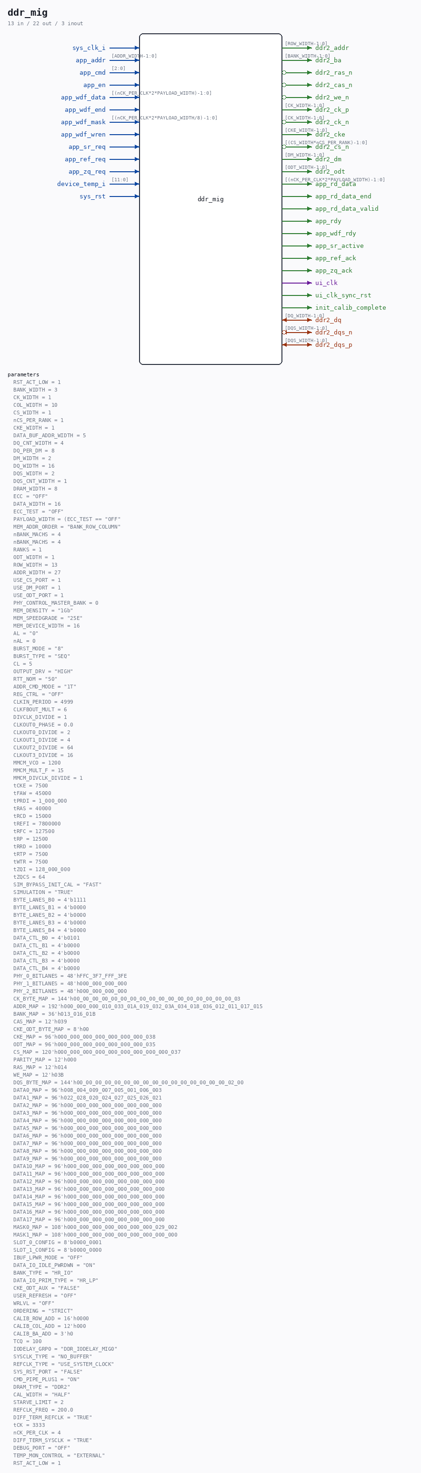
Verilog/fpga/nexys4ddr/ddr2-test/ip/ddr/ddr/user_design/rtl/doc/ddr_mig.png
