RonnyA/nd-120/Verilog/fpga/nexys4ddr/ddr2-test/ip/ddr/ddr/user_design/rtl/ecc/doc/mig_7series_v4_2_fi_xor.png

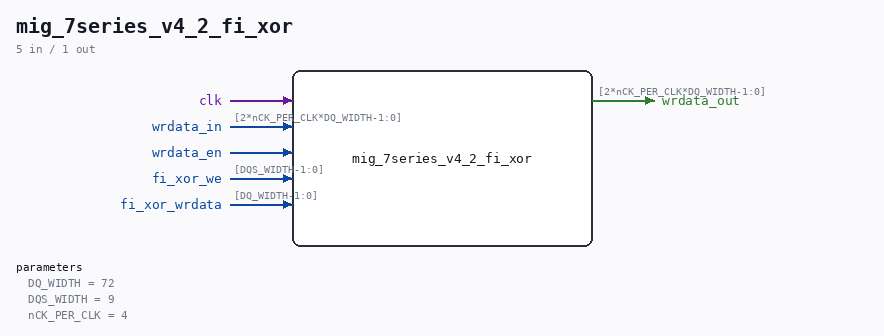
Verilog/fpga/nexys4ddr/ddr2-test/ip/ddr/ddr/user_design/rtl/ecc/doc/mig_7series_v4_2_fi_xor.png
