RonnyA/nd-120/Verilog/fpga/nexys4ddr/ddr2-test/ip/ddr/ddr/user_design/rtl/ip_top/doc/mig_7series_v4_2_mem_intfc.png

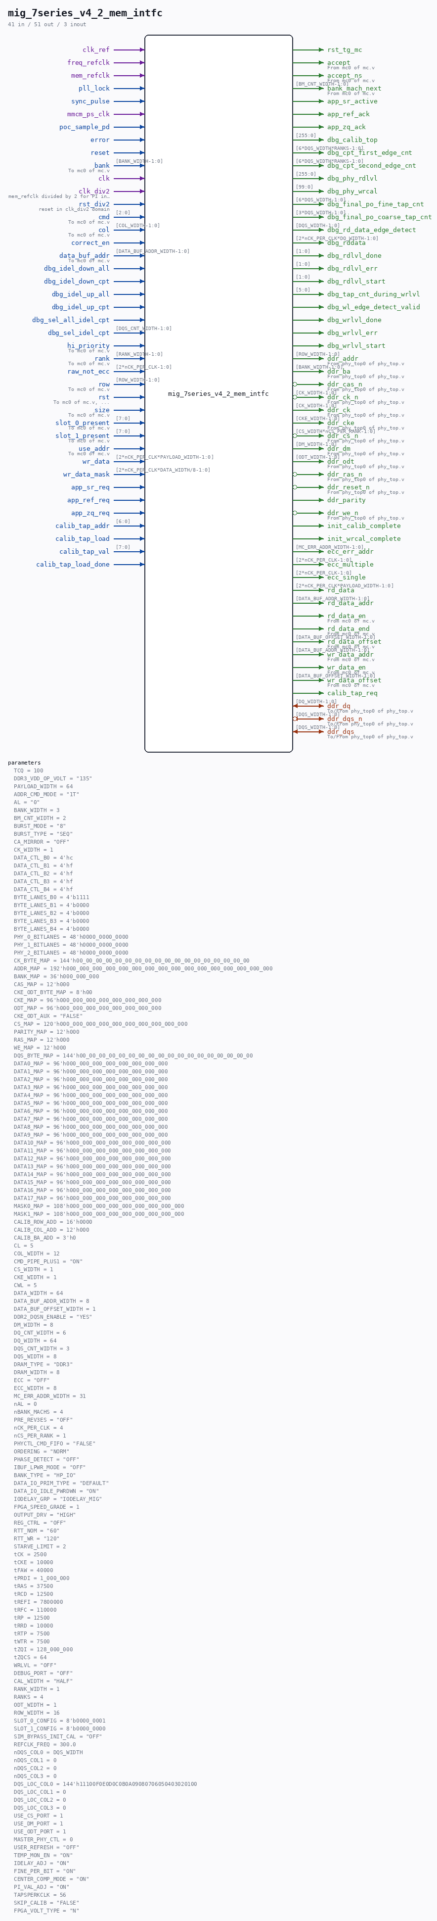
Verilog/fpga/nexys4ddr/ddr2-test/ip/ddr/ddr/user_design/rtl/ip_top/doc/mig_7series_v4_2_mem_intfc.png
