RonnyA/nd-120/Verilog/fpga/nexys4ddr/ddr2/doc/nd_ddr2_storage.png

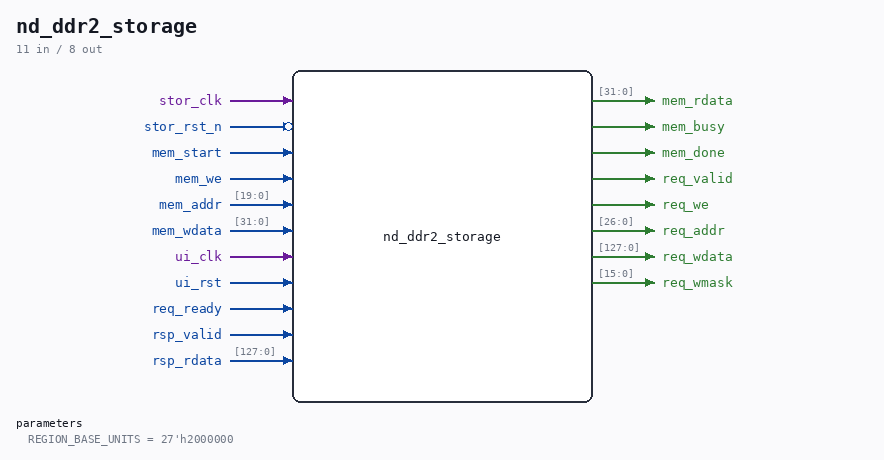
Verilog/fpga/nexys4ddr/ddr2/doc/nd_ddr2_storage.png
