RonnyA/nd-120/Verilog/fpga/tang-nano-20k/sdram-bridge/doc/sdram18.png

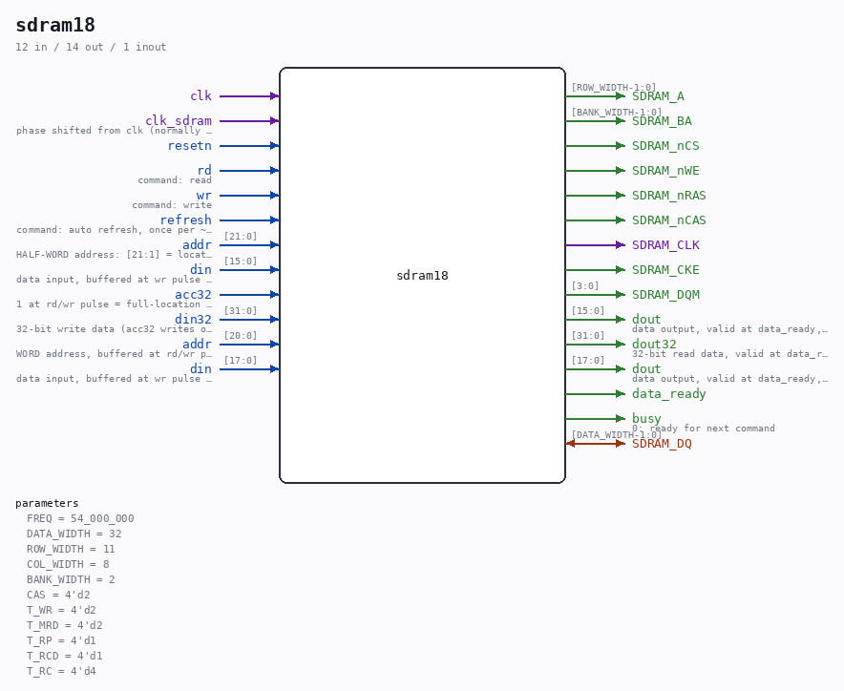
Verilog/fpga/tang-nano-20k/sdram-bridge/doc/sdram18.png
