RonnyA/nd-120/Verilog/ND-BUS-DEVICES/BUS-IF/circuit/doc/ND_BUS_SLAVE.png

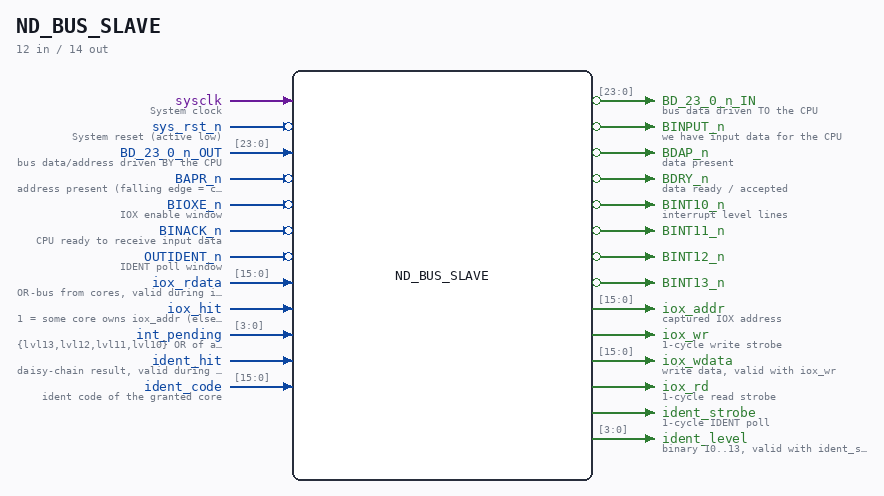
Verilog/ND-BUS-DEVICES/BUS-IF/circuit/doc/ND_BUS_SLAVE.png
