RonnyA/nd-120/Verilog/ND-BUS-DEVICES/DMA/circuit/doc/ND_DMA_MASTER.png

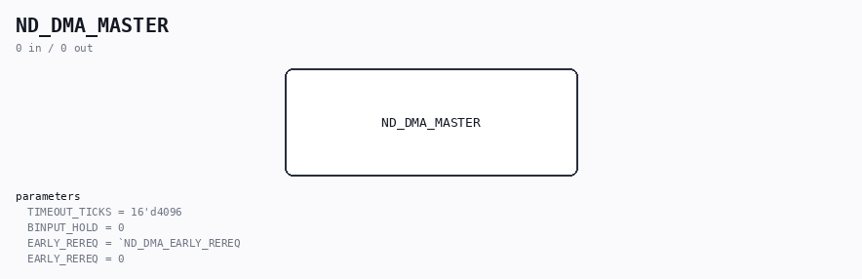
Verilog/ND-BUS-DEVICES/DMA/circuit/doc/ND_DMA_MASTER.png
