RonnyA/nd-120/Verilog/ND-BUS-DEVICES/FLOPPY-DMA/circuit/doc/ND_FLOPPY_DMA.png

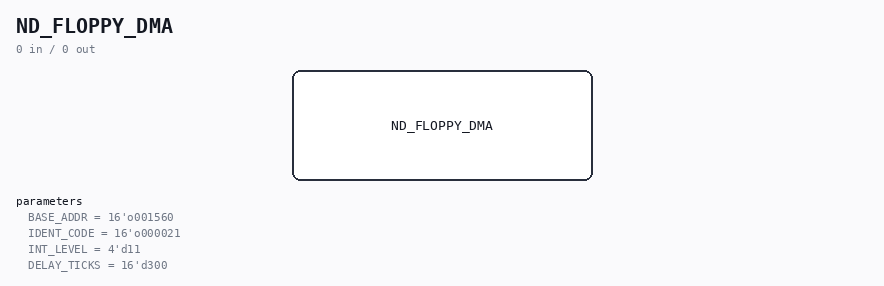
Verilog/ND-BUS-DEVICES/FLOPPY-DMA/circuit/doc/ND_FLOPPY_DMA.png
