RonnyA/nd-120/Verilog/ND-BUS-DEVICES/TAPE-400/circuit/doc/ND_TAPE_400.png

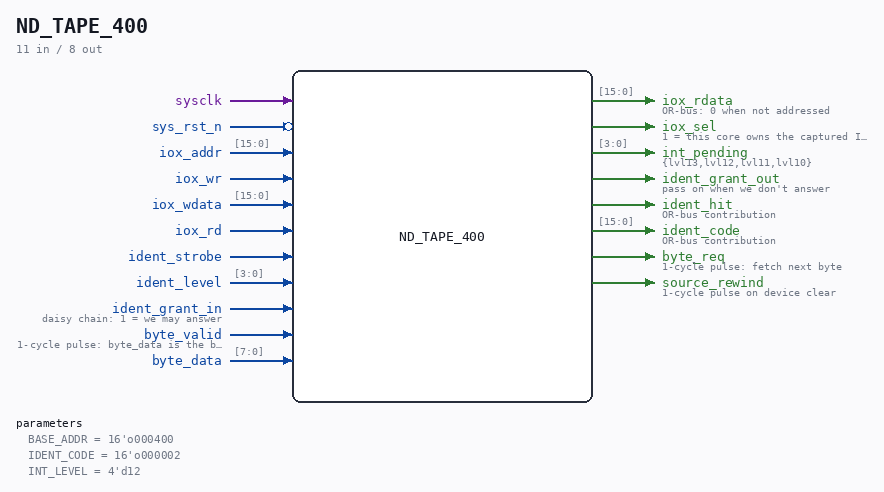
Verilog/ND-BUS-DEVICES/TAPE-400/circuit/doc/ND_TAPE_400.png
