RonnyA/nd-120/Verilog/ND-BUS-DEVICES/WINCHESTER/circuit/doc/ND_WINCHESTER.png

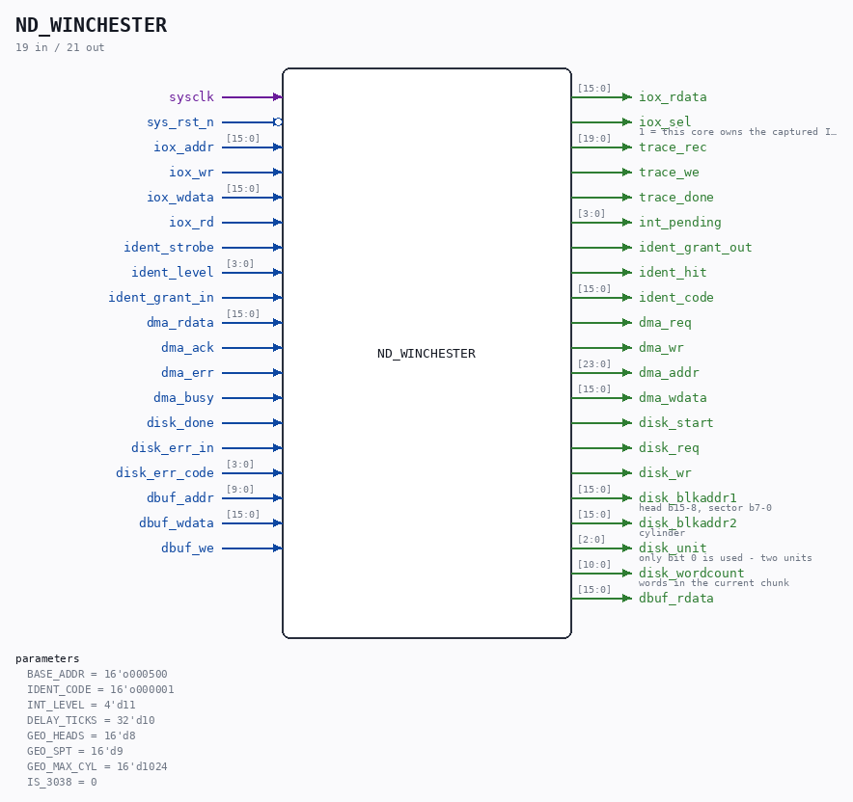
Verilog/ND-BUS-DEVICES/WINCHESTER/circuit/doc/ND_WINCHESTER.png
