RonnyA/nd-120/Verilog/PAL/doc/PAL_44511A_EN.png

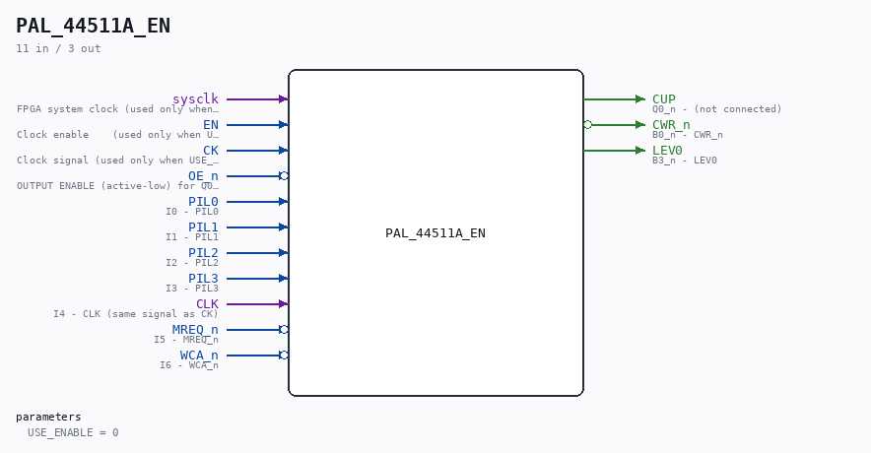
Verilog/PAL/doc/PAL_44511A_EN.png
