RonnyA/nd-120/Verilog/SD-FAT/circuit/doc/nd_storage_devices.png

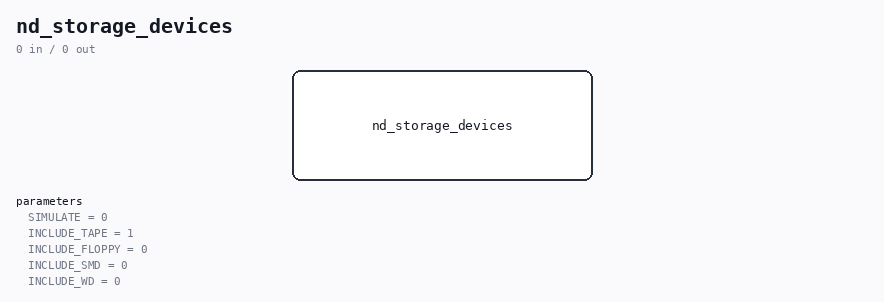
Verilog/SD-FAT/circuit/doc/nd_storage_devices.png
