RonnyA/nd-120/Verilog/SD-FAT/circuit/doc/nd_storage_floppy_adapter.png

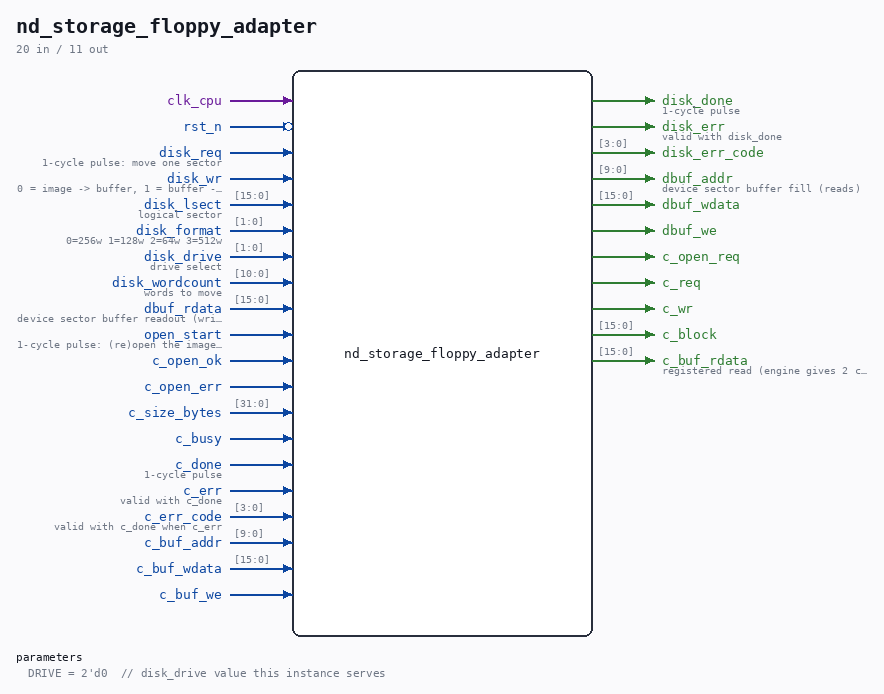
Verilog/SD-FAT/circuit/doc/nd_storage_floppy_adapter.png
