RonnyA/nd-120/Verilog/SD-FAT/circuit/doc/sd_card_ctrl.png

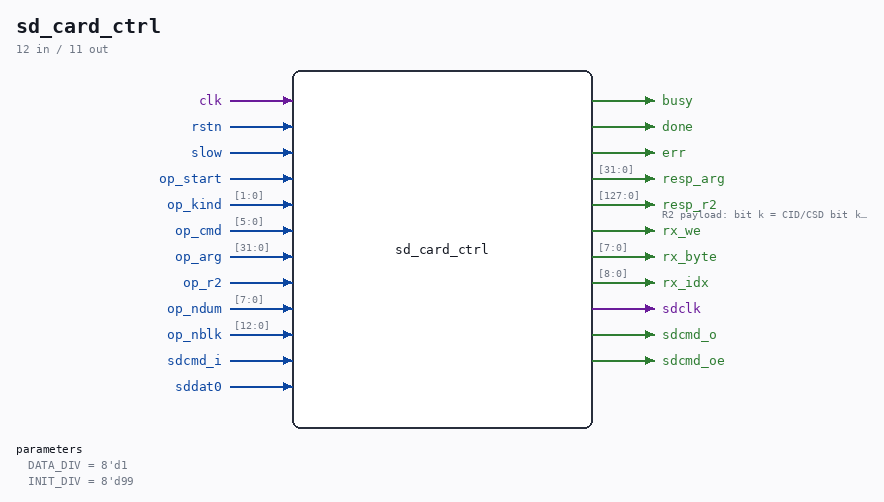
Verilog/SD-FAT/circuit/doc/sd_card_ctrl.png
