RonnyA/nd-120/Verilog/SD-FAT/circuit/doc/sd_writer.png

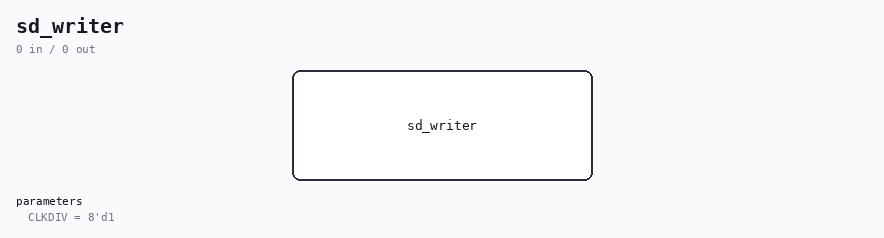
Verilog/SD-FAT/circuit/doc/sd_writer.png
