RonnyA/nd-120/Verilog/Shared/ndlib/doc/D_FLIPFLOP_EN.png

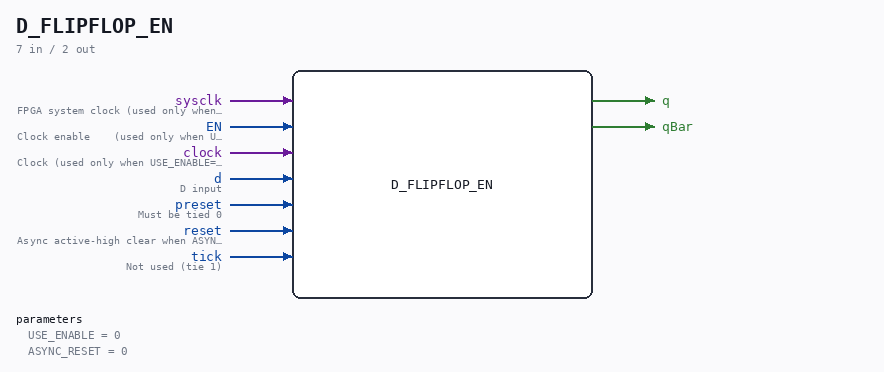
Verilog/Shared/ndlib/doc/D_FLIPFLOP_EN.png
