RonnyA/nd-120/Verilog/Shared/ndlib/doc/F924_EN.png

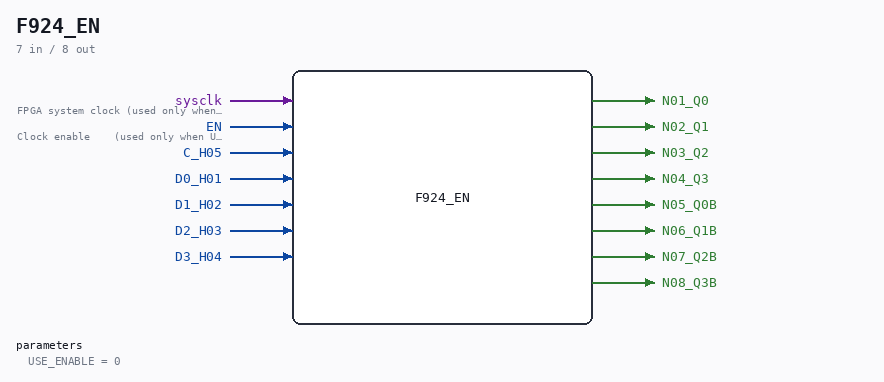
Verilog/Shared/ndlib/doc/F924_EN.png
