RonnyA/nd-120/Verilog/Shared/ndlib/doc/MUX21LP.png

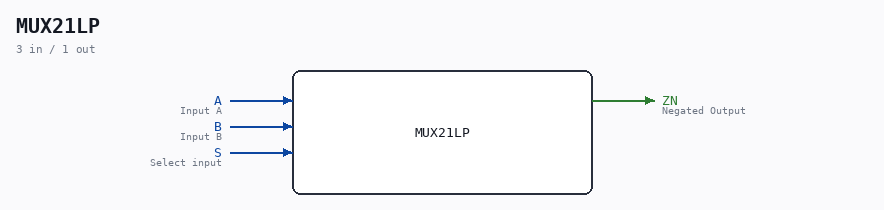
Verilog/Shared/ndlib/doc/MUX21LP.png
