RonnyA/nd-120/Verilog/Shared/ndlib/doc/MUX34P.png

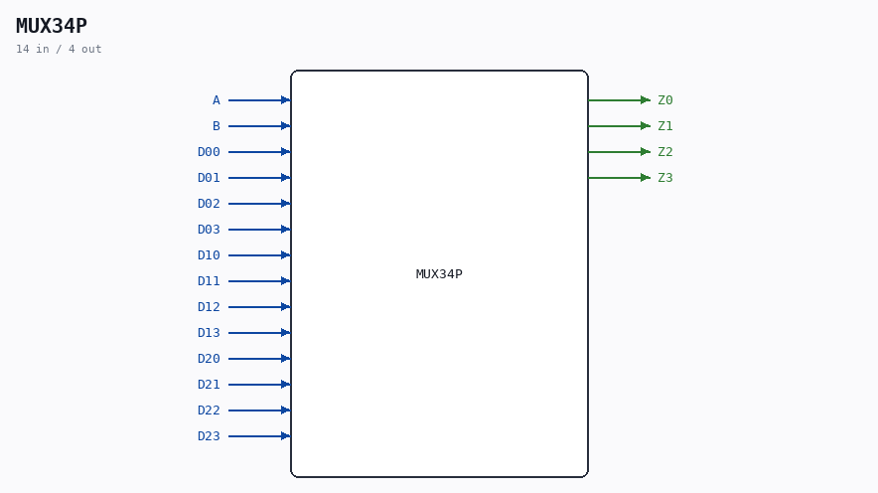
Verilog/Shared/ndlib/doc/MUX34P.png
