RonnyA/nd-120/Verilog/Shared/ndlib/doc/R81_EN.png

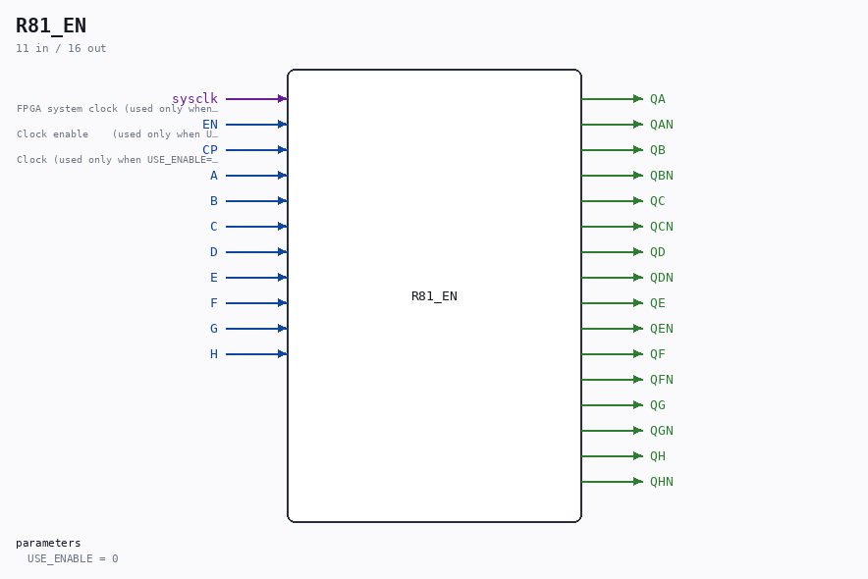
Verilog/Shared/ndlib/doc/R81_EN.png
