RonnyA/nd-120/Verilog/Shared/ndlib/doc/SCAN_WITH_RESET_N.png

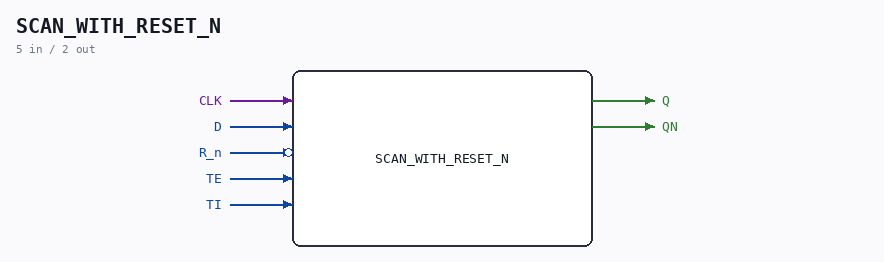
Verilog/Shared/ndlib/doc/SCAN_WITH_RESET_N.png
