RonnyA/nd-120/Verilog/Shared/ndlib/doc/SR44_EN.png

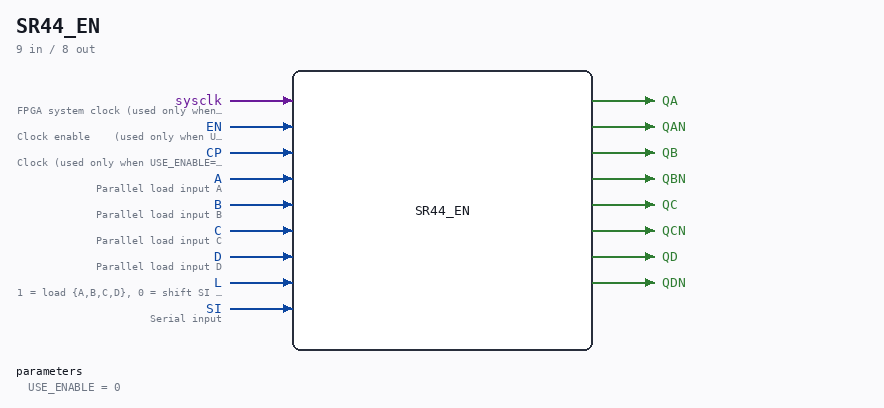
Verilog/Shared/ndlib/doc/SR44_EN.png
