RonnyA/nd-120/Verilog/Shared/support/doc/Am9150.png

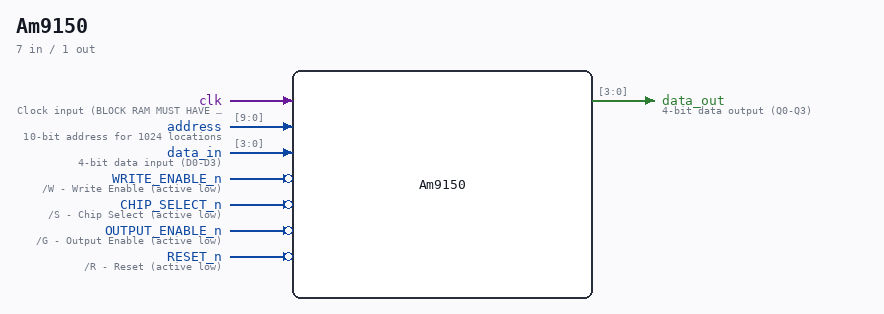
Verilog/Shared/support/doc/Am9150.png
