RonnyA/nd-120/Verilog/tests/doc-examples/schematic_TTL_74245_NEW_fixed.png

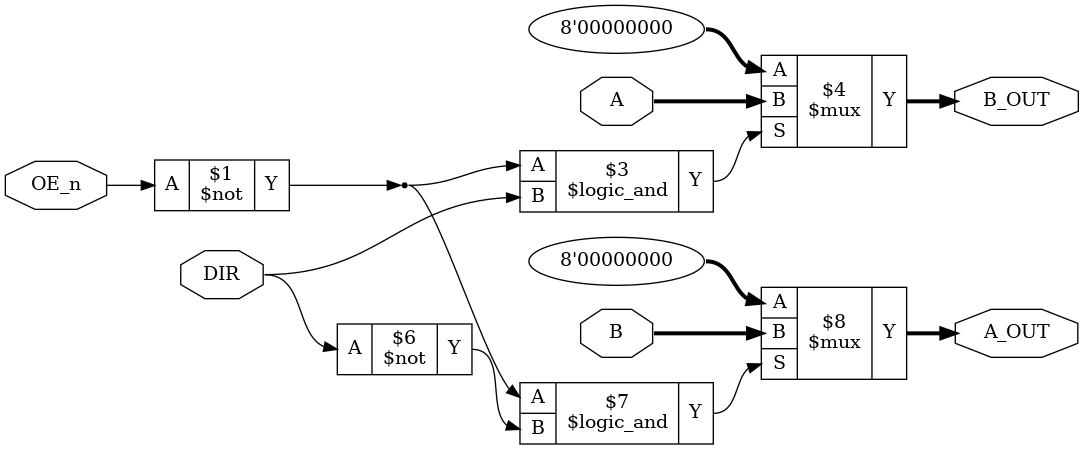
Verilog/tests/doc-examples/schematic_TTL_74245_NEW_fixed.png
