RonnyA/nd-120/Verilog/Shared/support/doc/BACKWIRING_PROM.md

# BACKWIRING_PROM

**Back-wiring PROM (installation number), addressed by PIL[3:0]**

Source: `/mnt/e/Dev/Repos/Ronny/nd-120/Verilog/Shared/support/BACKWIRING_PROM.v`
  ·  Author: Ronny Hansen

> Generated by `Verilog/tests/module_doc.py` from the `//!`
> comments in the source. Do not edit by hand - edit the RTL comments and regenerate.

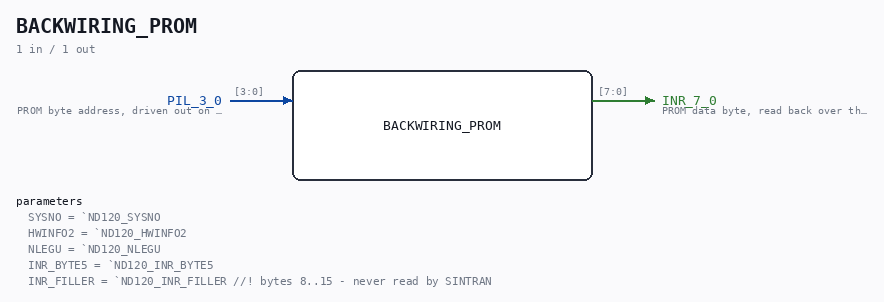
[picture p144: Verilog/Shared/support/doc/BACKWIRING_PROM.png]
BACKWIRING_PROM symbol


## Description

BACK-WIRING PROM (installation number PROM)
The small PROM that sits on the ND-100/ND-120 BACKPLANE behind the
CPU board's B-plug. It is NOT an I/O device: it is not reachable by
IOX, not memory mapped, and not reachable by TRA/TRR. The only way to
read it is the VERSN instruction (opcode 140133 octal), which selects
the internal data bus source IDBS,INR (code 35 octal).
Signal path (all citations are files in this repo):
DECODE-GateArray/DGA/circuit/DECODE_DGA_IDBS.v:32
RINRN  - "Read Installation Number from B-PLUG (RINR) IDBS=35"
CPU-BOARD-3202/circuit/ND3202D.v:83
input [7:0] INR_7_0 - under "BACKPLANE B-PLUG / FROM B plug"
CPU-BOARD-3202/circuit/ND3202D.v:89
output [3:0] PIL    - driven OUT to the same B-plug
CPU-BOARD-3202/circuit/IO_REG_41.v:189
s_idb_7_0_inr_out = s_rinr_n ? 8'b0 : s_inr_7_0
CPU-BOARD-3202/circuit/IO_37.v:295
5'o35: s_idb_mux = s_idb_15_0_reg_out;  // RINR
B-plug pin order of the 8 INR data bits, preserved from the original
ND120_CORE.v comment on the .INR_7_0() connection:
INR7..INR0 = B15, B4, B5, B17, B8, B7, B13, B6
and the PIL nibble that addresses this PROM:
XPIL3=B-C8, PIL2=B-B12, PIL1=B-B10, PIL0=B-B9
ADDRESSING - INFERENCE, NOT READ FROM A SCHEMATIC.
No backplane schematic for the PROM decode was found in this repo or
in NDInsight, and no dump of a real back-wiring PROM exists here
either. That PIL[3:0] is the PROM's byte address is STRONG INFERENCE
from three independent things:
1. the VERSN microcode does COMM,LDPIL (from A bits 8-11) and then
samples IDBS,INR - Code/Microcode/ND-120-DELILAH-L.LISTING.txt
lines 115-119;
2. the CPU board drives PIL out to the B-plug and takes INR back
in from it (the paired signals above);
3. SINTRAN's GCPUNR reads exactly 8 bytes by executing VERSN once
per interrupt level 0..7 - E:\Dev\Ronny\NDInsight\SINTRAN\
NPL-SOURCE\NPL\PH-P2-OPPSTART.NPL:3534-3570.
MICROCODE TIMING NOTE (real hardware bug, both behaviours work):
LDPIL has not settled when the very next microword samples IDBS,INR,
so the CURRENT PIL is used instead of the just-loaded one. ND-120
revision L inserts a COMM,SLOW microword between them to fix this
(L.LISTING.txt:122, "L-ONLY WORD"); revision K (K.LISTING.txt:116-119)
and the ND-100/ND-110 do not have it. SINTRAN works around it
unconditionally by running VERSN on levels 0..7, so this model is
correct for both: it simply decodes whatever PIL nibble the CPU board
presents.
Byte layout that SINTRAN GCPUNR decodes (bytes 8-15 are never read):
0 (MSB) + 1 (LSB) : SYSNO   -> banner "CPU NUMBER"; -1 = absent
2 (MSB) + 3 (LSB) : HWINFO(2) system type -> "CPU TYPE"; -1 = absent
4               : NLEGU number of legal users; 0377B = absent
5               : not used by SINTRAN (GCPUNR does INF2 SHZ -10)
6 + 7           : signature INF3, MUST be 52652B = 0x55AA
8..15           : unknown, SINTRAN never reads them
If the signature is wrong GCPUNR EXITs and every other byte is
ignored, so bytes 6/7 are hardwired here and are NOT parameterised.
Ronny Hansen

## Parameters

| Parameter | Default |
|---|---|
| `SYSNO` | ``ND120_SYSNO` |
| `HWINFO2` | ``ND120_HWINFO2` |
| `NLEGU` | ``ND120_NLEGU` |
| `INR_BYTE5` | ``ND120_INR_BYTE5` |
| `INR_FILLER` | ``ND120_INR_FILLER //! bytes 8..15 - never read by SINTRAN` |

## Ports

| Direction | Width | Name | Description |
|---|---|---|---|
| input | `[3:0]` | `PIL_3_0` | PROM byte address, driven out on the B-plug by the CPU board |
| output | `[7:0]` | `INR_7_0` | PROM data byte, read back over the B-plug (IDBS,INR = 35 octal) |
