RonnyA/nd-120/Verilog/fpga/tang-nano-20k/sd-fat-test/src/doc/sd_fat_test_top.md

# sd_fat_test_top

Source: `/mnt/e/Dev/Repos/Ronny/nd-120/Verilog/fpga/tang-nano-20k/sd-fat-test/src/sd_fat_test_top.v`

> Generated by `Verilog/tests/module_doc.py` from the `//!`
> comments in the source. Do not edit by hand - edit the RTL comments and regenerate.

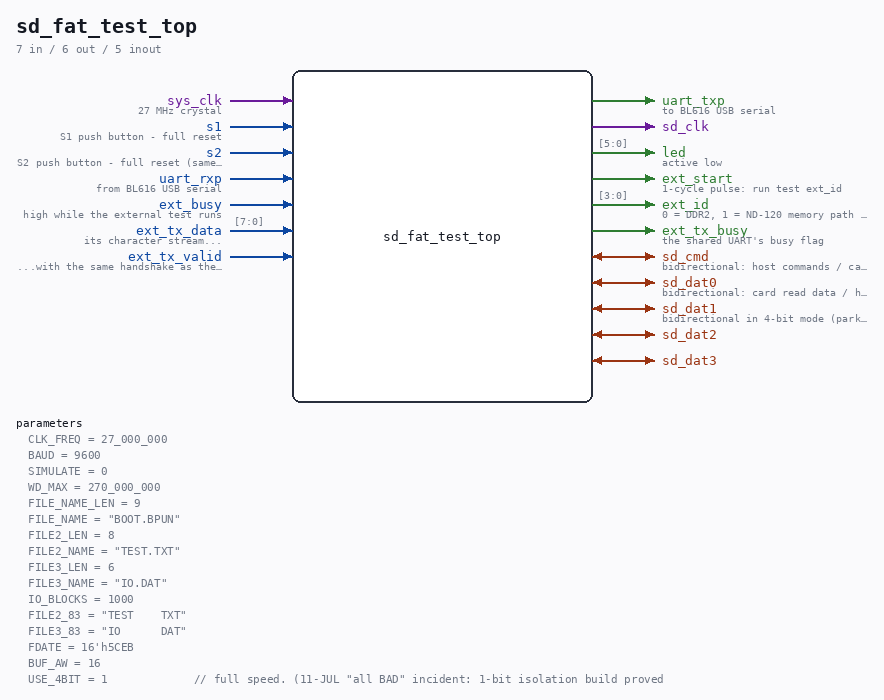
[picture p156: Verilog/fpga/tang-nano-20k/sd-fat-test/src/doc/sd_fat_test_top.png]
sd_fat_test_top symbol


## Description

Tang Nano 20K SD + FAT test (Milestone 1 of the SD-BPUN device plan)
Interactive UART menu (BL616 USB serial, 9600 8N1) over the reusable
SD/FAT library in Verilog/SD-FAT/:
SD: OK                     (persistent card status)
1=LIST 2=DUMP BOOT.BPUN 3=COPY TO TEST.TXT H=HELP
#
1  re-init the card, mount FAT16/FAT32, list the root directory:
size (or <DIR>), date and name of every file and subdirectory
2342  10-JAN-2025  BOOT.BPUN
<DIR>  11-JUL-2026  HDD
then a disk-info line: card capacity (from the CMD9 CSD), volume
size (total sectors) and free space (one FAT #0 scan counting
free entries; a SCANNING line is printed first - a 32 GB card
takes seconds):
CARD 30436 MB  VOL 30425 MB  FREE 30298 MB
2  find BOOT.BPUN, buffer it (64 KB BRAM) and hex/octal-dump it
3  COPY: read BOOT.BPUN into the buffer, then make TEST.TXT an exact
copy. If TEST.TXT's allocation is big enough its data sectors are
rewritten in place and only the size field is patched; if it is
TOO SMALL (or empty) it is REPLACED: sd_fat_rewrite frees the old
cluster chain, allocates a fresh contiguous chain and patches the
directory entry, then the data is written. TEST.TXT must already
exist on the card (any size).
4  WRBLK1: write a counter pattern (1024 big-endian 16-bit words,
word[w] = w) into 1-kiloword block 1 of BOOT.BPUN. ND-120 block
framing: 1 block = 1024 words = 2048 bytes = 4 SD sectors; block
N of a file lives at file_first_sector + 4*N. Refuses when the
file is smaller than (N+1)*2048 bytes (a shorter file's cluster
chain ends inside the block - writing there would corrupt the
NEXT file). Validate with 2 (DUMP): block 1 shows the pattern,
blocks 0 and 2 are untouched.
8  BLOCK: dump 1-kiloword block N of the target file WITHOUT
buffering the file. The reader runs with no_stream=1 (directory
match only), the 4 sectors of the block are read one at a time
through the sd_writer engine's READ path and dumped. Cost and
memory are the same for a 7 KB file and a 75 MB one - which is the
point: command 2 cannot look at anything past its 64 KB buffer.
The block number is typed on the console in decimal.
9  SECTOR: dump one ABSOLUTE SD sector, number typed in decimal, with
the FAT not consulted at all. This is what separates "the
directory entry points at the wrong place" from "the card really
holds zeros there" - the two look identical through command 2.
R  RANGE: read a run of consecutive blocks (start block and count
typed on the console) the same streaming way, keeping only a
16-bit checksum of every word and a block count - the data never
reaches the console, because a 1000-block hex dump at 9600 baud
would take about six hours. One progress line per 64 blocks, then
a summary: blocks, sectors, checksum, 27 MHz cycles of card
traffic, PASS or FAIL. A failed card read stops the run and names
the exact sector and block - that is what this command is for:
every earlier check read a SINGLE block, and SINTRAN segment
handling is the first thing that reads many in a row.
N  set the target file name at runtime (root directory only, 8.3
name, length-exact - that is all sd_file_reader can match)
H  detailed help; any other key reprints the menu
S1 / S2 (either button) full reset
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
