RonnyA/nd-120/Verilog/DELILAH-CPU/CGA_TESTMUX/gtkwave.png

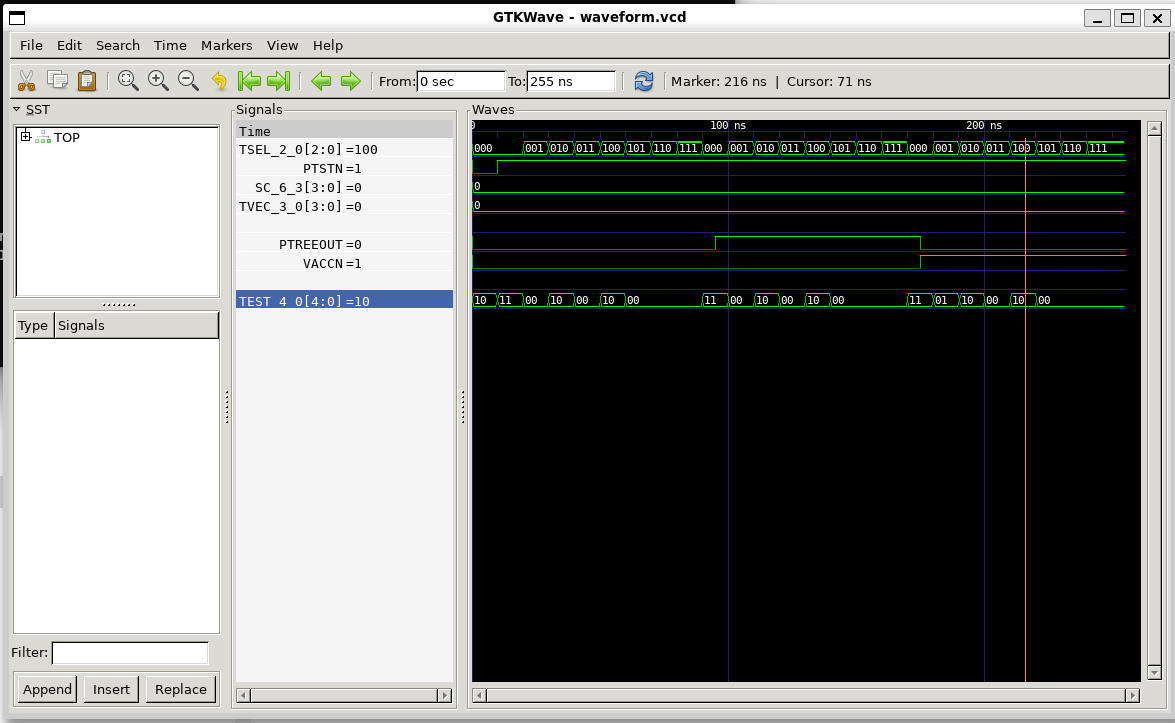
Verilog/DELILAH-CPU/CGA_TESTMUX/gtkwave.png
