RonnyA/nd-120/Verilog/fpga/nexys4ddr/sd-fat-test/doc/nd_memtest_ddr2.png

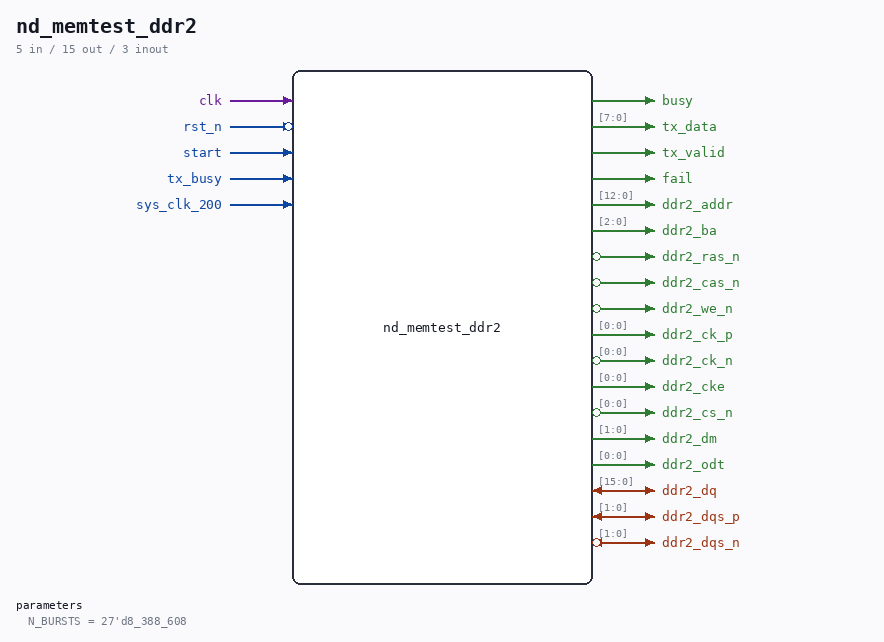
Verilog/fpga/nexys4ddr/sd-fat-test/doc/nd_memtest_ddr2.png
