RonnyA/nd-120/Verilog/fpga/tang-nano-20k/sd-fat-test/src/doc/hex_dumper.png

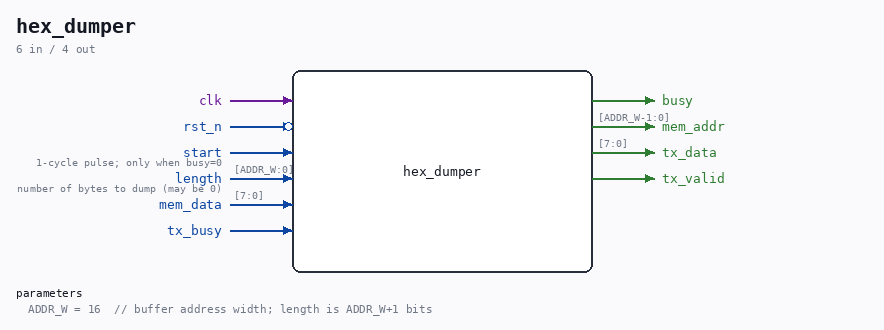
Verilog/fpga/tang-nano-20k/sd-fat-test/src/doc/hex_dumper.png
