RonnyA/nd-120/Verilog/fpga/tang-nano-20k/sd-fat-test/src/doc/uart_rx.png

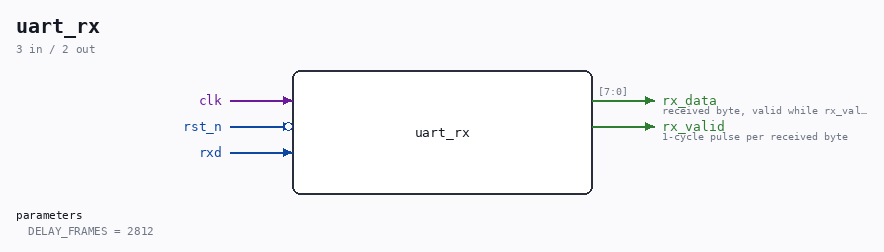
Verilog/fpga/tang-nano-20k/sd-fat-test/src/doc/uart_rx.png
