RonnyA/nd-120/Verilog/fpga/tang-nano-20k/sdram18-test/src/doc/sdram18_test_top.png

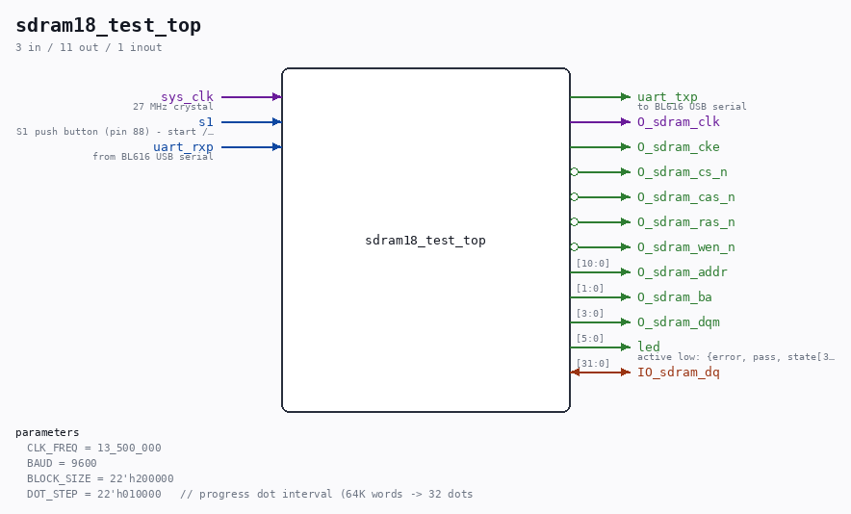
Verilog/fpga/tang-nano-20k/sdram18-test/src/doc/sdram18_test_top.png
