RonnyA/nd-120/Verilog/tests/doc-examples/waveform_TTL_74245.png

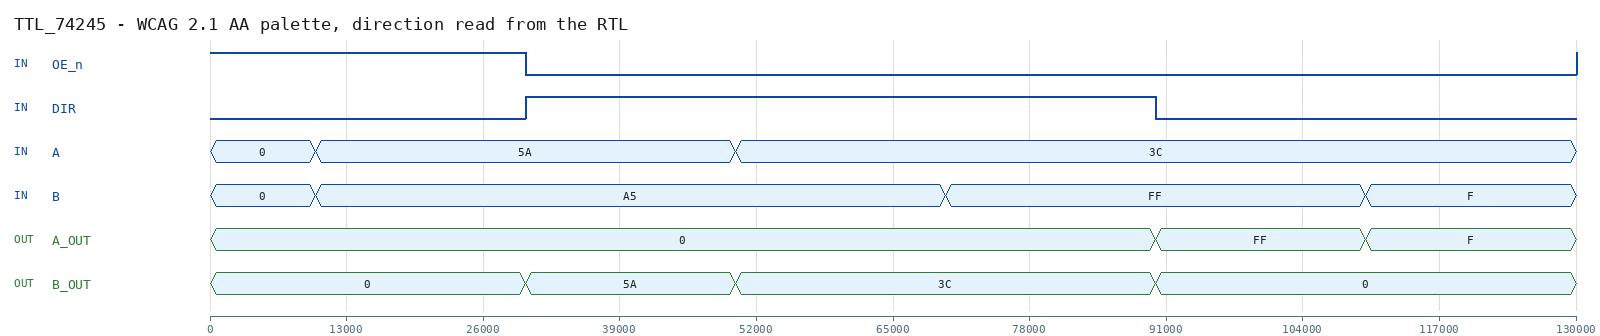
Verilog/tests/doc-examples/waveform_TTL_74245.png
