RonnyA/nd-120/Verilog/tests/doc-examples/waveform_TTL_74245_darkmode.png

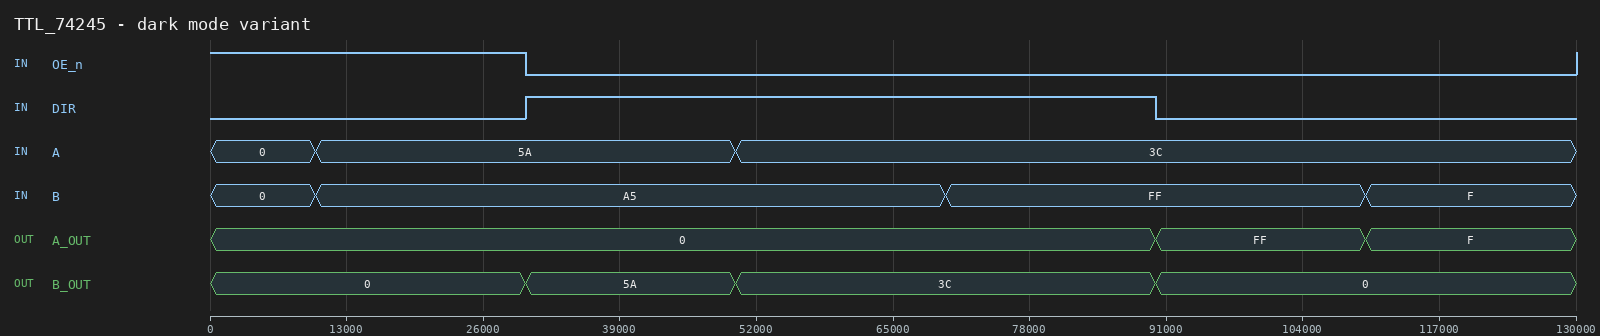
Verilog/tests/doc-examples/waveform_TTL_74245_darkmode.png
