RonnyA/nd-120/Verilog/docs/HANDOFF-issue-c-movew-apt-fix.md

# HANDOFF: Issue C (MOVEW APT->APT boundary-word drop) - fixed, tb done, awaiting silicon + commit

Date: 31-JUL-2026, ~12:30. State written for a cold restart of the session.
Issue tracker: Verilog/fpga/tang-nano-20k/PLAN-tang-diagnostics-rootcause.md

## What Issue C was

MOVEW with source=APT and destination=APT drops the word written at the
destination page boundary. Root cause (MEASURED, then schematic-verified on
DELILAH.pdf page 25, CGA/MAC/DECODE sheet 1 of 4, and independently confirmed
wrong in the Logisim schematic by Ronny):

- File: Verilog/DELILAH-CPU/CGA_MAC/circuit/CGA_MAC_DECODE.v
- GATES_5 third input was `s_cscomm_4`; the schematic shows ICSMIS0
  (= `s_csmis_0_n`). Consequence: for CSCOMM 0o34/0o35 (RDRQ/WRRQ) with
  CSMIS=1 (APT), BOTH SPT and SAPT asserted -> the PTSEL JK flip-flop
  (J=SPT, K=SAPT, MCLK-clocked) TOGGLED instead of selecting APT -> from the
  APT state it flipped to PT -> wrong page table consulted at the destination
  first-touch -> spurious level-14 page fault killed the in-flight boundary
  write. APT->APT only.
- The fix is IN the file (with a 31-JUL-2026 comment block at GATES_5) but
  UNCOMMITTED. Ronny fixed the same error in the Logisim schematic himself.

Signal-naming trap in that file: `s_cscomm_N` = ~CSCOMM[N] (inverted),
`s_cscomm_N_n` = CSCOMM[N] (true); same for csmis. NAND/NOR via BubblesMask.

## Testbench (Ronny's explicit request: "make sure it works 100%") - DONE

- Verilog/DELILAH-CPU/CGA_MAC/sim/CGA_MAC_DECODE_tb.v
  Self-checking iverilog tb, 1051 checks, `TB_RESULT: PASS` verdict:
  1. exhaustive 512-combination sweep {WR7,WR3,CSMIS[1:0],CSCOMM[4:0]} vs an
     embedded golden table (generated by an independent Python model of the
     post-fix equations; generator lives in the session scratchpad, equations
     schematic-verified);
  2. SPT/SAPT mutual-exclusion invariant on every combination (the Issue-C
     tooth: co-assertion is what made PTSEL toggle);
  3. direct RDRQ/WRRQ x APT/PT decode checks;
  4. MCLK-registered LLDEXM/LLDSEG/LLDPCR strobes: load/hold/clear/LCSN-block.
- Verilog/DELILAH-CPU/CGA_MAC/sim/Makefile
  New `test-decode` target runs the tb TWICE: default latch/CP mode and
  -DFPGA_FF_MODE. Both print `TB_RESULT: PASS (1051 checks)`.
- Registered in Verilog/tests/run_all_tests.sh
  as `DELILAH-CPU/CGA_MAC/sim  :: test-decode  :: TB_RESULT: PASS`.
- Teeth PROVEN: a mutant copy carrying the pre-fix wiring
  (GATES_5.input3 = s_cscomm_4) fails exactly on (CSMIS=1, CSCOMM=0o34/0o35)
  with "SPT and SAPT both asserted - PTSEL JK would toggle", nothing else.
  The mutant existed only in the session scratchpad; the repo file was never
  mutated.

## Validation state

Sim (all PASS):
- cx-instructions via TPE: PASS, 0 errors (the exact test that failed pre-fix).
- Full INSTRUCTION level-1 sweep: all 15 areas PASS.
- Unit registry (Verilog/tests/run_all_tests.sh):
  green except 7 KNOWN fails all outside this fix's logic cone:
  3 stale TRAP tbs (await the vector-7 commit) + test-memchain,
  3x sdram-bridge, test-smd (memory/device workstream; note: these 5 fail
  deterministically although "81/81" passed 30-JUL - unexplained, flagged).
- PAGING All-tests in sim: ran ~2h, hit ND120_MAX_CNT=4e9 still inside test 1,
  ZERO errors printed, no test completed. Full sweep impractical at sim speed;
  silicon is the gate (27 min on the Tang).

Silicon: Tang Nano 20K config flash holds the post-fix Gowin bitstream
(Verilog/fpga/tang-nano-20k/build/nd120_tang20k_build/impl/pnr/nd120_tang20k_build.fs,
built 31-JUL 01:34, flashed twice, last at ~11:50 after Ronny's power-cycle).
SILICON CONFIRMED 31-JUL ~12:45: INSTRUCTION level-1 on the Tang = ALL 15
areas "End of test" INCLUDING Cx instructions (the pre-fix failing area);
then levels 2-9 ALL clean, ending "The tests are now looping" (the verifier's
full-pass behavior - zero errors, restarts by design). Issue C is CLOSED ON
SILICON with a complete multi-level INSTRUCTION sweep. Additionally on the
same flash: CONFIGURATION D05 = NO ERRORS (full 4MB memory map), and PAGING
C02 All-tests = 11/11 "End of test" in 26.5 min - so the PAGING regression
the sim could not finish is closed on silicon too. The CPU fix (committed as
727c23e) is fully validated.
Console /dev/ttyUSB1 9600; after any power-cycle
run `make usb` in Verilog/fpga/tang-nano-20k.
Test recipe: `1560&` -> `load inst` -> `cx-instructions`; optionally
`load pag` -> `run` -> `All-tests` (~27 min, expect 11/11 End of test).

## Open items (in order)

1. Ronny's silicon verdict on cx-instructions (and PAGING All-tests).
2. COMMIT (needs Ronny's explicit go; never mention the AI tooling in the
   commit message, no Co-Authored-By): CGA_MAC_DECODE.v fix +
   CGA_MAC_DECODE_tb.v + CGA_MAC/sim/Makefile + run_all_tests.sh entry.
3. Flag stands: memchain/sdram-bridge x3/smd deterministic fails vs the
   30-JUL "81/81" claim - memory/device workstream, not this fix.
4. Cleanup candidates (Ronny's call): Verilog/runSim/obj_dir_testmode_old,
   obj_dir_cxtrace, obj_dir_sterr, obj_dir_vflop.

## Build facts needed to reproduce

- runSim fast engine: obj_dir_testmode built with
  `-DVERILATOR_SIM -DFPGA_FF_MODE -DND_SDRAM_PACK16 -DND120_VERILOG_DEVICES`
  plus `-DSCRIPT_INPUT -DSCRIPT_CMD_FBOOT` on the C++ side; driven via env:
  ND120_FLOPPY_IMG=FLOPPY1.IMG ND120_SCRIPT='1560&load pag\rrun\rAll-tests\r'
  ND120_AMP_SETTLE=50000000 ND120_MAX_CNT=<budget> from
  Verilog/runSim (do NOT edit Run120.cpp or its
  Makefile - they are Ronny's).
- One Verilator build/run at a time; concurrent obj_dir builds corrupt.
- tb run: `make test-decode` in Verilog/DELILAH-CPU/CGA_MAC/sim
