RonnyA/nd-120/Code/68705/P3/P3/mc68705p3_pinout.pdf

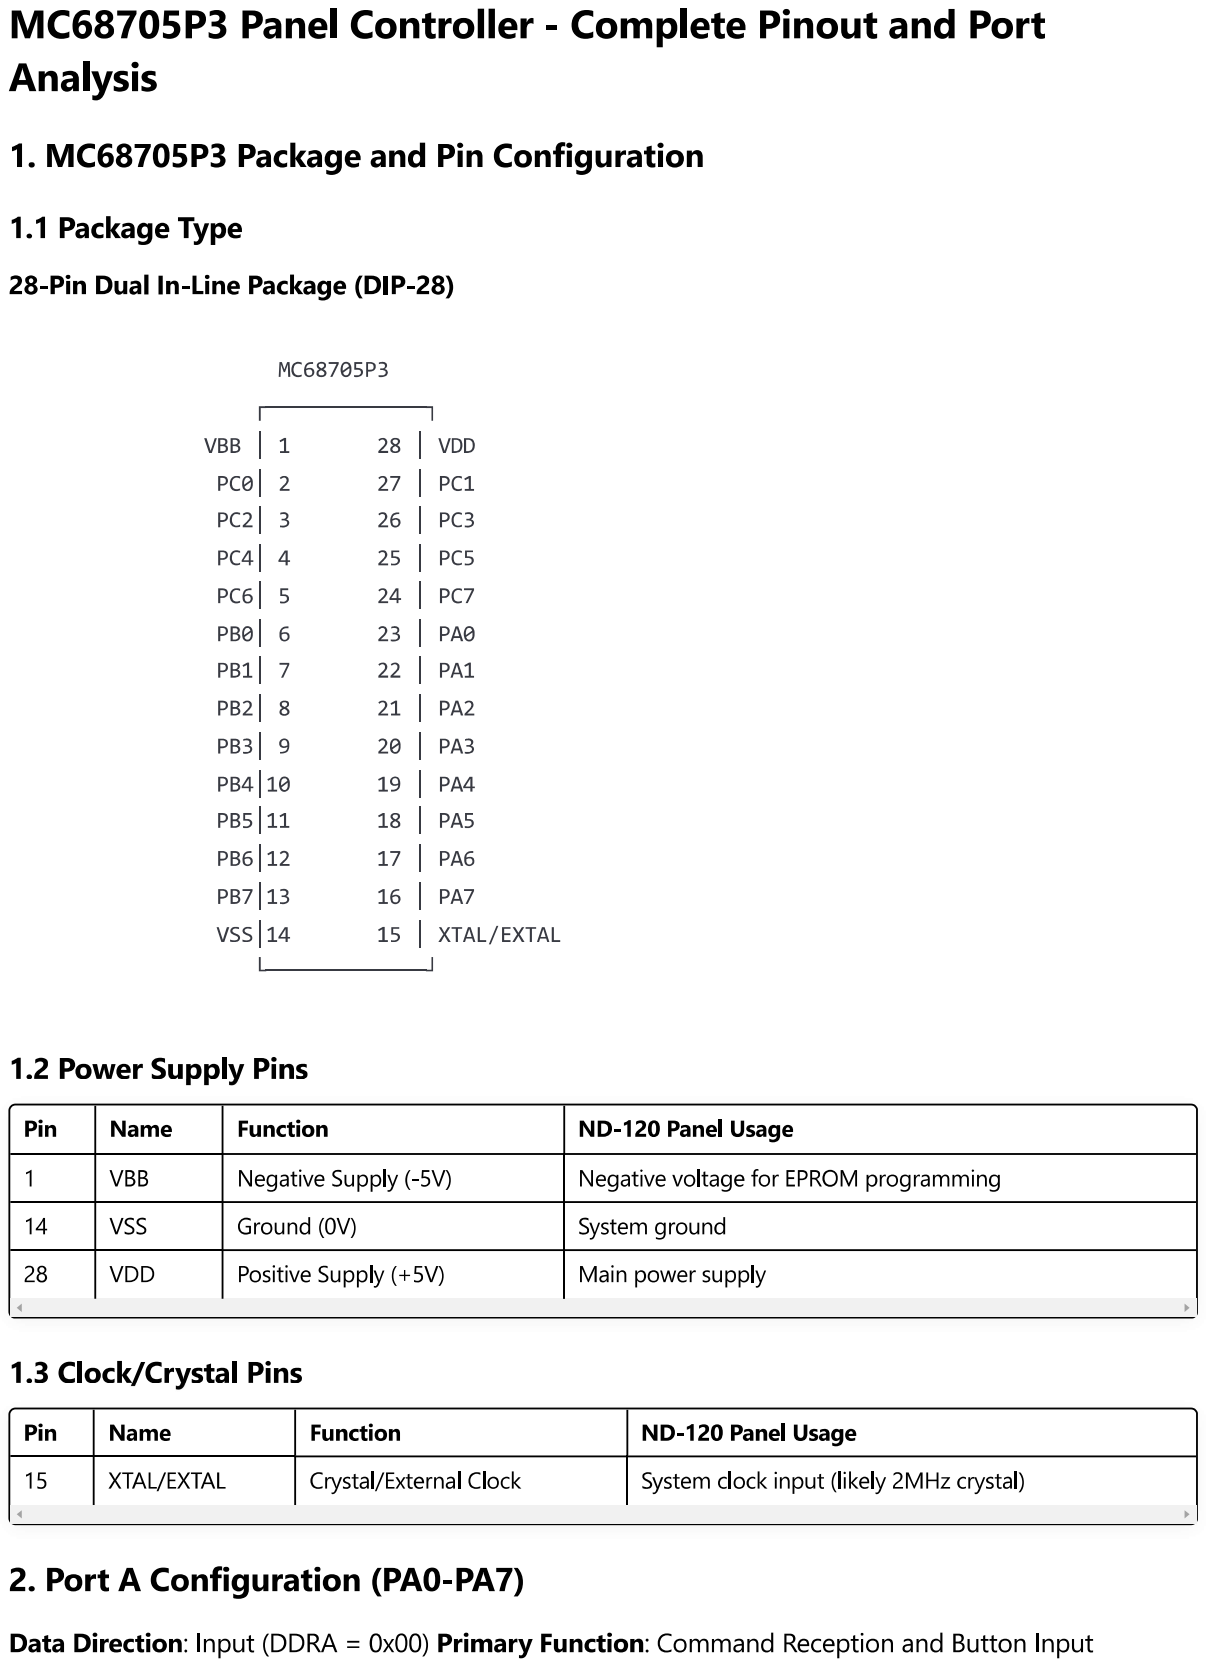
[picture p168: page 1]

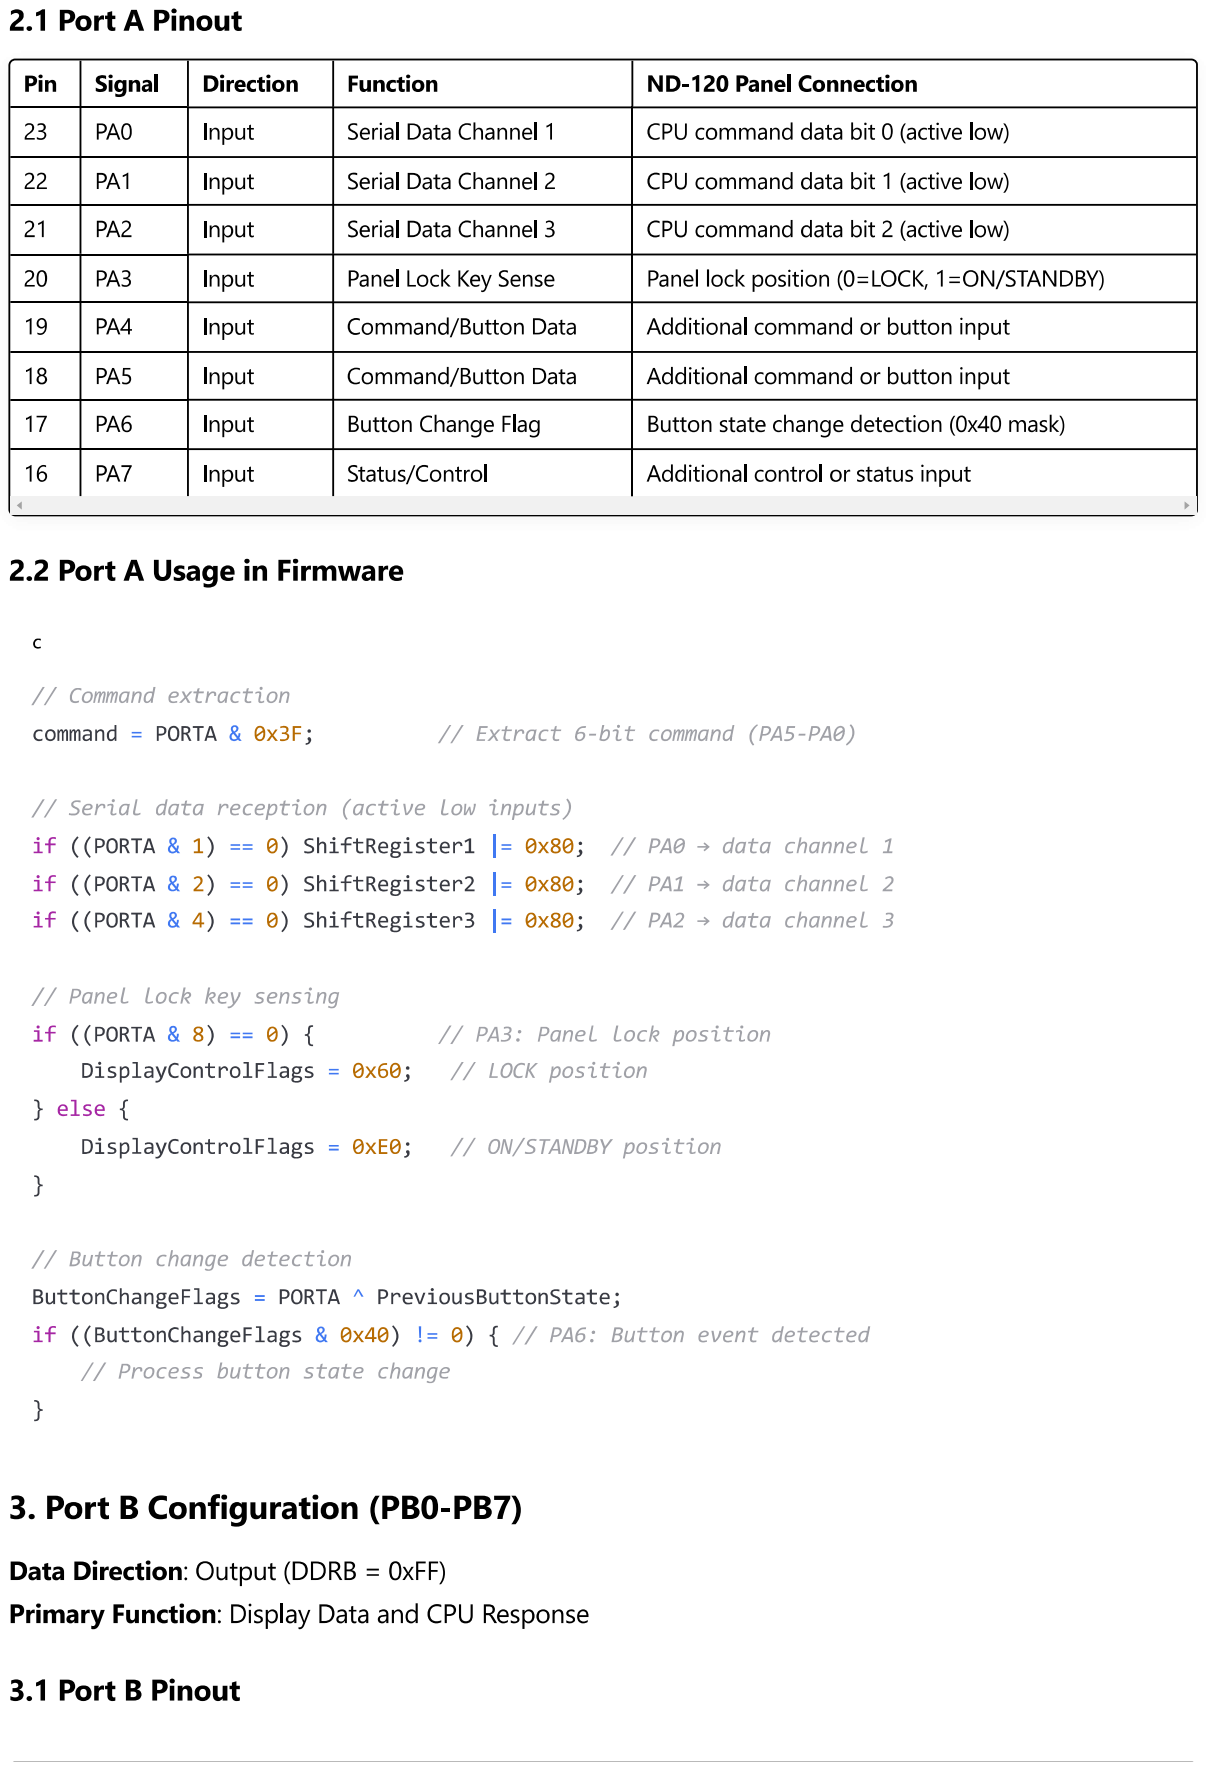
[picture p169: page 2]

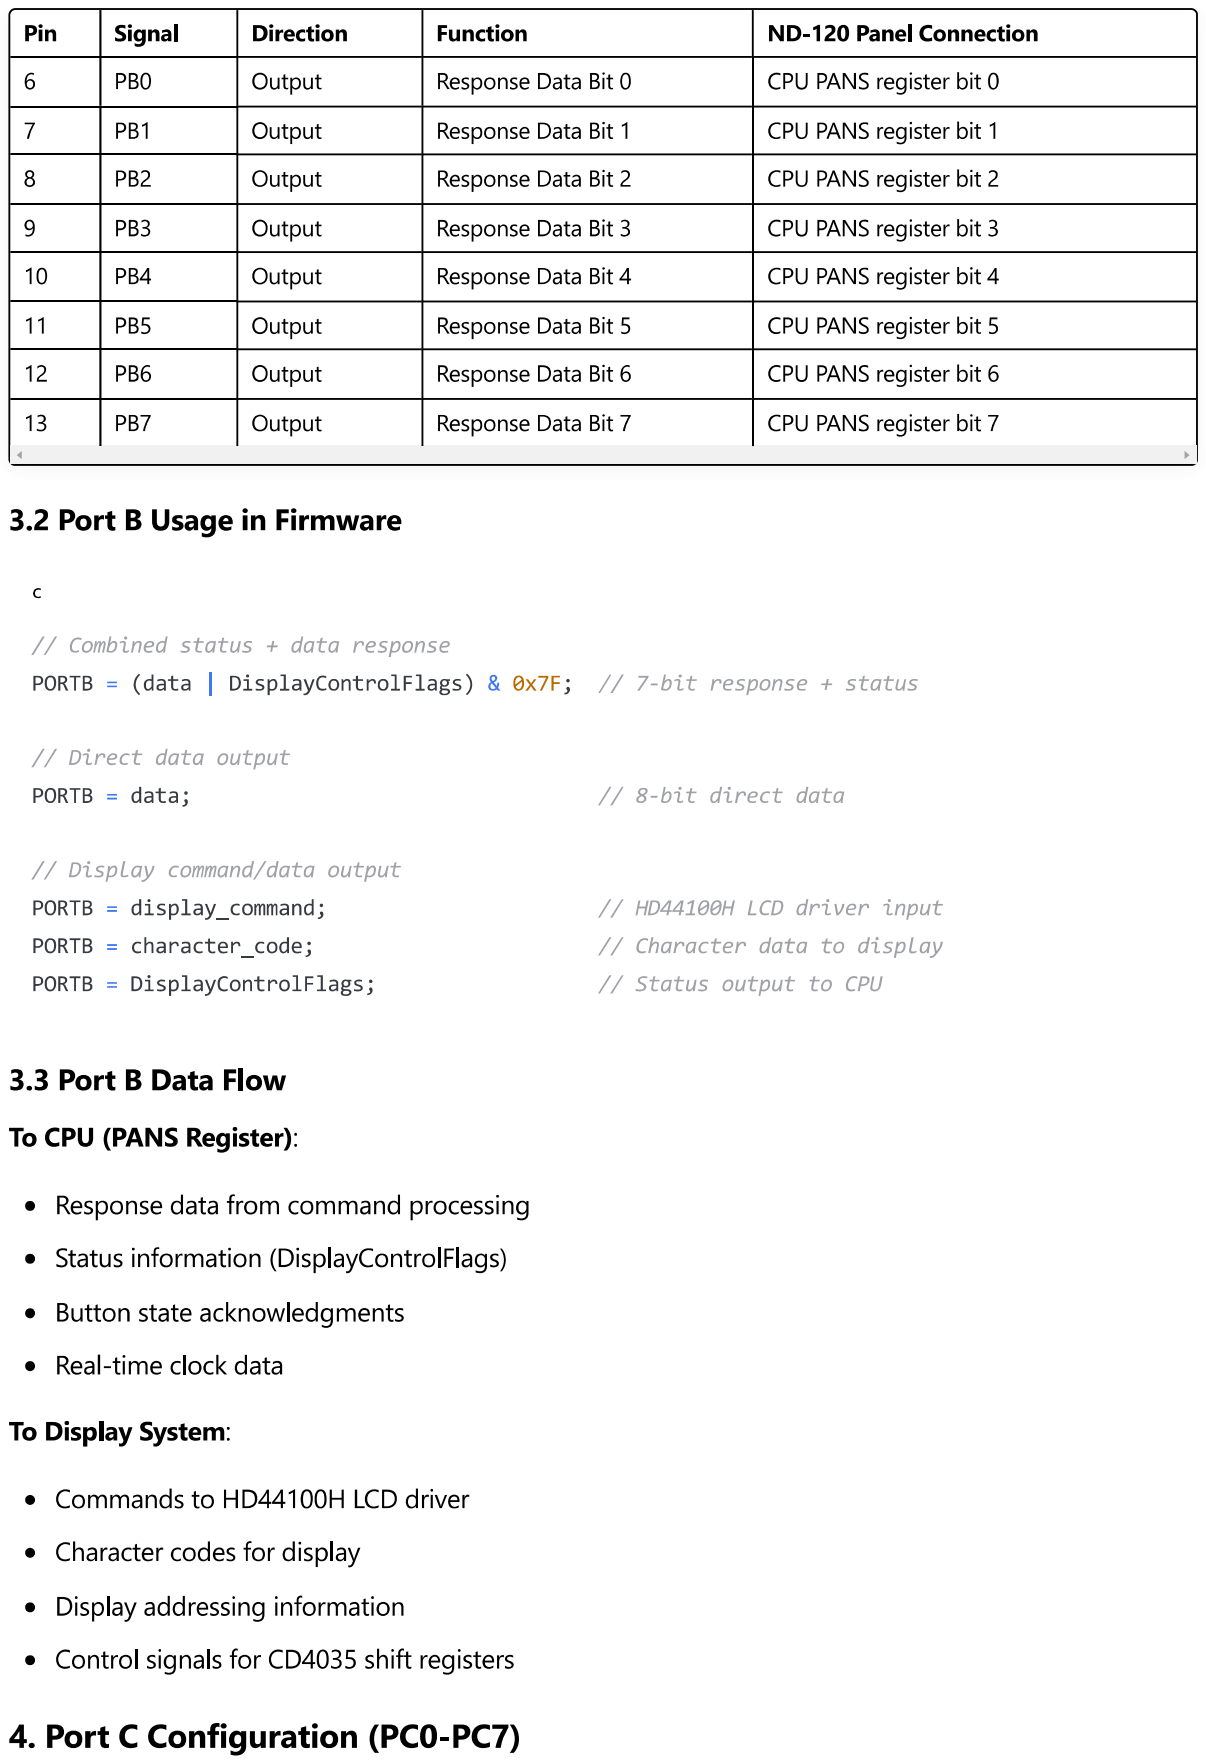
[picture p170: page 3]

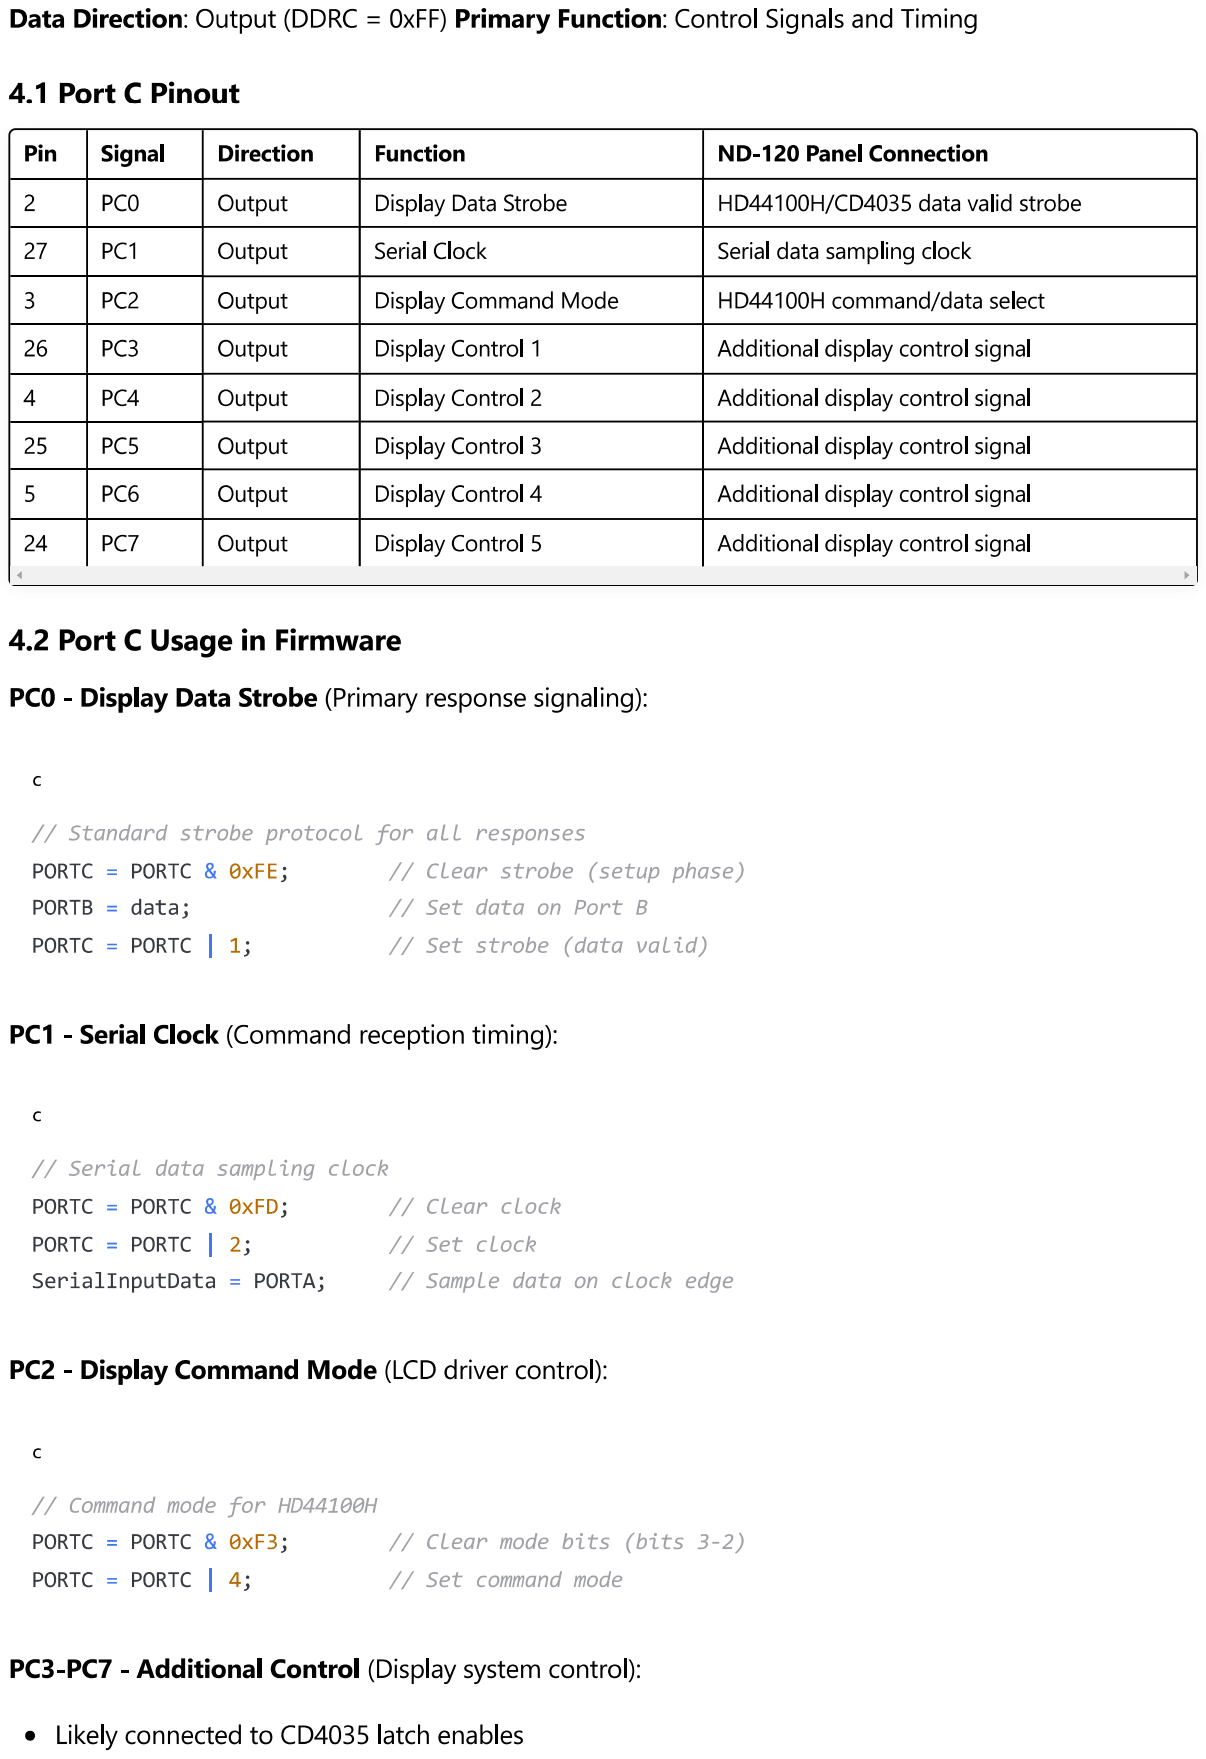
[picture p171: page 4]

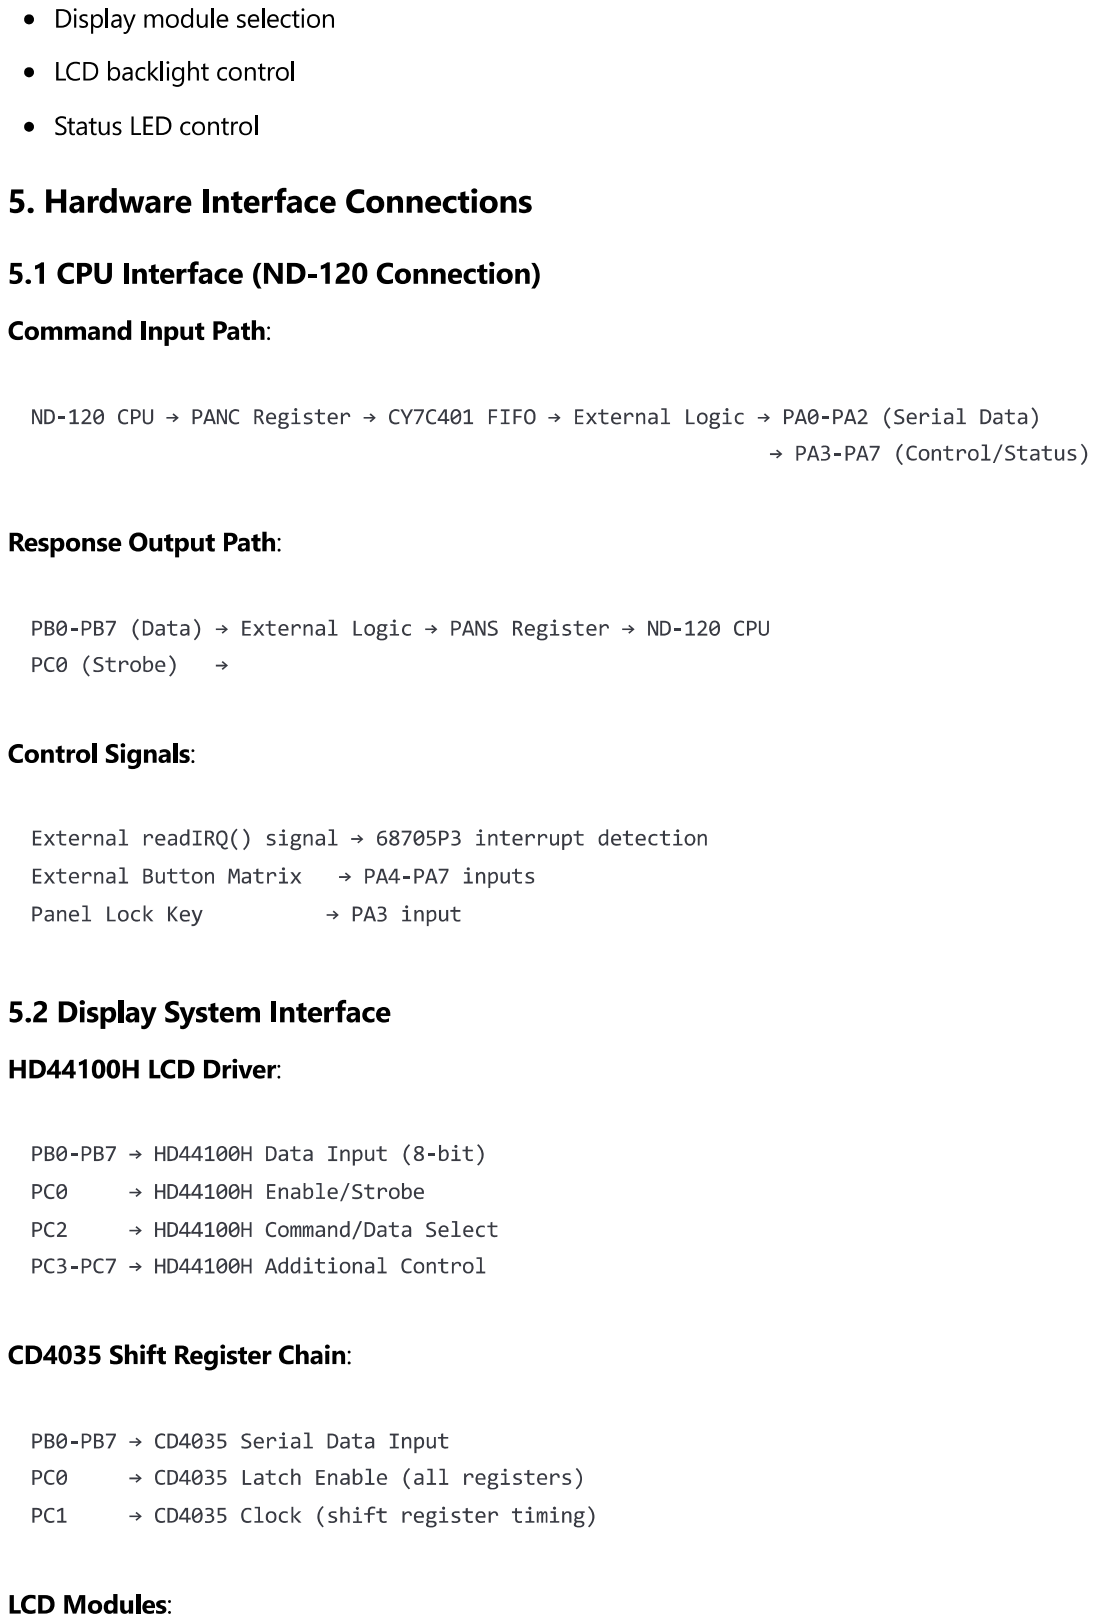
[picture p172: page 5]

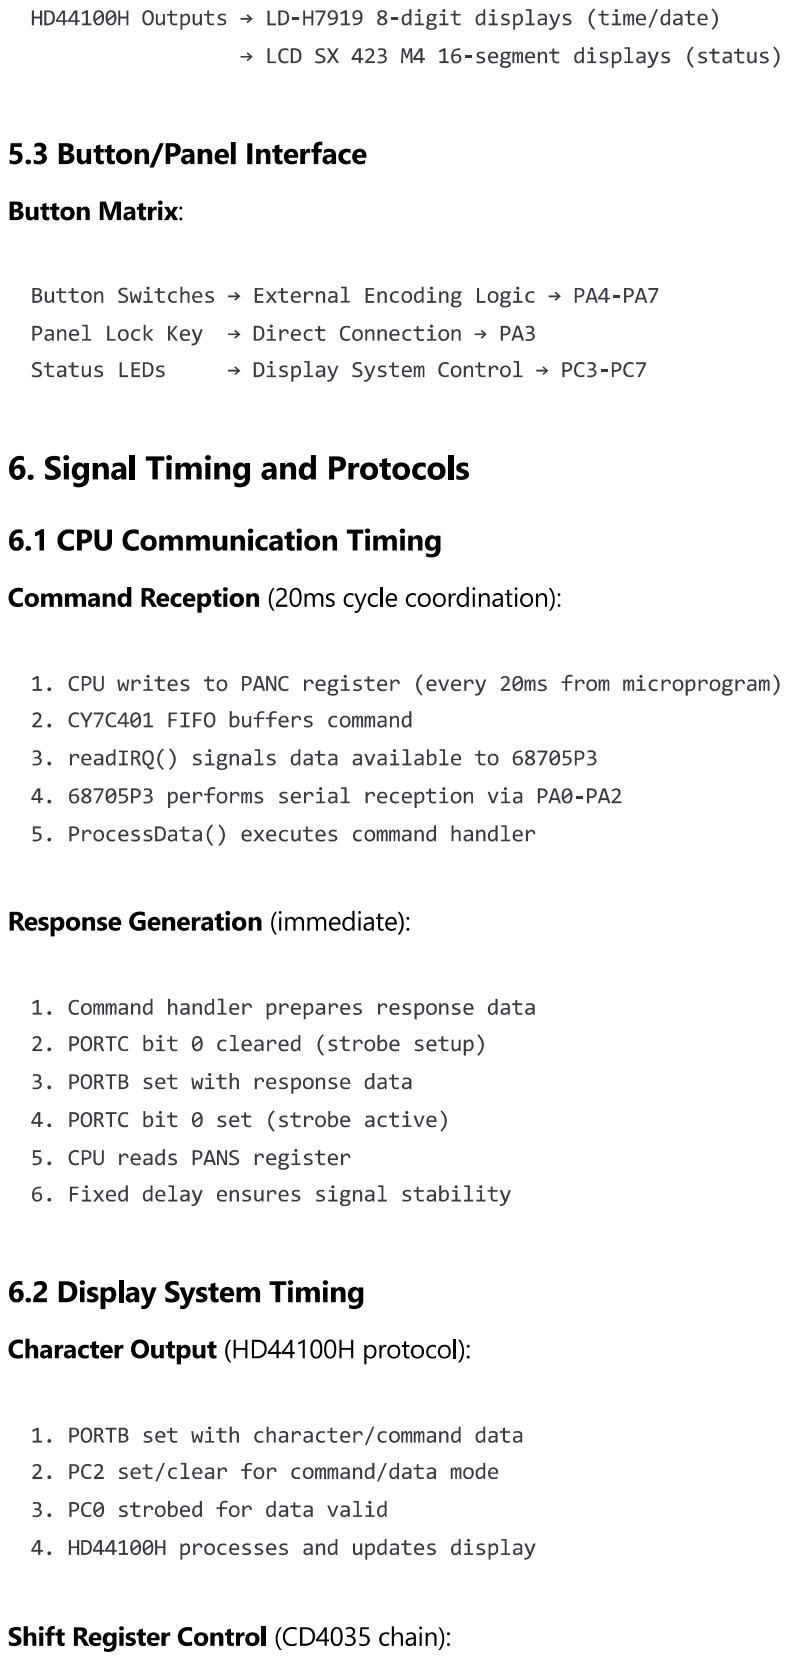
[picture p173: page 6]

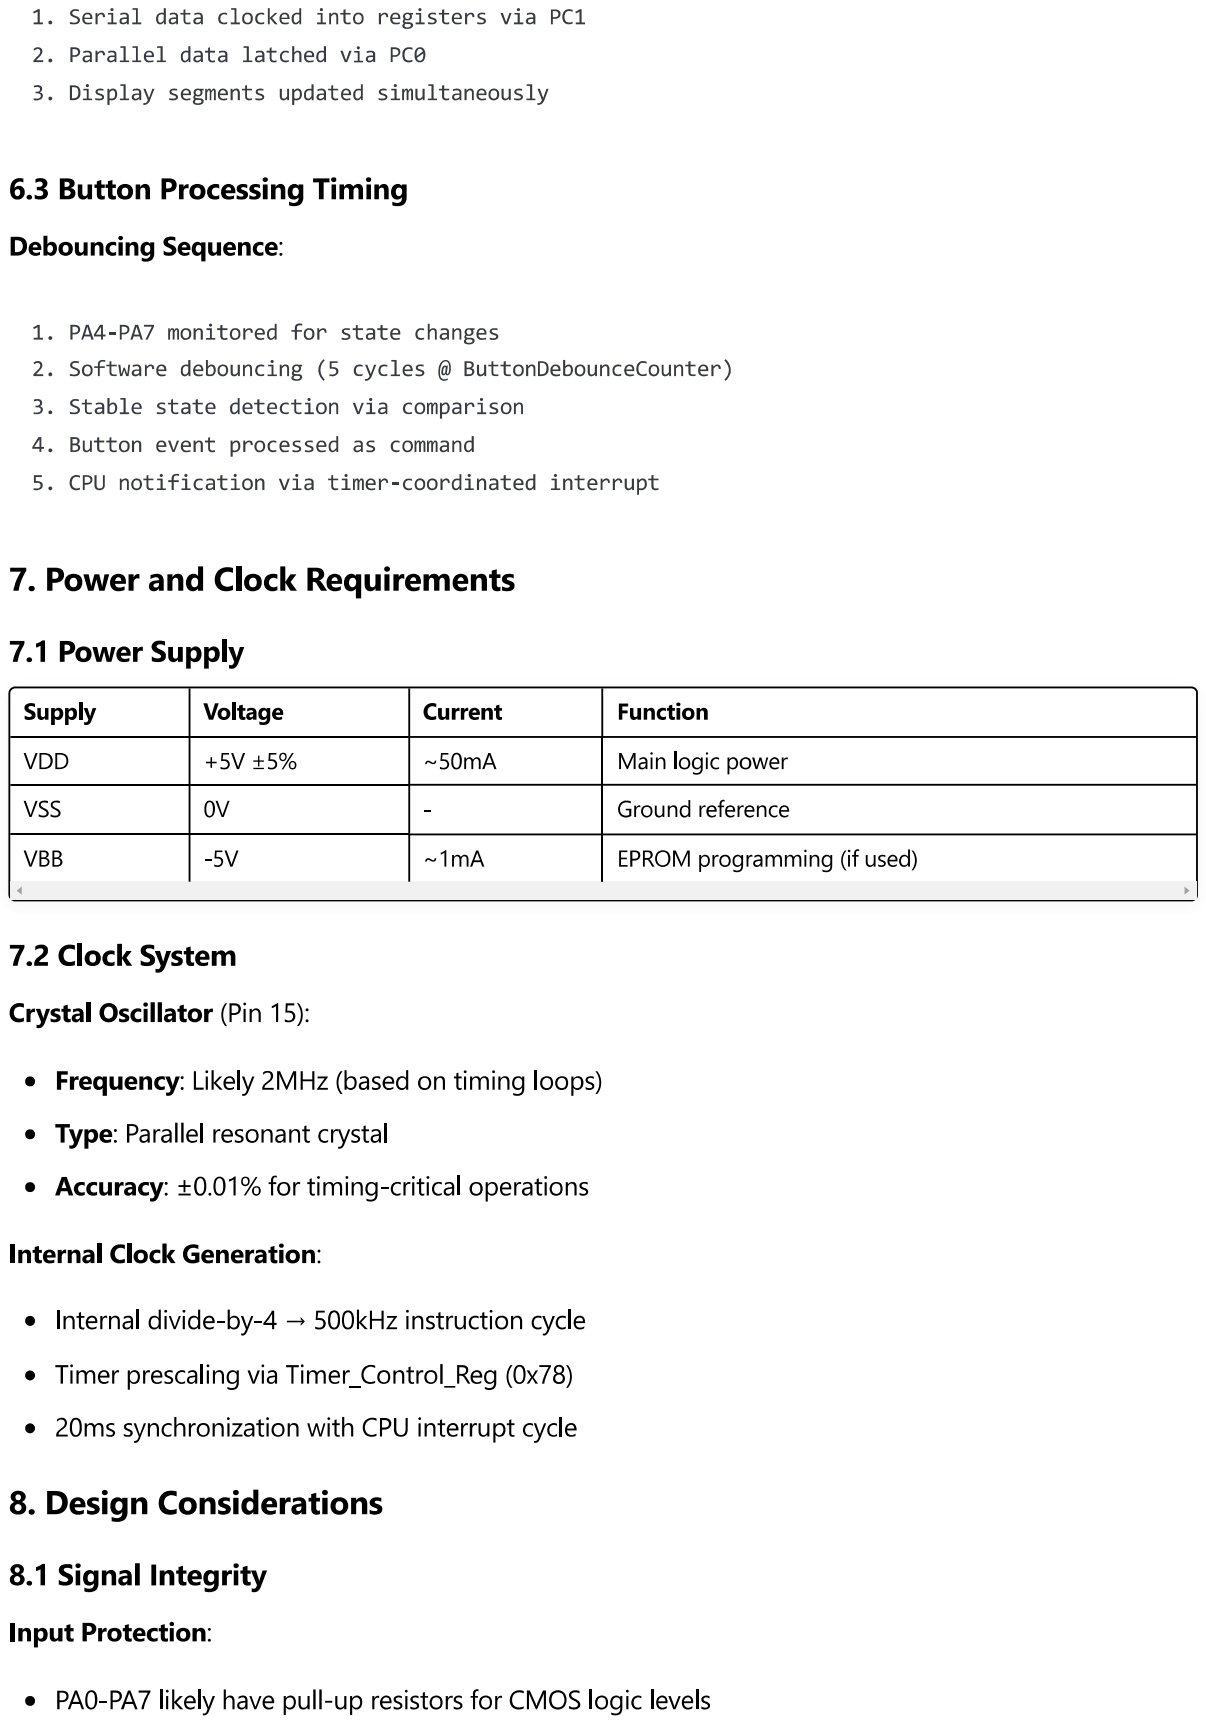
[picture p174: page 7]

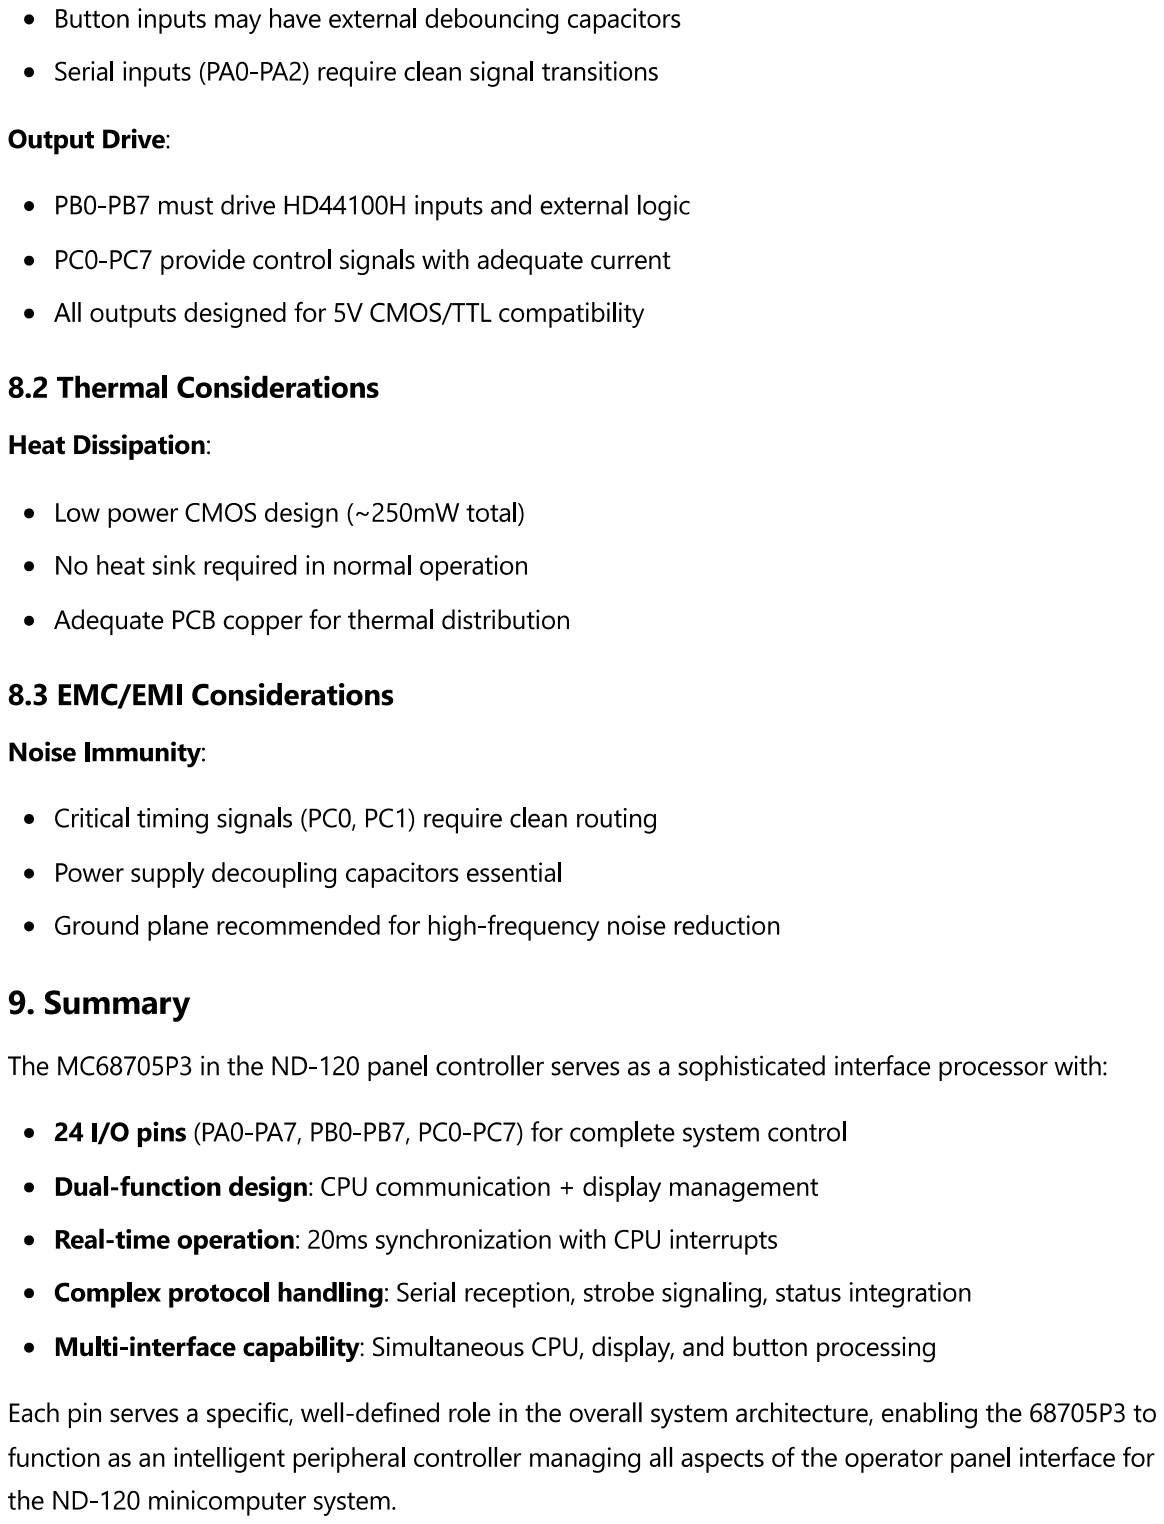
[picture p175: page 8]
