RonnyA/nd-120/(list of files, drawings)

Other design files:
Logisim/CGA/CGA.circ
Logisim/CPU-BOARD-3202/3202D.circ
Logisim/DECODE-GateArray/ND_DGA.circ
Logisim/DELILAH-CPU/CGA_ALU_.circ
Logisim/DELILAH-CPU/CGA_DCD_.circ
Logisim/DELILAH-CPU/CGA_HELPER.circ
Logisim/DELILAH-CPU/CGA_IDBCTL_.circ
Logisim/DELILAH-CPU/CGA_INTR_.circ
Logisim/DELILAH-CPU/CGA_MAC_.circ
Logisim/DELILAH-CPU/CGA_MIC_.circ
Logisim/DELILAH-CPU/CGA_TRAP_.circ
Logisim/DELILAH-CPU/CGA_WRF_.circ
Logisim/DELILAH-CPU/DELILAH.circ
Logisim/DELILAH-CPU/ND_LIB.circ
Logisim/DELILAH-CPU/TESTMUX_.circ
Logisim/ND-BUS-DEVICES/SMD-3044/SMD3044-MA-WC.circ
