RonnyA/nd-120/(commit log)

2023-08-21 Added Logisim files
    [CGA_ALU_.circ, CGA_DCD_.circ, CGA_HELPER.circ, CGA_IDBCTL_.circ, CGA_INTR_.circ, CGA_MAC_.circ, CGA_MIC_.circ, CGA_TRAP_.circ]
2023-10-29 Fixed component naming on PTYENC page 84
    [CGA_INTR_.circ]
2023-10-29 Adding some text on the CGA_ALU, and added test-document.
    [CGA_ALU_.circ]
2023-12-03 Minor adjustments for test of ALU
    [CGA_ALU_.circ]
2023-12-04 Bugfix ALU - The MUX21LP had negated output.. surprise surprise
    [CGA_ALU_.circ, DELILAH.circ, ND_LIB.circ]
2023-12-05 CGA ALU now works, test for ADD/SUBR/SUBS works. Modified: CGA_ALU_RALU_MUX216L.v - Added NOT gate on select CGA_CPU_ALU_CONTROLLER - Signal bug fix CGA_CPU_ALU_RALU - Signal bug fix
    [CGA_ALU_.circ]
2023-12-05 Added page for "MAC under test"
    [CGA_MAC_.circ]
2023-12-05 Added test_MIC page
    [CGA_MIC_.circ]
2023-12-06 Added page with test_IDBCTL
    [CGA_IDBCTL_.circ]
2023-12-06 added test_DCD
    [CGA_DCD_.circ]
2023-12-06 Merged all DELILAH circ files into one CGA.circ
    [CGA.circ]
2023-12-09 CGA_MIC * CSEL input IRQ is not connected to input signal IRQ..
    CGA_MIC_CONDREG
    * CSBIT7 output signal was connected to Q not QN.
    [CGA_MIC_.circ]
2023-12-09 CGA_MIC * CSEL input IRQ is not connected to input signal IRQ..
    CGA
    * XCSTS_6_3 input signal was hanging in the air
    * XCSRBSEL0 and XCSRBSEL1 combined to XCSRBSEL_1_0
    test_DCD
    * Extended with counters/tick to show all outputs based on CSCOMM_4_0 and CSMIS_1_0
    * Discovered that output signals are 2 clock ticks behind MCLK on rising edge
    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
    [CGA.circ]
2023-12-10 Finished drawing the DGA Circuit.
    [ND_DGA.circ]
2023-12-12 Output was VEX , not WEX_n. Fixed
    [PAL_44408B.v]
2023-12-16 Drawing CPU and MMU schematics page ~19-35
    [3202D.circ]
2023-12-19 Added Circuits * CS/CS Sheet 16 * CPU/CS/ACAL Sheet 17 * CPU/CS/CTL Sheet 18 * CPU/CS/TCV Sheet 20
    Added TTL chips
    * TTL 74373 - Octal Transparent Latch (3-State)
    * TTL 74374 - Octal D flip-flop (3-State)
    * TTL 74139 - Dual 2-to-4 line decoder/demultiplexer integrated circuit.
    * AM29841 - High Performance Bus Interface Latches
    [3202D.circ]
2023-12-19 PCB diagram of Panel
2023-12-20 Continue work on the 3202D CPU board Page 12 - LBD CONTROL (Complete. Need PAL in Verilog) Page 13 - BIF PES & PEA (Complete)
    Page 37 - IO TOP LEVEL (Partially - finish in Verilog)
    Page 38 - IO DECODING (Partially - finish in Verilog)
    Page 39 - DECODE GATE ARRAY (Partially - finish in Verilog)
    Page 40 - PANEL PROC & CALENDAR (Partially - finish in Verilog)
    Page 41 - IOC, ALD & INR REGS (Complete)
    Page 42 - UART AND IOR REG (Complete. UART must be made in Verilog)
    New TTL
    * 74393 - Dual 4-Stage Binary Ripple Counter
    * 74534 - OCTAL D-TYPE EDGE-TRIGGERED FLIP-FLOPS (3 state) Negated
    [3202D.circ]
2023-12-21 Page 5 - BIF (Complete) Page 6 - BIF CONTROL (Complete, Needs 3x PAL) Page 7 - BIF CONTROL (Complete) Page 8 - BIF SYNC (Complete) Page 9 - BIF DATA PATH (Complete) Page 10 - BIF BD TO LDB (Complete)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
    Page 47 - LOCAL PES & PEA (Complete. 1x PAL)
    Page 48 - LOCAL BD CONTROL (Complete. 1x PAL. Some signals needs manual connections in Verilog)
    Page 49 - LOCAL RAM (complete. Need Memory Chip SIP1M9)
    Page 50 - LOCAL RAM CONTROL (complete, needs 2x PAL)
    * 74646 - OCTAL BUS TRANSCEIVERS AND REGISTERS WITH 3-STATE OUTPUTS
    * 74648 - CTAL BUS TRANSCEIVERS AND REGISTERS WITH 3-STATE OUTPUTS (Inverting/Negated)
    Fixed
    * AM29C821
    TODO:
    * RAM: SIP1M9 (used on pag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
    [3202D.circ]
2023-12-24 Bugfix: CGA_ALU, type in vire connector. CD_10_9 (not CS_10_9)
    [CGA.circ]
2023-12-24 Verilog code generation now works
    [3202D.circ]
2023-12-24 Fixed typo: CD_10_9 (not CS_10_9) in tunnel
    [CGA_ALU_.circ]
2023-12-24 Fixed integration between CGA_MIC and CGA_MASEL signal CSBITS_11_0
    CGA_MAC - Renamed output signal 'PCR_15_7_2_0' to 'PCR_15_0'
    CGA - Fixed the missing signals PCR_1_0
    [CGA.circ, CGA_MIC_.circ, DELILAH.circ]
2023-12-25 Bugfix: CGA - Renamed signal PT_9_15 to the correct PT_15_9 (s_logisimBus17)
    CGA_WRF - forgot to name output signal EA_15_0
    CGA - Connected signal EA_15_0 to ALU (s_logisimBus16)
    CGA - Tunnel CSCOMM_4_0 was not connected at source (s_logisimBus224)
    CGA -> CGA_IDBCTL LA_21_10 - Missing splitter for LA_21_10 (had signal LA_23_10)
    CGA -> CGA_MIC PIL_3_0 not connected
    CGA_ALU - Renamed PIL output signal to PIL_3_0
    [CGA.circ, CGA_WRF_.circ, DELILAH.circ]
2023-12-25 Rewired signals W_12_0 as they where reversed.
    [CGA.circ, CGA_MIC_.circ]
2023-12-25 PFIFD - Fixed spelling error on tunnel WEU12 (fixed connection) DGA - Renamed XDBN to XBDN (typo)
    [ND_DGA.circ]
2023-12-26 Added comment
    [ND_DGA.circ]
2023-12-26 Logisim drawings of 3202D complete. Continue from now in Verilog.
    [3202D.circ]
2023-12-27 Added Verilog files for 3202D PCB
    [3202D.circ]
2024-01-04 Changed IO_REG_41 with hard-coded values for PCB info
    [3202D.circ]
2024-01-06 QA on verilog code. Fixed circular reference
    [PAL_44302B.v]
2024-01-06 QA on 44303B and fix recursive logic
    [PAL_44303B.v]
2024-01-06 Fixed "circular logic" in PAL 44401B signal DAP
    [PAL_44401B.v]
2024-01-06 Fixed self-reference in 44310D and verified with test
    [PAL_44310D.v]
2024-01-06 added some text
    [3202D.circ]
2024-01-06 Fixed self-reference in 44304E. Added test.
    [PAL_44304E.v]
2024-01-07 QA on PALASM for PAL 44402D, Created Verilog and testcode
    [3202D.circ]
2024-01-07 Added text to describe decoding of RT_n signal
    [ND_DGA.circ]
2024-01-13 Updated sheet 36 with info on PAL signals fixed in verilog
    [3202D.circ]
2024-01-13 Marked Verilog connection as fixed
    [3202D.circ]
2024-01-14 Updating CPU board make files
2024-01-15 Integrated CGA into CPU_PROC_33
    [3202D.circ, CGA.circ]
2024-01-17 red color
    [3202D.circ]
2024-01-17 text pos change
    [ND_DGA.circ]
2024-01-17 Integrated DGA into 3202D PCB. Updated some signals on the DGA side also (typos)
2024-01-17 Fixed signal going to GND whan it should to to POWER
    [3202D.circ]
2024-01-17 All Verilog for IO is now connected. Needs more test, and the UART + PANEL CONTROLLER LOGIC
2024-02-10 Bugfix: Output is 3-state (bz) not zero ('b0) when WCA_n = true
    [CPU_MMU_WCA_31.v]
2024-02-11 Modifications to try to get bi-directional data to flow.
2024-04-13 Finished CPU_PROC_32 Verilog and added some tiny testcode
    [CGA.circ]
2024-04-13 A newer Schematics for the CPU board 3202, revision N.
2024-04-14 Added sample microcode bits captured from c# ND-120 emulator runs
2024-04-14 Finished verilog CPU_CS_CTL_18
    [3202D.circ]
2024-04-18 Fixed template to be "correct" and not mess with syntesis
    [PAL18L8.v]
2024-04-21 Bugfix: DOUBLE signal was negated
    [PAL_44306A.v]
2024-04-21 Added back pin RT_n (Q5_n)
2024-04-21 Fixed typo in comment
    [PAL_44803A.v]
2024-04-23 QA and bugfix on Cycle Control and a PAL controlling LCS_n
    [PAL_44403C.v]
2024-04-23 Minor text changes
    [3202D.circ]
2024-04-25 Implemented SC2661 UART and added testcode
2024-05-11 Added parantesis to make sure the logic is correct
    [PAL_44408B.v]
2024-05-11 Added new input signal "POWSENSE_n" (that comes from the powersupply)
2024-05-12 Minor adjustments to the layout
    [3202D.circ, ND_DGA.circ]
2024-05-12 Added FPGA signals (sysclk, sys_rst_n), refactored wire names and cleaned up
2024-05-13 Manually cleaned up from logisim generator that creates wires not used..
2024-05-13 Bugfix: WAIT2 should be WAIT2_n (negated signal)
    [PAL_44601B.v]
2024-05-13 Flipped priority to Reset (in case of both re-set and set signal applied)
2024-05-15 Refactored wire-names
2024-05-15 Refactored wire-names and connection to CHIP_3A
2024-05-15 Refactored wire names and or-ed together bus signals.
2024-05-15 Refactored wire-signal names
2024-05-15 Bugfix: CHIP_5A must use BD[15:8] out
    [BIF_DPATH_BDLBD_10.v]
2024-05-15 Typo: missing wire names
    [BIF_DPATH_CDLBD_11.v]
2024-05-15 bugfix: removed input signal that shouldnt be there
    [ND_DGA.circ]
2024-05-15 Bugfix: renamed signal CGNCACT_n to the correct CGNTCACT_n
    [3202D.circ]
2024-05-15 Refactor some wire-signal names
2024-05-15 Some bugfixes and some comments added
    [ND3202D.v]
2024-05-18 Refactored wire-name signals and removed unused wires
2024-05-20 Bugfix: Need to or parity-signals together.
    [MEM_RAM_49.v]
2024-05-20 Refactor wire-signal names and general QA
2024-05-20 Added some text + named some gates
    [ND_DGA.circ]
2024-05-20 Refactor wire-signal names and clean up code
2024-11-09 refactored signal names (s_bint1x_n) to lower case
2024-11-09 Design document for PCB 3202 later than Rev D
2024-11-11 Array fix to make Vivado happy
    [CPU_CS_PROM_19.v]
2024-11-11 Added TODO: need to connect some wires
2024-11-13 internal signal names refactored with s_ names matching signals
    [CGA.circ]
2024-11-15 Bugfix: rom_hi size (accidential removed one digit of size?)
    [CPU_CS_PROM_19.v]
2024-11-16 Minor refactor. Bugfix: assign values to cs_IDB_in.
    [CPU_15.v]
2024-11-16 Bugfix: changed how IDB_out bits was set.
    [CPU_CS_TCV_20.v]
2024-11-16 Bugfix: Automatic reset signal (after power on) was inverted. Also reduced time reset signal is active.
    [IO_DCD_38.v]
2024-11-16 Bugfix: Select signal to TESTMUX is 3 bit (not 2)
    [ND120_TOP.v]
2024-11-17 Bugfix: Missing input signal to "s_lua12 "
    [ND3202D.v]
2024-11-17 Bugfix in drawings found in Veilog and backported
    [CGA.circ]
2024-11-17 Bgfix: backported bugs found in verilog qa
    [ND_DGA.circ]
2024-11-24 Bugfix: TRAP vs TRAP_n signal mismatch
    [CPU_15.v, CPU_PROC_32.v]
2024-11-24 Bugfix: CSBITS only out from WCS
    [CPU_CS_16.v]
2024-11-24 Bugfixes from Verilog backported
    [CGA_MIC_.circ, DELILAH.circ]
2024-11-24 Bugfix: ZF and CRY signals was mixed up.
    [DELILAH.circ]
2024-12-02 Refactor Chip34F/35F Registerbloc directly to BlockRam. Fix IDB bus signals
    [CPU_PROC_32.v]
2024-12-02 Forward sysclk/sys_srt_n t UART
2024-12-02 Bugfix: Signal QD_n to PAL_45008_UDATA
    [MEM_DATA_46.v]
2024-12-02 Bugfix: Wires was mapped wrongly
2024-12-02 Bugfixes backported to Logisim files
    [CGA_INTR_.circ, CGA_TRAP_.circ]
2024-12-02 Bugfixes backported. New test logic
    [CGA_DCD_.circ]
2024-12-02 Bugfixes backported
    [DELILAH.circ, ND_LIB.circ]
2024-12-02 Added documentation for SCN2661 UART
2024-12-02 Added Gowin project for TANG Nano FPGA board
2024-12-02 Updated comment that was wrong (QD != PD3)
    [PAL_45008B.v]
2024-12-03 Added comment and renamed wire for clarity
2024-12-03 Backported A201 bugfix to drawing
    [ND_DGA.circ]
2024-12-07 Bugfix: Pull some signals high when z
    [BIF_BCTL_BDRV_7.v]
2024-12-07 Bigfix in CC0_reg: Symbol "*" was wrong for AND, should be "&"
    [PAL_44601B.v]
2024-12-07 Bugfix: MUX 3-to-1 has 4 potential chices. Changed output for 4 to be equal to input 3 instead of GND.
2024-12-07 Backported bugfixes
    [3202D.circ, CGA_MAC_.circ, CGA_MIC_.circ, ND_DGA.circ]
2024-12-07 Bugfix: If chip enabled and direction is B to A, read from chip. Else set HIGH (negated 0)
    [BIF_DPATH_BDLBD_10.v]
2024-12-07 Patched microcode address 002003 to disable waiting loop (millions of ticks during boot making it difficult to debug)
2024-12-14 Bugfix: Connected ECREQ signal correct. Refactored and added comments
    [BIF_5.v]
2024-12-14 bugfix: cbwrite and wlbd signals was mixed
    [BIF_DPATH_LDBCTL_12.v]
2024-12-14 Connect missing signals: MREQ,IONI, RRF,ECCR. OR'ed bus signals IDB and CD with all busses
    [CPU_15.v]
2024-12-14 Fix: Renamed BGNT25 to BCGNT25. Added signal names in comments
    [MEM_RAMC_50.v]
2024-12-14 Bufix: A630 and A631 had RB to GND, should be to VCC. Added signal comments/descriptions.
2024-12-14 Bugfix: Signal wires was mixed up in drawing.
2024-12-14 Bugfix: Connected missing signals. Refactored and added comments and signal names
    [ND3202D.v]
2024-12-14 Bugfixes for CGA Add backportd
    [CGA_MAC_.circ]
2024-12-20 Added more comments and backported fixes
    [CGA.circ, CGA_MIC_.circ]
2024-12-20 Bugfix RT signal: Use incomming RT_n signal (DONT use signal out from PROC as we are missing the latest PALASM code for the latest PAL) Bugfix MMU: Now inputs IDB and PPN bus signals.
    [CPU_15.v]
2024-12-20 Bugfix: IDB 7:0 output now correct in 3 state
    [IO_DCD_38.v]
2025-01-05 Removed unused wire's.
2025-01-05 Removed unused wires. Bugfix: connected PAL_45001B.TEST to PD3 (not to unused wire)
    [BIF_BCTL_6.v]
2025-01-05 Minor refactor: Clean up LBA and LAA wires
2025-01-05 Changed radixes for debugging/test
    [CGA_ALU_.circ, CGA_MIC_.circ]
2025-01-19 Refactor CPU_15.v: Enhanced signal descriptions and corrected variable names for clarity. Updated output connections and added new wire for CPU PPN output. Improved code readability with consistent f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
    [CPU_15.v]
2025-01-19 Enhance signal descriptions in CPU_MMU_PT_29.v: Updated comments for input and output signals to clarify their roles in the physical address calculation. Refactored instance naming for better readabi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
    [CPU_MMU_PT_29.v]
2025-01-19 Refactor CPU_MMU_PTIDB_30.v: Replace reg with wire for OE_n and DIR signals. Fixing the signals.
    [CPU_MMU_PTIDB_30.v]
2025-01-19 Bugfixes and debugging changes (values and hex/bin/oct)
    [3202D.circ, CGA_ALU_.circ, CGA_DCD_.circ, CGA_INTR_.circ, CGA_MAC_.circ, CGA_MIC_.circ, CGA_TRAP_.circ, CGA_WRF_.circ]
2025-02-01 Bugfix: LBD bits 23-19 was lost
    [BIF_DPATH_9.v]
2025-02-01 Fixed parity signals to correct bits
    [MEM_RAM_49.v]
2025-03-21 Adding support for IO devices connected to ND BUS
2025-03-24 Added LED to drawing
    [3202D.circ]
2025-03-24 Bugfix: Added signal MIS (clocked CSMIS)
    [IO_37.v]
2025-03-24 Minor: Added a new signal for LED5
2025-03-24 Updated history information - support for ND IO Devices
2025-06-03 Refactor documentation and code organization for MC68705 and ND-5000C
    - Updated readme.md for MC68705 to include analysis of functionality and commands.
    - Corrected paths for disassembly and C code references in MC68705 documentation.
    - Renamed MC68705-R3 to MC68705-P3 for consistency and updated related links.
    - Enhanced documentation for CPU-BOARD-3202, specifying implementation details for RAM components.
    - Improved comments in Verilog file BIF_5.v for clarity on signal descriptions.
    [BIF_5.v]
2025-06-22 Fix BIF signal processing and update documentation for memory cycle handling
    [NDBus.cpp]
2025-06-22 Fix comments for MOR25_n and MOR_n signals in BIF_5 module for accuracy
    [BIF_5.v]
2025-06-22 Fixed som layout issues
    [3202D.circ, CGA_ALU_.circ, CGA_MIC_.circ]
2025-11-07 Add comprehensive Vivado synthesis fix plan
    Addresses critical synthesis failure and 125+ warnings from Vivado 2024.1.1
    CRITICAL ERROR IDENTIFIED:
    - Design requires 3496 RAMB18 blocks (7MB RAM)
    - xc7a35t device only has 100 RAMB18 blocks
    - Synthesis cannot complete
    ROOT CAUSE:
    The ND-120 design includes 6x 1MB onboard RAM chips that are being
    inferred as FPGA BRAM. This is 35x more than device capacity.
    IMMEDIATE FIX (Phase 0):
    - Reduce memory size from 4MB to 4KB for testing
    - Enables synthesis to complete
    - Timeline: 1-2 days
    LONG-TERM FIX (Phase 4):
    - Implement external memory interface
    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
2025-11-07 Fix critical Vivado synthesis errors (Phase 0 + Phase 2)
    This commit implements fixes from VIVADO_FIX_PLAN.md to resolve the
    critical synthesis failure and multiple high-priority warnings.
    CRITICAL FIX - Phase 0: RAM Capacity (ERROR 8-5834)
    =================================================
    The design required 3496 RAMB18 blocks (6MB RAM) but xc7a35t only has
    100 blocks. This made synthesis impossible.
    ✅ SIP1M9.v:
    - Added ramSize=3 option for 4KB memory (4095 words)
    - Updated comments to document options: 0=disabled, 1=64KB, 2=1MB, 3=4KB
    ✅ MEM_RAM_49.v:
    - Changed ramSize from 2 (1MB×6=6MB) to 3 (4KB×6=24KB)
    - Total RAM: 24KB fits easily in FPGA BRAM (~12 RAMB18 blocks)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
    [MEM_RAM_49.v, ND120_TOP.v, PAL_45008B.v]
2025-11-07 Phase 1: Convert latches to edge-triggered flip-flops for FPGA synthesis
    Converted all latch implementations to edge-triggered flip-flops to eliminate
    Vivado synthesis warnings and improve FPGA compatibility. This addresses 66
    latch inference warnings (Vivado WARNING 8-327).
    Changes made:
    1. TTL Components:
    - TTL_74374: Verified existing edge-triggered implementation (already correct)
    - AM29841 (10-bit bus latch): Added FPGA_MODE parameter (default=1 for FF mode)
    - LATCH module: Added FPGA_MODE parameter (default=1 for FF mode)
    2. PAL Conversions (added CK clock inputs):
    - PAL_44401B: Converted DAP signal latch to edge-triggered (PAL16R4D)
    - PAL_44310D: Converted BDRY signa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
    [BIF_5.v, BIF_BCTL_6.v, BIF_DPATH_9.v, BIF_DPATH_LDBCTL_12.v, CPU_CS_ACAL_17.v, MEM_43.v, MEM_ERROR_47.v, MEM_LBDIF_48.v]
2025-11-07 Fix Vivado synthesis warnings: eliminate latches and combinatorial loops
    This commit addresses critical Vivado synthesis warnings:
    1. Fixed combinatorial loops in PAL_44304E:
    - Converted BACT_reg and EBADR_n_reg from combinatorial to edge-triggered flip-flops
    - Added clock input (CK) and proper reset logic
    2. Fixed latch inferences by converting to edge-triggered or complete assignments:
    - PAL_45008B: Converted DISB_reg and TST_reg latches to flip-flops
    - BusDriver16: Added complete signal assignments with blocking assignments
    - CGA_MIC_MASEL: Added else clause for regW to prevent latch inference
    - CPU_CS_TCV_20: Added default initialization for regCSBITS
    - F595: Conve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
    [BIF_DPATH_LDBCTL_12.v, BusDriver16.v, CPU_CS_TCV_20.v, MEM_43.v, MEM_DATA_46.v, PAL_44304E.v, PAL_45008B.v]
2025-11-07 Add comprehensive testbenches for Vivado warning fixes
    Created unit testbenches to verify all modules modified for Vivado warnings:
    Testbenches created:
    - PAL_44304E_tb.v: Tests combinatorial loop to flip-flop conversion
    - PAL_45008B_tb.v: Tests latch to flip-flop conversion
    - BusDriver16_tb.v: Tests latch fix with blocking assignments
    - CGA_MIC_MASEL_tb.v: Tests latch fix and 13-bit signal assignment
    - CPU_CS_TCV_20_tb.v: Tests latch fix with default initialization
    - F595_tb.v: Tests gated latch to edge-triggered flip-flop conversion
    Test infrastructure:
    - Makefile: Compile and run all tests with iverilog
    - run_tests.sh: Convenience script to run full test suite
    - README.md: Comprehensive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
    [BusDriver16_tb.v, PAL_44304E_tb.v, PAL_45008B_tb.v]
2025-11-07 Fix C++ compilation errors in NDDevices.cpp
    Fixed pointer comparison errors for modern C++ compilers:
    - Line 66: Changed papertapeFile > 0 to papertapeFile != NULL
    - Line 81: Changed papertapeFile > 0 to papertapeFile != NULL
    - Line 613: Changed floppyFile < 0 to floppyFile == NULL
    Modern C++ compilers don't allow ordered comparison (<, >) of pointers
    with integer zero. Changed to proper NULL pointer checks.
    This fixes compilation errors when building with newer gcc/clang versions.
    [NDDevices.cpp]
2025-11-07 Reduce I/O pin count for xc7a35tcpg236 FPGA compatibility
    Commented out debug signals to fit design in xc7a35tcpg236 (106-pin package):
    - CSA_12_0[12:0]: Microcode address debug output (13 pins saved)
    - BD_23_0_n_OUT[23:0]: Bus data/address output (24 pins saved)
    Total pins saved: 37
    These signals can be re-enabled when using larger FPGA packages like:
    - xc7a35tcsg324 (210 pins)
    - xc7a50tcsg324 (210 pins)
    - xc7a100tcsg324 (210 pins)
    For internal debugging, use Vivado ILA (Integrated Logic Analyzer) to
    probe these signals without consuming physical pins.
2025-11-07 Revert "Reduce I/O pin count for xc7a35tcpg236 FPGA compatibility"
    This reverts commit 10da6df99cc712cf0f2f60aa73a4bf8a6ad1996e.
    [ND120_TOP.v]
2025-11-07 Add minimal XDC constraints for xc7a35tcpg236 FPGA
    Created constraint files to handle limited pin count:
    - constraints_minimal_cpg236.xdc: Maps only essential pins (clock, UART, LEDs, buttons)
    - constraints_tie_unused.xdc: Ties unused inputs and marks debug signals for ILA
    Debug signals (CSA_12_0, BD_23_0_n_OUT) remain in design for simulation
    but aren't mapped to physical pins. Use Vivado ILA to probe them internally.
    Alternative: Upgrade to xc7a35tcsg324 package for 210 pins.
2026-03-28 Add VERILATOR_SIM ifdef guards for dual-mode latch/FF operation
    All modules converted from latches to flip-flops now have ifdef
    VERILATOR_SIM guards: simulation uses transparent latches (original
    hardware behavior), FPGA synthesis uses edge-triggered flip-flops.
    Affected modules:
    - LATCH.v, AM29841.v: FPGA_MODE parameter defaults to 0 (latch) in sim
    - F595.v: R-S latch vs posedge FF
    - PAL_44302B/03B/04E/10D/01B/08B/09B, PAL_44401B: always @(*) vs posedge CK
    - CPU_CS_ACAL_17.v: TTL_74373 (latch) vs TTL_74374 (FF)
    Makefiles: added USE_LATCHES option (default=1) to sim/ and runSim/
    make compile -> latches (original behavior)
    make compile USE_LATCHES=0 -> flip-flops (FPGA mode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
    [CPU_CS_ACAL_17.v, PAL_44302B.v, PAL_44303B.v, PAL_44304E.v, PAL_44310D.v, PAL_44401B.v, PAL_45008B.v, PAL_45009B.v]
2026-03-28 Fix PAL_45001B stray semicolon causing BLOCK_reg stuck at 0
    Line 95 had a stray semicolon after the else-if condition, making
    BLOCK_reg = 0 execute unconditionally on every evaluation. This
    prevented BLOCK_reg from ever being set to 1 in simulation.
    Before: else if ((EPEA_n & MR_n) == 0);
    After: else if ((EPEA_n & MR_n) == 0)
    [PAL_45001B.v]
2026-03-28 Thread sys_rst_n to PAL modules for proper FPGA reset
    All PAL modules with edge-triggered FF registers now have async
    reset via sys_rst_n. This ensures correct initial state on FPGA
    hardware where registers power up in unknown state.
    Signal path: ND120_TOP -> ND3202D -> BIF_5/MEM_43 (already had it)
    -> BIF_DPATH_9, BIF_BCTL_6, MEM_LBDIF_48, MEM_DATA_46, MEM_ERROR_47
    -> BIF_DPATH_LDBCTL_12
    -> All 7 PAL modules with FF registers
    Reset values:
    - EBADR_n_reg = 1 (EBADR inactive at reset)
    - All others = 0 (inactive at reset)
    Comparison test shows all PAL signals now match between latch and
    FF modes after reset stabilization. Only remaining divergence is a
    transient BDRY=1 in first 3 latc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
    [BIF_5.v, BIF_BCTL_6.v, BIF_DPATH_9.v, BIF_DPATH_LDBCTL_12.v, MEM_43.v, MEM_DATA_46.v, MEM_ERROR_47.v, MEM_LBDIF_48.v]
2026-03-28 Add latch vs FF signal comparison tool
    New tool: sim/latch_ff_compare.cpp
    Logs key PAL register signals at every posedge OSC as CSV.
    Run in both latch and FF modes to detect behavioral divergences.
    Usage:
    make compare_latch -> trace_latch.csv
    make compare_ff -> trace_ff.csv
    make compare -> runs both and diffs
    Signals tracked: EMD, CBWRITE, CMWRITE, BACT, EBADR_n, DAP,
    BLOCK, RERR, BDRY, DISB, TST, BLOCKL, plus CSA, TERM_n, MCLK.
    Also adds -Wno-SYNCASYNCNET to suppress warnings from async
    reset in both sim/ and runSim/ Makefiles.
    [latch_ff_compare.cpp]
2026-03-29 Reduce FPGA pin count, fix UART baud rate, improve ROM BRAM inference
    ND120_TOP: Bus ports wrapped with ifdef VERILATOR_SIM. FPGA builds
    only expose sysclk, btn1, btn2, uartRx, uartTx, led[5:0] (10 pins).
    Bus signals tied to safe defaults internally for standalone operation.
    UART (SC2661_UART): Baud rate now calculated from BOARD_CLK_FREQ and
    UART_BAUD_RATE defines. Defaults to 100MHz/115200=868 for Basys3.
    Simulation keeps fast DELAY_FRAMES=16 via VERILATOR_SIM ifdef.
    ROM (CPU_CS_PROM_19): Fixed attributes for BRAM inference on both
    Xilinx and Gowin. Added address register pipeline for clean BRAM
    output register pattern. Array indexing fixed to [0:N] style.
    Latch control: Renamed ifdef f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
    [CPU_CS_ACAL_17.v, CPU_CS_PROM_19.v, ND120_TOP.v, PAL_44302B.v, PAL_44303B.v, PAL_44304E.v, PAL_44310D.v, PAL_44401B.v]
2026-03-29 Minor fixes: RALU ports, TTL_74374 init, sim defaults, Gowin device
    - CGA_CPU_ALU_RALU: Added sysclk/sys_rst_n input ports (for FPGA)
    - TTL_74374: Added initial value (= 8'b0) for FPGA register init
    - test_nd120.cpp: Set startTrace=0, maxTicks=1M as defaults
    - ND-120-Gowin: Changed target from GW1NR-9C to GW2AR-18C (Tang Nano 20K)
2026-03-29 Update .gitignore for build artifacts and temp files
    Added: comparison tool output (trace_*.csv, obj_dir_latch/ff),
    waveform dumps, Gowin user state, IDE settings, generated files.
    BPUN files are NOT ignored (needed for CPU testing).
2026-03-29 Add README for ND-120 simulation devices detailing architecture, components, and usage
2026-03-30 Eliminate D_FLIPFLOP combinational loop warnings for FPGA
    Added ACTIVE_ASYNC parameter to D_FLIPFLOP (default=0):
    - ACTIVE_ASYNC=0: Clean posedge FF, no combinational loop (FPGA-friendly)
    - ACTIVE_ASYNC=1: Async preset/reset (original behavior for instances that need it)
    Of ~87 D_FLIPFLOP instances, only 15 use active preset or reset signals.
    These 15 instances now explicitly set ACTIVE_ASYNC=1. All others use the
    clean synchronous path, eliminating LUTLP-1 warnings in Vivado.
    Signal comparison confirms zero behavioral change between latch and FF modes.
    Also fixed compare_ff Makefile target to use VERILATOR_SIM + FPGA_FF_MODE.
    [MEM_ADEC_45.v]
2026-03-30 Break PAL_44601B combinational loop by using internal register wires
    PAL16R6 registered outputs (TERM_n, CC0_n-CC3_n) were feeding back
    through the output port assigns into the combinational next-state
    logic, creating loops that Vivado reported as LUTLP-1 warnings.
    Fix: read directly from the register (s_term_n_int = ~TERM_reg)
    instead of from the output port (TERM_n = OE_n ? 0 : ~TERM_reg).
    Functionally identical since OE_n is always 0 on the 3202D board.
    Signal comparison confirms zero behavioral change.
    [PAL_44601B.v]
2026-03-30 Update constraints, TODO, migration plan, and repo XDC
    - constraints_minimal_cpg236.xdc: Updated for 6 LEDs, added
    ALLOW_COMBINATORIAL_LOOPS and relaxed timing docs
    - ND120_TOP.v: Minor USE_TRANSPARENT_LATCHES define placement fix
    - TODO.md: Rewritten in markdown, verified completed items,
    moved CPU_15 disconnected signals to completed (all connected)
    - verilog-remove-latch.md: Updated with all completed work status
    - SC2661_UART.v: Baud rate parameterized (committed earlier, staging)
    - CPU_CS_PROM_19.v: ROM BRAM inference improvement (committed earlier)
    [ND120_TOP.v]
2026-07-23 nd-bus-seam-gate: ND-BUS device seam + NDDeviceCore integration (squash)
    Squash of the nd-bus-seam-gate branch onto main. Highlights:
    - NDDeviceCore portable C device cores added as a submodule at
    Verilog/ND-BUS-DEVICES/portable (shared with the RP2350/Pico firmware);
    simDevices adapter/shim binds them to the Verilator ND-BUS
    (-DND120_DEVICECORE). Floppy READ_FORMAT geometry from image size.
    - PAL_44801A bus-arbiter transcription fixes + arbiter testbenches;
    IDENT stale-bus leak fix; NDCoreShim pre-BDRY DMA read fix.
    - ND-BUS device RTL (BUS-IF, DMA, FLOPPY, FLOPPY-DMA, SMD, TAPE-400)
    and testbenches; floppyTester conformance suite.
    - Tang Nano 20K: SDRAM BANK2 fix (full 4MB main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
    [CGA_ALU_.circ, CGA_DCD_.circ, Table.xlsx, nd110_nd120_mic_map.tsv, nd120_symbols.tsv]
2026-08-25 nd-bus-seam-gate: SINTRAN III boots on FPGA silicon (squash)
    Squash of the nd-bus-seam-gate branch since the previous squash
    (cd9b94f, 23-JUL-2026). The branch keeps the individual commits and the
    measured evidence behind each fix; this is the collapsed view.
    THE RESULT: SINTRAN III boots on the Tang Nano 20K (24-AUG-2026) from a
    Winchester disc image on an SD card - banner, login, LIST-FILES and the
    S3 program. The operating system runs on the recreated CPU.
    Faults found and fixed, each proven on hardware:
    - Memory bank decoded from the wrong side of the bus transceiver
    (ND3202D.v:533). On an incoming DMA write the board drives nothing,
    that net idles all-ones, so every transfer deco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
    [CGA_MAC_.circ, CGA_TRAP_.circ, bus_banner_bus.csv, dbrload_dbr.csv, eacomp_ea.csv, memload_ml.csv, out_banner_out.csv, raorigin_ra.csv]
2026-08-25 fix(nexys): main RAM moved from aliasing BRAM to DDR2 with a BRAM cache in front
    The BRAM backend held 64K words per bank (ND120_BLOCKRAM_ADDR_BITS=16)
    while PAL_44446B advertised the full 4 MB window, so every access above
    word 0o200000 in a bank aliased silently onto low memory - which forbids
    SINTRAN and corrupted anything large. Main memory now lives in the DDR2:
    - MEM_RAM_49_DDR2 (fpga/nexys4ddr/ddr2/): sheet-49 backend with a
    direct-mapped 128K-word write-through cache (8-word lines, one 128-bit
    DDR2 transfer per line). A cache hit answers in one sysclk like BRAM.
    A miss stretches the memory cycle by freezing PAL_44803A/PAL_44902A
    through a new HOLD input: the CPU waits via CG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
    [MEM_43.v, MEM_RAMC_50.v, MEM_RAM_49_SIM.v, ND120_CORE.v, ND3202D.v, PAL_44803A.v, PAL_44803A_tb.v, PAL_44902A.v]
2026-08-25 nexys bring-up batch: UART TX-interrupt fix, Am9150 CCLR sweep, ERRFA probe, board test kit
    Fixes found during the Nexys ERRFATAL / instruction-verify campaign:
    - SC2661_UART: a THR write now drops TBMT (status bit 0) the SAME cycle,
    and the TX idle branch no longer re-asserts it on the write cycle. The
    console TX interrupt BINT10 = IOC2 & TBMT is level-sensitive, so the old
    one-cycle window re-entered the level-10 handler and overwrote THR on
    interrupt-driven output. Regression: test-uart-txint (fails against the
    pre-fix model); test-uart and test-uart-txabort unchanged.
    - Am9150 (cache used/valid bits): CCLR was a no-op - a /R falling edge now
    restarts a write-port sweep clear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
    [MEM_RAM_49_BLOCKRAM.v, dma_p3_main.cpp, nd120_errfa_wdiox_ring.v]
2026-08-25 fix(nexys): SINTRAN III boots - DDR2 cache dropped hit-updates on late write strobes
    MEM_RAM_49_DDR2.v qualified the cache update with the LIVE tag lookup
    (whit = wr_edge & hit). When the DDR2 write strobe landed late (stretched
    cycles, refresh interleave) the address bus had drifted, the tag compare
    read a foreign line, and the update was dropped while DDR2 took the
    write - one stale cached word, nondeterministic target per boot: quiet
    PIL-11 spin, ERRFATAL variants, or silent WAIT.
    Fix: latch the hit verdict at A_CHK (hit_q) and use it for late strobes.
    Validated on silicon: 5/5 reprogram+20500& cycles reach the SINTRAN
    banner + Watchdog in ~40 s, console login works - first SINTRAN boot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
    [MEM_43.v, ND120_TOP.v, nd120_nexys4ddr_top.v]
2026-08-25 fix(nexys): DDR2 arbiter - fairness, watchdog, orphan-response flag
    nd_ddr2_arb.v had three dormant defects:
    - strict-A priority could starve the storage client under a zero-gap
    main-memory stream; ties now alternate (last_was_a)
    - a dead DDR2 port froze the machine with no trace; a 2^16-ui_clk
    watchdog now sets sticky dbg_stuck - deliberately report-only, the
    grant is held and no completion is invented (a faked response
    mid-operation is the stale-word corruption class)
    - a response arriving with no grant held vanished silently; sticky
    dbg_orphan records it
    New ND_DDR2_ARB_tb.v (make test-ddr2arb, registered in run_all_tests.sh):
    steering/data, fairness under a worst-case legal st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
2026-08-25 feat(nexys): board debug panel - RGB health LEDs + 8-digit live display
    - LD16 = DDR2/arbiter health: green calibrated+healthy, red dbg_stuck
    (watchdog fired), blue dbg_orphan; sticky until reset
    - LD17 = memory traffic: green CPU running, red MEM_HOLD (cache-miss)
    activity, blue storage client on the DDR2 port; ~6% PWM dim
    - left four 7-seg digits (previously blanked) are a live panel: PIL,
    DDR2 bridge state + MEM_HOLD, bridge detail bits, health flags;
    new SevenSegDebug8.v drives all 8 digits, right 4 unchanged
    - eyes-only cross-domain bits go through 2-FF synchronizers, and
    build.tcl bounds the cpu/ui -> sys_clk crossings datapath-only
    (first panel build failed timing at WNS -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
    [SevenSegDebug8.v, nd120_nexys4ddr.xdc, nd120_nexys4ddr_top.v]
2026-08-26 feat(nexys4ddr): clock-up - 45.45 MHz CPU + 115200 console boots SINTRAN
    Frequency search, ten full post-route implementations (evidence per run in
    timing-analysis/, analysis in timing.md and TIMING_CLOSURE_REPORT.md):
    every step 25 to 45.45 MHz closes the default flow; 50 MHz needs
    phys_opt_design and is single-seed fragile (a one-constant edit re-rolled
    it to -0.210). Silicon: SINTRAN boots at 50 MHz (9600 build) and at
    45.45 MHz with the 115200 console - the deployed configuration.
    One critical-path family at every clock: WCS microcode BRAM through the
    full microcycle (CSIDBS/INTR/ALU/FIDBO/TRAP/PALs/MIC/ACAL) to the WRF
    clock-enables, 29-30 LUT levels, routing-dominated.
    build.tcl: the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
2026-08-26 feat(tang): fast20 variant - 20.25 MHz + 115200 console boots SINTRAN, timing-clean; docs for the clock-up campaign
    New -Variant fast20: rPLL branch CLKOUT 40.5 MHz (SDRAM pair) / CLKOUTD
    20.25 MHz (CPU) on a 648 MHz VCO; BOARD_CLK_FREQ 20250000; console 115200
    7E2 scoped to this variant only, so the 9600-baud tooling for slow/mid
    stays valid. Gowin STA: TNS 0, CPU-domain Fmax 20.556 MHz - 1.5% margin,
    recheck the .tr on every rebuild. Silicon: SINTRAN boots, banner plus
    Watchdog in about 40 s, clean text on a 115200 7E2 console. Fastest
    timing-clean Tang; the 27 MHz variant runs 32% past its own Fmax.
    Docs: fpga/README.md gains a per-device fabric comparison (measured ns per
    logic level on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
2026-08-26 docs(fpga): bitstream release plan + Nexys quickstart with both deployment paths
    RELEASE-PLAN.md records the 26-AUG decisions: GitHub Releases carry four
    ready-built bitstreams (fast + safe per board, baud in every filename),
    the SINTRAN disc image is instructions-only (not distributed), and the
    Nexys copy-to-SD config path becomes the headline only after a hardware
    verification.
    QUICKSTART-nexys4ddr.md documents both Nexys deployment paths in full:
    USB (JTAG volatile via Vivado Lab Tools or openFPGALoader, plus
    persistent QSPI-flash programming) and microSD-card configuration (JP1
    to USB/SD, one .bit plus the disc image on one card) - the SD section
    carries an explicit NOT-YET-VERIFIED ban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
2026-08-26 feat(fpga): all release configurations at 115200; baud build argument; release artifacts staged
    Ronny's call: every release bitstream runs the console at 115200 7E2 -
    one terminal setting for all files. Tang: UART_BAUD_RATE is now 115200
    for every variant (tooling note added: console scripts that opened 9600
    must open 115200 against new bitstreams). Nexys: build.tcl gains
    -tclargs baud <9600|115200> (default 115200), same two accepted argument
    forms as clk.
    Release plan and Nexys quickstart updated to the all-115200 file list.
    The four artifacts are staged in fpga/release-staging/ (gitignored):
    the silicon-verified 45.45 MHz Nexys and fast20 Tang bitstreams kept
    byte-exact (a rebuild would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
2026-08-26 docs(fpga): Nexys SD-config steps verified against the reference manual
    Read from nexys4ddr/docs/nexys4ddr_rm.pdf (section 3.3, Figure 3): the
    SD path needs TWO jumpers - JP1 Programming Mode to USB/SD (callout 16)
    AND JP2 Media Select to the SD side (callout 3, next to the slot) - plus
    the PROG button or a power-cycle. BUSY steady = reading the card, DONE =
    configured; a single .bit in the FAT root is required and a wrong-part
    .bit is rejected. The remaining unverified item is narrowed to the
    SD-slot hand-over: config controller done, then the ND-120's own SD/FAT
    stack mounting the disc image from the same card.
2026-08-26 docs(fpga): Nexys SD-card deployment VERIFIED on hardware
    Measured 26-AUG-2026 on the board: the config controller loads the .bit
    from the FAT32 root and the running ND-120 then mounts the disc image
    from the SAME card - one card, two files, no software on the PC. The
    working jumper set: JP1 cap moved to pins 3-4 (USB/SD; factory default
    1-2 is a different mode) and JP2 to the SD side. Quickstart Path 2
    banner is now VERIFIED WORKING with the measured steps and two new
    troubleshooting rows; release-plan work-list item 1 closed.
2026-08-26 docs(fpga): Tang Nano 20K quickstart for the bitstream release
    openFPGALoader install matrix (apt/brew/oss-cad-suite/Gowin GUI),
    persistent SPI-flash command (-f) vs volatile SRAM load, the WSL usbipd
    attach note, why this board has no SD-card configuration (SD slot goes
    to fabric, flash-once gives the same power-on convenience), disc-image
    instructions, 115200 7E2 console on the second serial port, OPCOM smoke
    test, boot walkthrough and troubleshooting. Release plan work item
    closed; release tag name settled: bitstreams-2026-08.
2026-08-26 docs(fpga): SD-config path downgraded to partially working - hand-over bug isolated
    A/B measured 26-AUG: config from the card works (OPCOM answers), but the
    ND-120's SD stack then cannot mount the SAME card - every disc boot hangs
    with FDISK error 3 (NOTOPEN; init reached ready, the filesystem scan
    failed). Loading the byte-identical bitstream over USB boots tape, floppy
    and SINTRAN from that same card, so the card is exonerated and the fault
    is the config controller's card hand-over state. Path 2 banner now says
    so and points at Path 1 for disc boots.
2026-08-26 fix(nexys4ddr): power-cycle the SD slot on configuration, reset and MACL
    The card itself was never reset: sd_reset was a constant 0 (slot always
    powered), so nothing our logic did could clear card state. Two measured
    consequences: after SD-card configuration - where the board's
    microcontroller has used the card in SPI mode, which only a power cycle
    exits - every disc operation failed with FDISK error 3 while the same
    card booted everything over JTAG; and a console MACL never reached the
    disc subsystem at all.
    New power-cycle controller in the storage clock domain: on ANY trigger
    (configuration/POR, CPU RESET/BTNC, or a DEBUG_MR_n master-clear pulse,
    2-FF synced from the CPU domain) the slot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
    [nd120_nexys4ddr_top.v]
2026-08-26 fix(nexys4ddr): system clear (CLEAR_n) also power-cycles the SD slot
    DEBUG_CLEAR_n - the machine's own system-clear line out of the IO block,
    the reset every real ND-bus peripheral saw - is now the third power-cycle
    trigger next to configuration/POR and master clear, 2-FF synced into the
    storage domain. Whenever the CPU clears the machine, the disc subsystem
    starts from a freshly powered card.
    [nd120_nexys4ddr_top.v]
2026-08-26 test(nexys4ddr): MACL-then-boot board script for the SD power-cycle
    Run from a machine at OPCOM (a running SINTRAN swallows console input
    without echo, so MACL never arrives - measured). PASS on silicon
    26-AUG-2026: MACL -> slot power cycle -> re-mount -> 20500& reaches
    SINTRAN III RUNNING and the Watchdog.
2026-08-26 docs(fpga): SD-card deployment verified end to end with the power-cycle fix
    27-AUG-2026, on the board: configure from the card, then boot SINTRAN
    from the same card. Path 2 banner upgraded; notes that pre-fix
    bitstreams remain OPCOM-only on this path.
2026-08-26 docs: SD-card deployment end-to-end result in board README, release plan and HISTORY
2026-08-27 fix(tang tooling): console scripts default to 115200 - every bitstream built after 26-AUG talks 115200 7E2
    Baud constants and --baud defaults only; each script's framing choice is
    untouched. Comment lines describing old captures left as history. 9600
    remains reachable via --baud for pre-27-AUG bitstreams (usb-attach.sh
    banner says so).
    [boot_sintran.py, capture_floppy.py, capture_mem.py, capture_seg.py, capture_stack.py, capture_trap3.py, grant_capture.py, measure_s3.py]
2026-08-27 fix(tang tooling): remaining --baud defaults to 115200
    [listen_console.py, pflog_capture_decode.py, ptord_capture_decode.py, ptwr_capture_decode.py, tang_validate.py]
2026-08-27 test: memchain - SIM variant now expects preserved bad parity
    MEM_RAM_49_SIM changed 11-AUG-2026: a write whose parity bit disagrees
    with its data sets a per-byte-lane corruption flag, and the read-side
    regenerated parity is XORed with it, so readback parity equals the
    WRITTEN parity bit. That is deliberate (the AM29833A forced-error /
    TPE CONFIGURATION ECC-simulate probe must survive to the read; healing
    it ended in ERRFATAL on the Tang, 11-AUG-2026). MEM_CHAIN_tb.v still
    expected the old absorb-everything behavior, so test-memchain-sim
    failed 36 checks on the parity bits DD[8]/DD[17].
    Under CHAIN_USE_SIM the expectation is now readback == written (all 18
    bits) and the sweep asserts the in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
2026-08-27 test: register 100 orphan testbenches across 16 sim dirs (backlog burn-down)
    All 100 already had make targets in their own sim/ Makefiles but no
    registry line, so nothing ever ran them. Each was run through the
    runner's exact three checks (make exit 0, no FAIL string in output,
    TB_RESULT: PASS present) before being added - all 100 pass.
    Areas: Shared/support 19, Shared/ndlib 30, Shared/logisim 9,
    CPU-BOARD-3202/sim 18 (incl latch/ff pairs), DGA 2, CGA_ALU 4,
    CGA_DCD/IDBCTL/INTR/MIC/TESTMUX 5, CGA_WRF 2, ND-BUS-DEVICES 3,
    SD-FAT 8. TESTBENCH-CATALOGUE.md regenerated by tests/tb_catalog.py.
    tb_catalog --check: 101 -> 5 unregistered. The 5 left are red or
    out of scope, deliberately NOT regist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
2026-08-27 test+docs: memchain-sim/-blockram registered; TODO backlog section brought current; plan statuses
    The 27-AUG burn-down state recorded: 101 -> 5 unregistered, all four old
    orphans registered, memchain resolved (stale SIM-variant expectation).
    The 5 remaining are documented per-case in TODO.md - including
    CYC_STRETCH_STROBES, whose FAIL is a live finding for the open Nexys
    wrong-PPN investigation, not a stale bench.
2026-08-27 test(fpga): 4-hour soaks PASS on both boards - 8/8 probes each
    Nexys at 45.45 MHz and Tang fast20 at 20.25 MHz, each running the exact
    release artifact, each answering every 30-minute console-attention probe
    over 4 unattended hours with byte-identical responses. Remaining unproven
    at speed: SD-card write workloads.
2026-08-27 docs: soak results, green-suite state and CI recorded across the documentation
    CLAUDE.md status + test-suite section (328/328, the reasoned-baseline
    convention, the CI jobs), both board READMEs, the fpga device-comparison
    table, HISTORY row for the 27-AUG test day, and the release-plan artifact
    table now showing every file's silicon verification depth.
2026-08-27 ci: Verilog test/netlist gates on every push, Tang OSS bitstream on release tags; Pages actions bumped
    New verilog-ci.yml, sized by measurement: the full testbench registry
    (328 entries, 33.5 min local) + tb-catalog/audit meta-gates on every push
    and PR with apt iverilog/verilator/mtools/dosfstools; the Tang yosys
    netlist gates (tristate contract + latch census, proven on apt yosys 0.9)
    likewise; and on bitstreams-* tags or manual dispatch the full OSS
    bitstream build (oss-cad-suite: yosys -> nextpnr-himbaechel -> gowin_pack)
    uploaded as a workflow artifact - deliberately NOT attached to releases,
    which carry only silicon-verified vendor-flow builds. Every job first
    regenerates the gitignore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
2026-08-27 probe(nexys4ddr): PT-write-during-freeze overlap detector - wrong-PPN option 1
    New DBG_PTW_LVL: the LIVE ~EPT_n & ~WMAP_n strobe conjunction out of
    CPU_MMU_24 (the edge-detected DBG_PTW stream cannot show elongation),
    threaded CPU_MMU_24 -> CPU_15 -> ND3202D -> ND120_CORE. The Nexys top
    ANDs it with MEM_HOLD into a sticky flag + 16-bit cycle counter:
    sticky never set across a boot = a PT write NEVER overlaps a DDR2
    freeze and the write-during-freeze corruption hypothesis dies; set =
    the ILA nets (s_ila_ptwhold_stk/cnt/lvl, added to the ilaslim probe
    set) capture what moves inside a window. Panel digit 4 bit 2 shows the
    sticky live. Background: CYC_STRETCH analysis 27-AUG - a stretched
    grant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
    [CPU_15.v, CPU_MMU_24.v, ND120_CORE.v, ND3202D.v, nd120_nexys4ddr_top.v]
2026-08-27 probe(nexys4ddr): fix instantiation comma in ND3202D DBG_PTW_LVL threading
    [ND3202D.v]
2026-08-27 probe(nexys4ddr): DBG_PTW_LVL declared unconditionally - it sat inside the MAIN_RAM_SDRAM port block and vanished on DDR2 builds
2026-08-27 plan(mega65): new board folder - R4+ target, virtual drives + keyboard/display via the framework path
    Standard board-folder structure (Makefile placeholder answering the
    common API, README, docs/00-plan.md). The plan: the Nexys nd_ddr2_port
    seam is the porting boundary (cache + MEM_HOLD layer ports unchanged), a
    proven community SDRAM controller behind a new nd_sdram_port, the
    MiSTer2MEGA65 virtual-drive facility and keyboard+video console as goals
    (bare-metal vs framework decision open pending two research reports),
    .cor distribution as the end state. Reuse ledger and Nexys-derived risk
    list included; hardware facts carry their sources.
2026-08-27 plan(mega65): phase-0 decisions recorded - MJoergen/SDRAM backend, hybrid bare-metal-then-M2M path
    RAM: MJoergen/SDRAM (MIT, one 166 MHz clock, documented bounded latency,
    sim env; ~150-line Avalon adapter, active-low-vs-high mask inversion the
    one trap; storage region base must move below 64 MB). HyperRAM fallback
    for R3. Framework: hybrid - vdrives verified source-level to fit our
    device seams and could retire the FAT stack, but Winchester-class
    throughput through the QNICE soft CPU is unmeasured (new phase 3.5
    benchmark gates it), and the console under M2M means building a
    keyboard+HDMI terminal front-end, which once built serves both tops.
2026-08-27 plan(mega65): console front-end research recorded - VGA-first via the VDAC, keyboard chain exists in mega65-core, terminal core written in-repo
    Display needs NO encoder: the FPGA drives the board's video DAC
    directly, so an 80x25 text core is the whole path (HDMI later via
    hdl-util MIT or the M2M-proven Tyto encoder). Keyboard: four mega65-core
    LGPLv3 files incl. matrix_to_ascii do the entire job, vendored as marked
    third-party under fpga/mega65 only. Terminal core: write in-repo (~400
    lines) to stay MIT - Searle's classic carries a never-charge clause,
    noted and avoided. Isolation rule recorded: nothing outside fpga/mega65
    changes for this port.
2026-08-27 docs(mega65): fold m65-altcores survey into README and plan
    - README: ecosystem-context section (~34 community cores, non-Commodore
    precedent, files.mega65.org + GitHub distribution convention, slot-count
    note) and a links/reference table.
    - 00-plan.md: board-revision facts from the alt-core catalogue (R3 vs R6,
    'Core hardware model mismatch!' enforcement, MegaInfo revision check)
    with an explicit R4/R5 discrepancy/gap note vs the plan's R4+ target;
    phase-5 release conventions (per-revision .cor naming, files.mega65.org
    entry, catalogue mail, the exact end-user install procedure for the
    QUICKSTART); catalogue added to the header source list.
    Every added fact cites its m65-altc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
2026-08-27 probe(nexys4ddr): wrong-PPN reproduction campaign closed - hypothesis dead on silicon
    Measured 27-AUG on the 45 MHz probe bitstream: (1) the overlap probe
    (DBG_PTW_LVL & MEM_HOLD) stayed sticky=0 count=0 across a complete
    SINTRAN boot - a page-table write never overlaps a DDR2 freeze under the
    boot workload, killing the PT-write-during-freeze corruption mechanism;
    (2) the fatal trap signature (TVEC 3 at PIL>=8) did not fire in two
    armed full boots plus ~16 armed idle/console minutes - the 25-AUG
    wrong-PPN ERRFATAL is attributed to the stale-word cache bug fixed that
    same evening. ila_ddr2hang.tcl gets an honesty fix: Vivado 2026.1's
    wait_on_hw_ila -timeout does not throw, it silently stops t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
2026-08-27 test(cyc): rewrite CYC_STRETCH_STROBES_tb as a contract-pinning gate, register as test-cycstretch
    The old bench reported 41 strobe divergences; the 27-AUG measurement showed
    39 of them were the bench's own artifacts: it counted INVERTED CYD/UCLK
    (the board consumes CYD active-high - CPU_MMU_24 WMAP_n, and the PAL history
    says CYD POSITIVE POLARITY), its count window grew with the stretch, it tied
    WAIT1=WAIT2=0 which turns on the wait-state bypass product terms (the board
    drives both to 1 during memory cycles, CYC_36), and it sampled a free-running
    FSM with no TERM anchor.
    The rewrite pins what PAL_44601B + PAL_44307C actually do, per TERM-anchored
    machine cycle, over grant arrival delayed 0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
2026-08-27 test: retire floppy_hwtest_core_tb - drifted to all-X output, its campaign is closed
    Ronny's call 27-AUG. Measured before deletion: 7/7 checks fail with
    undefined values through the whole report path, even built with the
    tool's own uart_tx - the bench drifted since the floppy CB-fetch
    campaign closed (bug fixed on silicon 23-AUG, and that fix is guarded by
    the registered Winchester/DMA benches). The hardware test tool itself
    (floppy_hwtest_top/core) stays. With this the audit gate reaches
    0 orphans / 0 Makefile-less sim dirs for the first time, unblocking the
    Verilog CI test job.
2026-08-27 test: keep the runner's FAIL-grep out of the catalog gate's own output
    The registry runner flags any log containing the standalone word after a
    non-letter (run_all_tests.sh:676), and the catalog gate PRINTS every
    ORPHAN_BASELINE reason - the detector entries said 'deliberately
    FAILING', so the first-ever green catalog run was flagged by its own
    documentation. The oldest baseline entry even warns about exactly this
    ('keep the word F-A-I-L out of this text'); the newer entries now follow
    it: reworded to RED/red, meaning unchanged. Never fired locally because
    the catalog gate was fail-fast-red until 27-AUG.
2026-08-27 test: registry - back out the six Terminals entries that rode in on the chmod commit
    git update-index --chmod=+x stages file CONTENT, not just the mode: the
    exec-bit sweep captured the in-development terminal-core registry
    entries from the working tree while Verilog/Terminals/ itself is not
    committed, so CI failed on 'Terminals/sim: No such file or directory'.
    The entries return together with the Terminals directory when that
    workstream lands.
2026-08-27 test: prom19 links the PROM images from Code/Microcode - the tracked originals
    The rule linked ../circuit/AM27256_*.hex, which exist only as untracked
    local copies (the pattern is gitignored), so a fresh clone - and CI -
    failed with NO_PROM_IMAGE while every local tree passed. Code/Microcode
    holds the tracked source of truth.
2026-08-27 test: cycle-timeline golden diff ignores vvp's finish banner
    Newer iverilog/vvp (the CI runner's) prints '$finish called at ...' to
    stdout; iverilog 11.0 locally does not, so the golden diff gained one
    line only on the runner. The banner is tool chatter, not timeline - the
    filter that already strips TB_RESULT now strips it too.
2026-08-27 test: testmux Makefile - Shared/ case and library flags fixed
    SHARED_COMPONENTS pointed at lowercase shared/ (works on the
    case-insensitive Windows drive, does not exist on a Linux runner) and
    two of the three flags were a double-dash --I typo that both tools
    silently swallowed locally. Now -y library dirs with the real casing;
    both test-testmux and the verilator test_testmux build verified locally.
2026-08-27 test: repo-wide Makefile sweep - Shared/ casing and library flags
    40 sim Makefiles carried the same template line pointing at lowercase
    shared/ndlib|logisim|support with --I flags - invisible on the
    case-insensitive Windows drive, module-not-found on a Linux runner
    (CI rounds 8-9: testmux, then irsrc). All normalized to -y with the
    real casing; the CYC_36 variant's shared/gates and shared/Support-Chips
    never existed under any casing and now point at the real module homes.
    Proof: full make test after the sweep - ALL 336 TESTS PASSED (2329 s),
    audit and catalog gates included.
2026-08-28 test: untrack the committed dma-master .vvp - build artifacts break on tool upgrades
    nd_dma_master_tb.vvp was tracked, so a fresh checkout (CI) sees it newer
    than its sources and runs the stale binary: 'VVP input file 11.0 can not
    be run with run time version 12.0'. The Makefile rule already rebuilds
    from source once the file is absent. *.vvp now ignored repo-wide - it
    was the only tracked one.
2026-08-28 docs+test: markdown dead-link gate, 29 rotten links fixed, toolchain-traps section
    New tests/check_md_links.py registered as test-docs-check: every
    relative link in every tracked .md must resolve. Born from the
    DEVELOPMENT.md/HARDWARE.md incident (README pointed at the repo root for
    five months while the files sat in tmp/, and a later search 'proved'
    they never existed). First run found 31 reports: 29 real - case
    mismatches alive only on the case-insensitive Windows drive, links to
    the pre-rename TOP_3202D, a PAL filename typo, one root-anchored
    E:-drive path, prose that matched the link syntax - and 2 checker parser
    bugs (filenames with spaces, %20 escapes), fixed.
    CLAUDE.md gains a 'Toolc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
2026-09-02 Merge mister: terminal core, MiSTer and MEGA65 boards, release 2
    Squash of 115 commits from the mister branch onto main.
    Board-independent terminal core (Verilog/Terminals): the TDV2200 console -
    800x600 screen, PS/2 keyboard, console UART (7E1 and 8N1), and the real
    TDV2200 box-drawing font (character set 2, dumped from RetroCore), embedded
    directly in font_rom.v so every board carries the correct glyphs with no
    loose hex to copy per build.
    Nexys 4 DDR: the real box font on silicon, the physical Left-arrow key fix
    (the USB-PS/2 bridge drops the E0 prefix; Left arrives as bare 0x6B), and a
    build-stamp line in the power-on banner.
    MiSTer (DE10-Nano): the TDV2200 console wired to the MiSTer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
    [CPU_15.v, CPU_MMU_24.v, CPU_MMU_CACHE_25.v, CPU_PROC_32.v, CPU_PROC_CGA_33.v, CPU_PROC_CMDDEC_34_tb.v, CYC_36.v]
2026-09-02 Merge mister: microcode raw-PROM decision, MiSTer boot screenshot, 7E1 doc fix
    Incremental squash of the mister work landed since the last merge to main.
    Microcode word 0o2002 decided (Ronny): the boards preload the RAW PROM word,
    the simulators run the 2024 patch (A,6 -> A,0 in the master-clear wait loop's
    outer count: 64 passes -> 1, a 64x shorter power-on wait, nothing else - not a
    bug either way). gen_wcs_image.py now writes wcs/ (raw, for the boards) and
    wcs-sim/ (--sim, for SKIP_WCS sim runs); Shared/support is raw again;
    test-microcode-sync checks every wcs_*.hex copy against the variant its
    directory must hold.
    MiSTer README: the hardware boot-screen screenshot (DE10-Nano at the #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
2026-09-03 docs(fpga): de-stale all board docs, add MiSTer quickstart, script release naming
    Squash of the doc-update branch.
    All four boards now match reality. Tang Nano 20K, Nexys 4 DDR and MiSTer
    (DE10-Nano) boot SINTRAN III on real silicon; the MEGA65 cores are built and
    timing-clean but not yet run on a MEGA65. The docs said otherwise in many
    places - "two boards", "MiSTer future target", "MEGA65 unproven", phase/plan
    scaffolding for finished work.
    Root README + HISTORY: three booting boards plus the MEGA65, a MiSTer machine
    entry and quickstart pointer, new milestone and history rows for the terminal
    core, the MiSTer boot and the MEGA65 cores.
    New Verilog/fpga/QUICKSTART-mister.md, linked from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
2026-09-04 mega65 docs: what every operator-panel field means
    New section "Reading the operator panel" in
    Verilog/fpga/mega65/docs/01-using-the-core.md: every field of the strip
    under the console text - UTILIZATION, CACHE HIT RATE, PROTECT RING,
    INTERRUPT, PAGING, the HDD/FLOPPY R/W boxes, UP: uptime, the ACTIVE LEVEL
    row, MIPS, the CPU R/G lamps - with what it reads and which signal feeds
    it in the MEGA65 build. Taken from the RTL: the rate meters' ~0.4 s
    window, the 2-frame ACTLV hold with the PIL fallback, the 1-second MIPS
    window, the inverted CPU lamps. Also says what is not there (DAY/TIME;
    the RUNNING/OPCOM legend cells draw nothing) so a blank area is not
    misread. Menu line 7 hides/shows the pa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
2026-09-04 mega65: RUN/STOP is EXIT (SLUTT), Alt+X proven; console tb counter race
    The TDV2200's SLUTT key (ESC [ 4 8 _) is how a SINTRAN program is left,
    and the MEGA65 keymap had no way to send it: there is no End key, and
    Alt+X - wired in the shared decoder - had never been exercised on this
    path. RUN/STOP (key 63) now sends the PC End scancode (E0 69, shift
    forced off), which ps2_ascii_table_tdv already maps to SLUTT. The C64
    keycap that means "stop this program" is the natural one; the framework
    only claims RUN/STOP while its menu is open, and then the core sees no
    keys at all (m2m_keyb.vhd enable_core_i).
    Tests: m65_keys_to_ps2_tb checks RUN/STOP, shifted RUN/STOP and Alt+X at
    the decoder (marke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
2026-09-04 Shared/support: the raw PROM word 0o2002 - dropped by the squash merge
    93fdb70 squashed the mister work onto main and its message says
    "Shared/support is raw again", but the two files were not in that
    commit: main kept the PATCHED word (A,0) in Verilog/Shared/support/
    wcs_28C.hex and wcs_image.hex, which is what the MiSTer's Quartus reads
    via SEARCH_PATH - the opposite of the decision (raw on the boards), and
    test-microcode-sync failed on main because of it. This restores the two
    files to the generator's raw output (byte-identical to
    Code/Microcode/wcs/), the same content as fb4c916 on mister.
2026-10-10 History: console framing row matches the UART and terminal code
    The SC2661 sends 8N1; the terminal core reads the same 10-bit frame as
    7 data bits + unchecked parity + 1 stop bit.
2026-10-18 Docs site: GitHub logo on the repository link, and the RetroCore Labs logo in the header
    The header's repository link shows the GitHub logo, and the organisation's profile picture sits
    next to it, linking to retrocorelabs.github.io. Done with a Material theme override
    (main.html plus the picture) kept beside the site config.
2026-10-21 ALD boot values: switch 9 is a mass load from 1560, and how it boots SCSI on an ND-3201
    IO_REG_41.v switch table: switch 9 (21560) is a mass storage load and run, as
    read off a CPU 3095 board (I12 = 21560B), not "Run (No load)". Switches 1 and 0
    get descriptions, the switch-6 "SCSI boot ..?" guess is removed, and a note
    says settings 1 and 9 also have bit 13 set.
    OPCOM-Boot-Reference.md: 1560 is the floppy/streamer controller (3106/3112),
    SCSI on an ND-3201 is at 144300. The bit-layout section said bits 14-16 hold a
    load mode; the tables contradict that, so it now states only the pattern the
    tables show. New section on 21560 with an ND-3201: the card's Z80 ROM plants an
    ND-100 SCSI driver a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
2026-10-21 IO_REG_41 module page: regenerate after the ALD switch table update
2026-10-21 OPCOM boot reference: what the microcode mass load sends, and the SCSI read
    From the MASS routine in ND-120-DELILAH-L.LISTING.txt (CSA 002217-002235):
    core address 0 twice, block address 0, word count 2000, control word 4 (bit 2
    alone, ACTIVATE DEVICE) to N+5, poll N+4, start at 0. ALD and a typed nnn&
    both enter it through LOAD1. That makes the first step of the ND-3201 chain
    read rather than assumed.
    The last open step is now measured: running the planted ROM driver in nd100x
    against SCSI-K.image, it reads the first 2048 bytes of the disc to address 0
    and jumps there. Also records the restart routine's bit-15 rule (load if 1,
    start at 20 if 0), which applies to power restore only.
2026-10-21 Logisim: SMD controller card 3044, memory address and word count block
    A Logisim-Evolution 3.8.0 drawing of card 3044 sheet 3 (ND-11.020.01, scan
    page 118) on the drawing's chip positions, pin numbers and signal names,
    with the Am2942 and 74LS54 as DIP subcircuits built from TTL parts and the
    AMD Am2942 data sheet (OCR, corrected against the scan) beside it.
    Three headless checks come with the generators: the 74LS54 on all 1024
    input combinations, the Am2942 over 246 clocked steps against a model
    written from the data sheet's function table, and a bench that plays the
    ND-120 MASS load (word count written once with 002000) and reads back a
    word count of 00 002000 and a memory address of 0.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
2026-10-21 SMD: model the 15 MHz card's memory address / word count flip-flop, make it the default
    The 15 MHz SMD card (ND-632, cards 3043/3044) has ONE flip-flop (4E) for the
    memory address and the word count, writes and reads alike. The first access
    of a pair loads all 24 bits (bits 16-23 from A bits 0-7 through the 11B byte
    swapper, bits 0-15 from A); the second loads bits 0-15 only. Reads give bits
    0-15 first, then bits 16-23. It does not toggle on +3, +5 or the ECC control
    register; device clear, a status read and the end of a transfer reset it.
    Read off card 3044 sheet 3 and simulated in Logisim/ND-BUS-DEVICES/SMD-3044.
    ND_SMD.v: s_maw_ff, s_mar_ff, s_wcw_ff and s_wcr_ff are replaced by one
    s_ma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
2026-10-21 ND120_CORE: no ");" inside the SMD comment
    The module doc generator ends the port list at the first ");" after the
    module name, so the comment cut the ND120_CORE page short after
    INCLUDE_WD (no ports, half the parameters).
2026-10-21 SMD: initiate seek (M4) completes as soon as the drive accepts it
    ND-11.020.01, "M4: Initiate seek": "As soon as this function is accepted
    by the disk, the operation will be completed." Normal End of Operation
    case 2 is On Cylinder dropping on the seek command, not the heads
    arriving; arrival is reported later through the seek-complete bits.
    The model held ACTIVE for the full completion delay (800,000 cycles in
    Verilator). SINTRAN polls status about 17,000 cycles after an M4 and
    then writes its next control word, which the card then flagged as an
    illegal load (status 040064); every retry of that request failed. With
    the fix a full 21540& boot of BIGDISK0-L2-100.IMG has no illegal load
    anywh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
